saschagrunert/avionics-panel/renders/1-hero.png

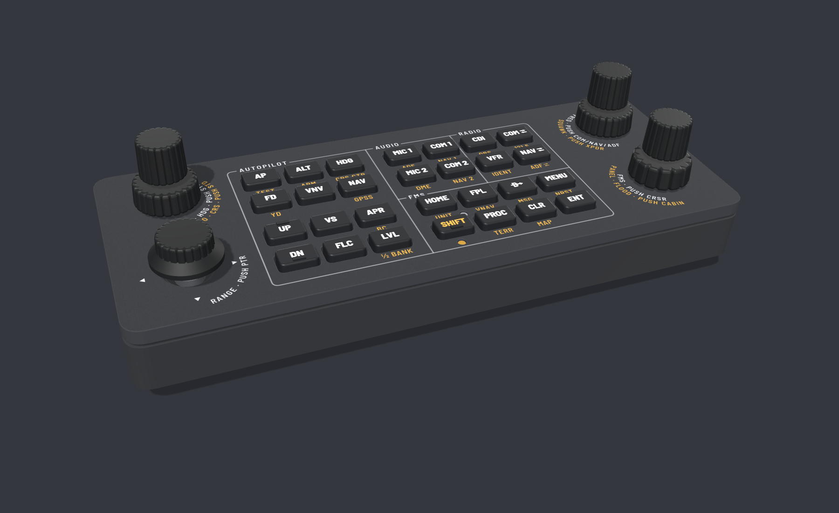
renders/1-hero.png
