saschagrunert/avionics-panel/renders/3-exploded.png

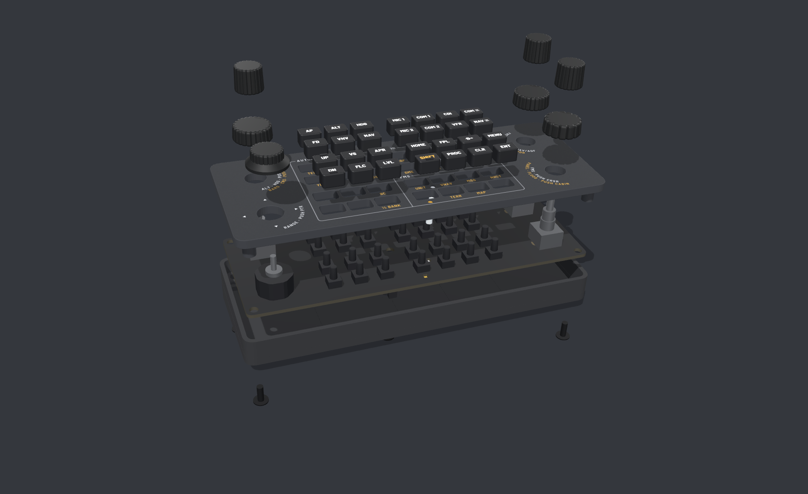
renders/3-exploded.png
