saschagrunert/avionics-panel/renders/4-seated.png

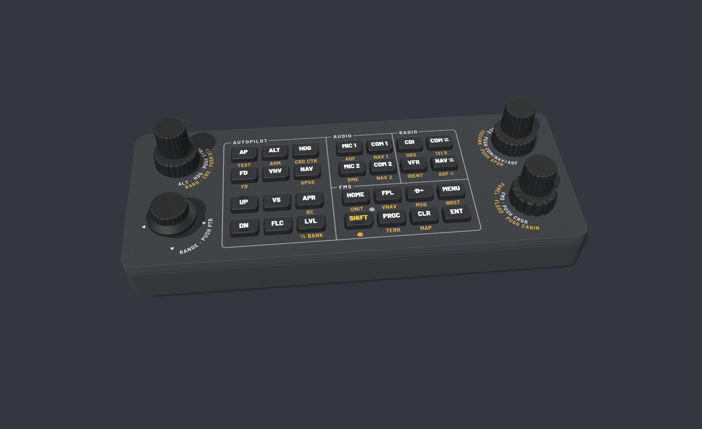
renders/4-seated.png
