saschagrunert/avionics-panel/renders/5-pcb-top.png

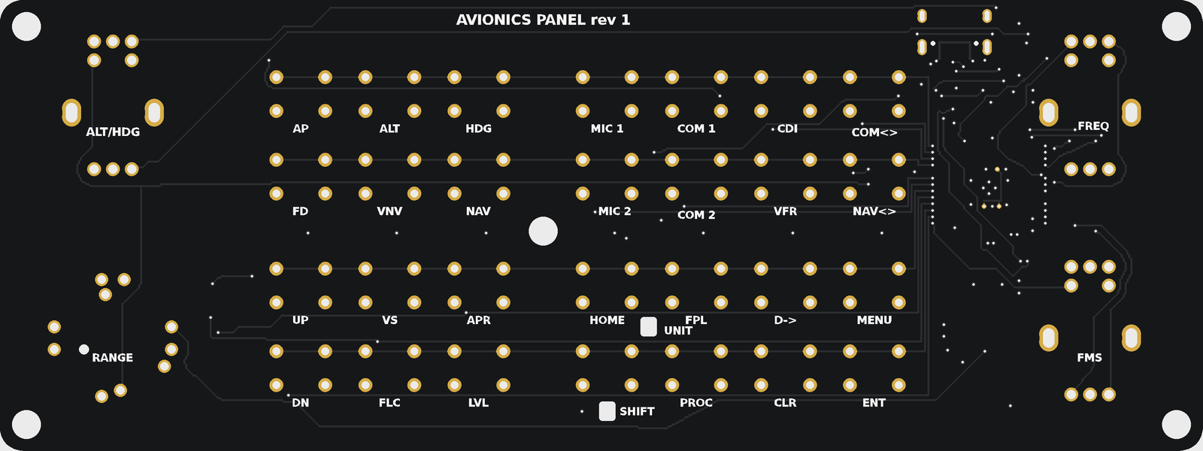
renders/5-pcb-top.png
