saschagrunert/avionics-panel/renders/6-pcb-bottom.png

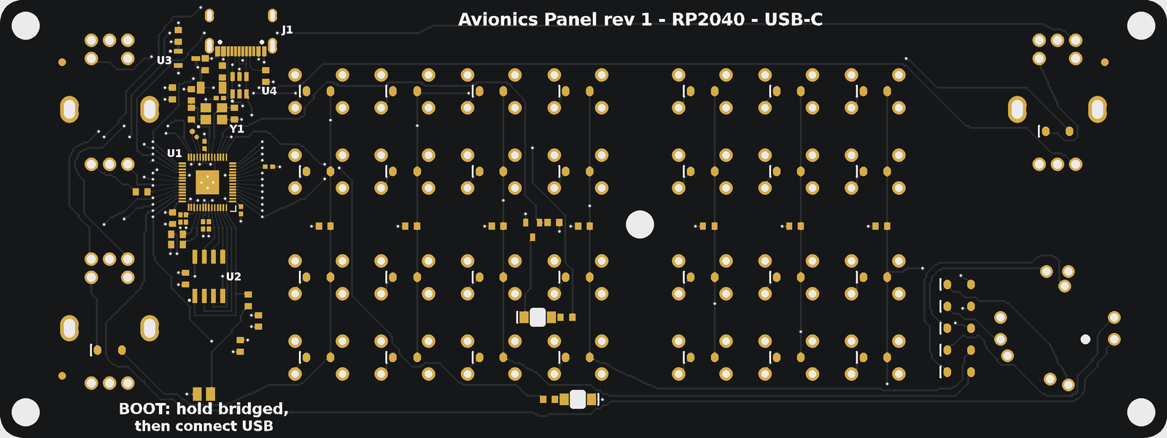
renders/6-pcb-bottom.png
