saschagrunert/avionics-panel/renders/7-plate-artwork.png

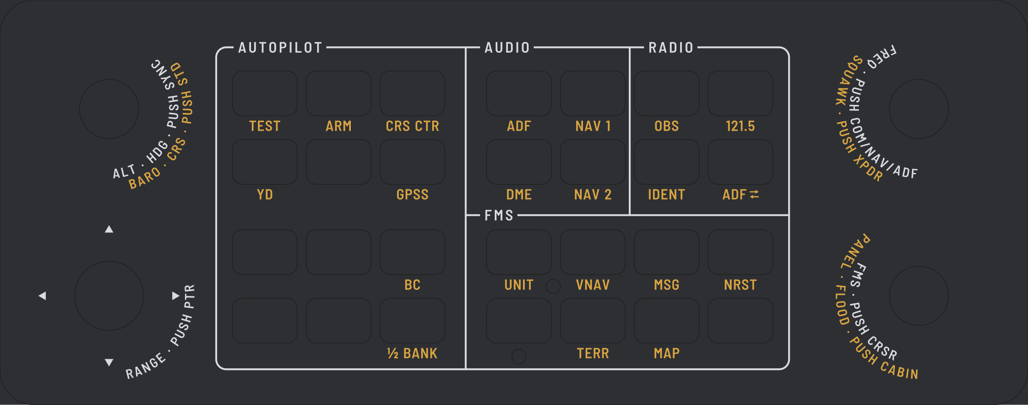
renders/7-plate-artwork.png
