saschagrunert/avionics-panel/renders/8-fit-check.png

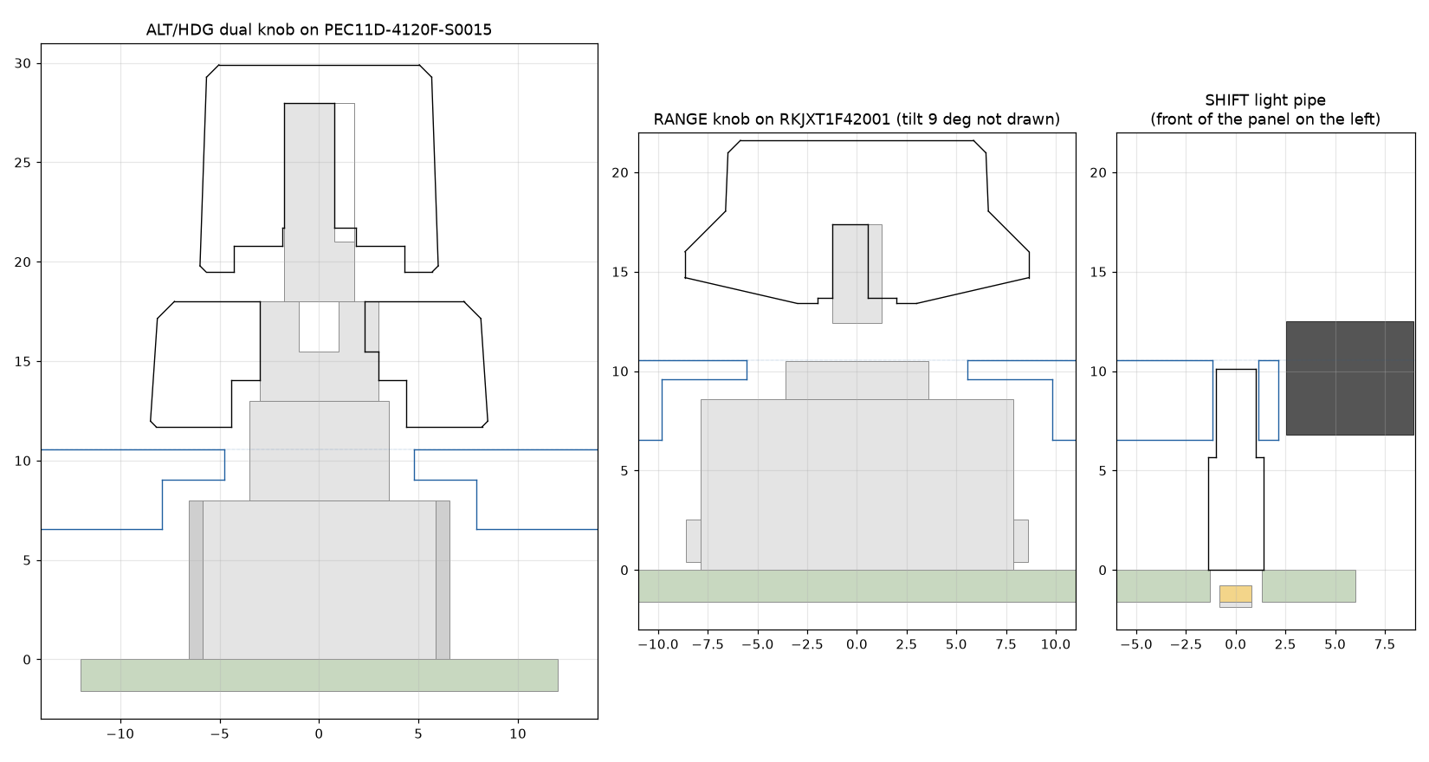
renders/8-fit-check.png
