saschagrunert/avionics-panel/renders/9-bottom.png

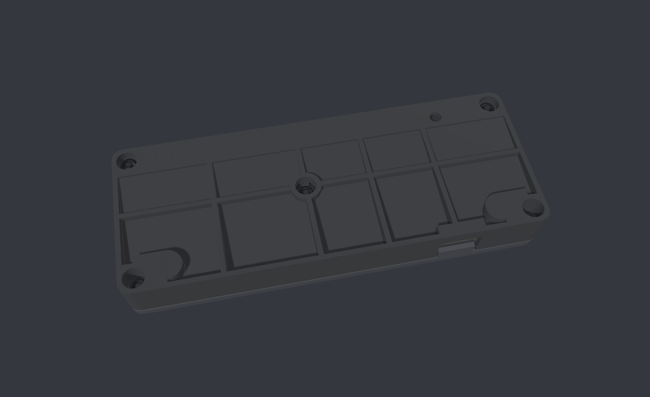
renders/9-bottom.png
