saschagrunert/avionics-panel/production/avionics-panel-rev1-BOM-full.csv

Comment | Designator | Footprint | LCSC Part # | Quantity
1N4148W | DK00,DK01,DK02,DK03,DK04,DK05,DK06,DK10,DK11,DK12,DK13,DK14,DK15,DK16,DK20,DK21,DK22,DK23,DK24,DK25,DK26,DK30,DK31,DK32,DK33,DK34,DK35,DK36,D_FMS,D_ALTHDG,D_RANGE_A,D_RANGE_B,D_RANGE_C,D_RANGE_D,D_RANGE_COM | SOD-123 | C81598 | 35
10k | R_PU0,R_PU1,R_PU2,R_PU3,R_PU4,R_PU5,R_PU6,R_UNIT_PD | 0603 | C25804 | 8
LTST-C230KSKT | LED_SHIFT | 1206 reverse | C125108 | 1
75R | R_SHIFT | 0603 | C4275 | 1
LTW-C230DS | LED_UNIT | 1206 reverse | C575513 | 1
390R | R_UNIT | 0603 | C23151 | 1
2N7002 | Q_UNIT | SOT-23 | C8545 | 1
RP2040 | U1 | LQFN-56 7x7 | C2040 | 1
1k | R_GP25,R_BOOT,R_X | 0603 | C21190 | 3
5.1k | R_CC1 | 0603 | C23186 | 1
5.1k | R_CC2 | 0402 | C25905 | 1
SRV05-4 | U4 | SOT-23-6 | C7420376 | 1
1R | R_IN | 0603 | C22936 | 1
MF-NSMF050-2 | F1 | 1206 | C75464 | 1
TYPE-C-31-M-12 | J1 | USB-C 16P | C165948 | 1
W25Q16JVSNIQ | U2 | SOIC-8 150mil | C2456211 | 1
100nF | C_FL,C_D1,C_D3 | 0603 | C14663 | 3
XC6206P332MR | U3 | SOT-23 | C5446 | 1
10uF | C_IN,C_OUT0 | 0603 | C19702 | 2
ABM8-272-T3 12MHz | Y1 | 3225 4-pad | C20625731 | 1
15pF | C_X1,C_X2 | 0603 | C1644 | 2
1uF | C_1V0 | 0402 | C52923 | 1
100nF | C_1V2,C_1V1,C_IO49,C_IO1,C_IO10,C_IO22 | 0402 | C1525 | 6
27R | R_DM,R_DP | 0603 | C25190 | 2
1uF | C_D2,C_BULK | 0603 | C15849 | 2
1-1825910-4 | K00,K01,K02,K03,K04,K05,K06,K10,K11,K12,K13,K14,K15,K16,K20,K21,K22,K23,K24,K25,K26,K30,K31,K32,K33,K34,K35,K36 | KEY-TH_4P-L6.0-W6.0-P4.50-LS7.5 | C589907 | 28
PEC11D-4120F-S0015 | ENC_ALTHDG,ENC_FREQ,ENC_FMS | RES-ADJ-TH_PEC11D-4120F-S0015 | C19270361 | 3
RKJXT1F42001 | RANGE | SW-TH_RKJXT1F42001 | C160841 | 1
