saschagrunert/avionics-panel/production/avionics-panel-rev1-knob-outer-2.step

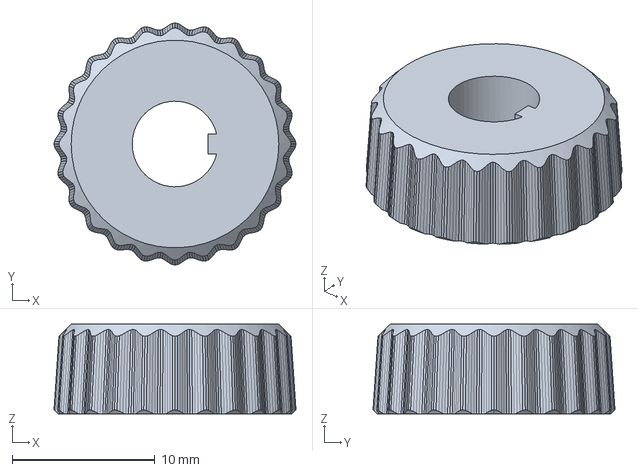
[picture p12: CAD file, 2026-11-13]
production/avionics-panel-rev1-knob-outer-2.step
17.0 x 17.0 x 6.30 mm
