saschagrunert/avionics-panel/production/avionics-panel-rev1-knob-inner-2.step

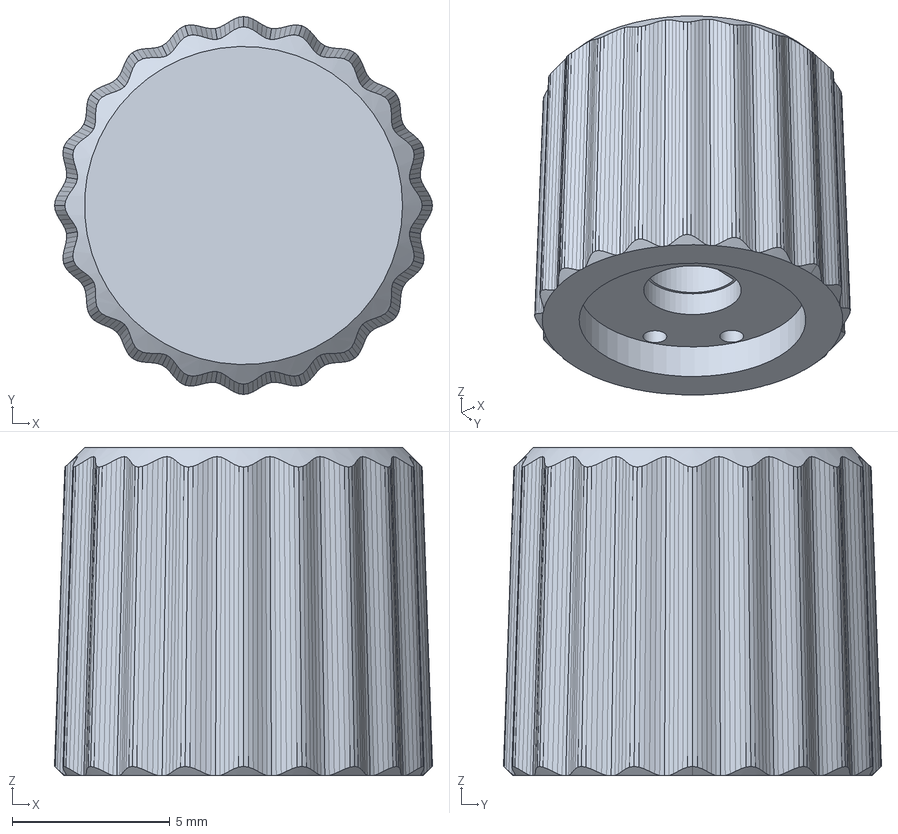
[picture p13: CAD file, 2026-11-13]
production/avionics-panel-rev1-knob-inner-2.step
12.0 x 12.0 x 10.4 mm
