saschagrunert/avionics-panel/production/avionics-panel-rev1-knob-inner-5.step

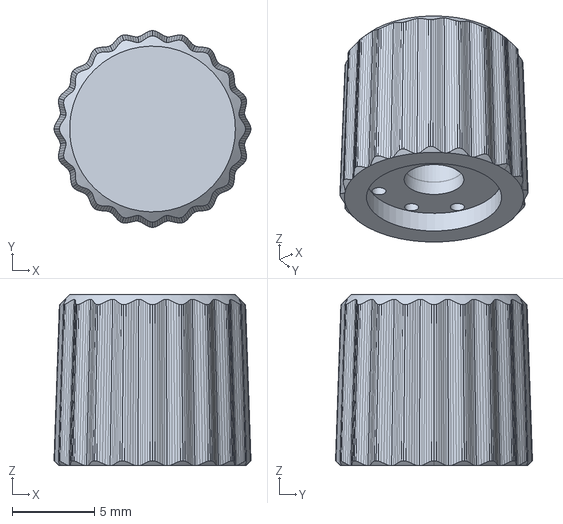
[picture p14: CAD file, 2026-11-13]
production/avionics-panel-rev1-knob-inner-5.step
12.0 x 12.0 x 10.4 mm
