saschagrunert/avionics-panel/production/avionics-panel-rev1-knob-range-4.step

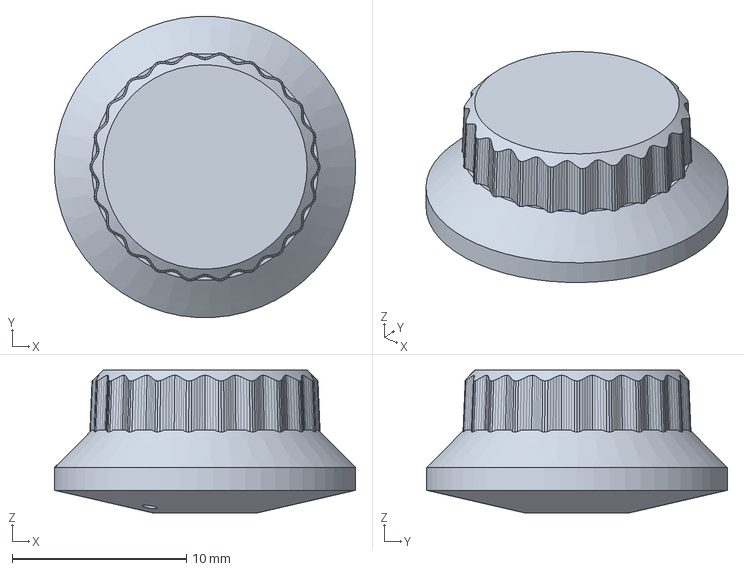
[picture p15: CAD file, 2026-11-13]
production/avionics-panel-rev1-knob-range-4.step
17.3 x 17.3 x 8.20 mm
