saschagrunert/avionics-panel/production/avionics-panel-rev1-knob-range-5.step

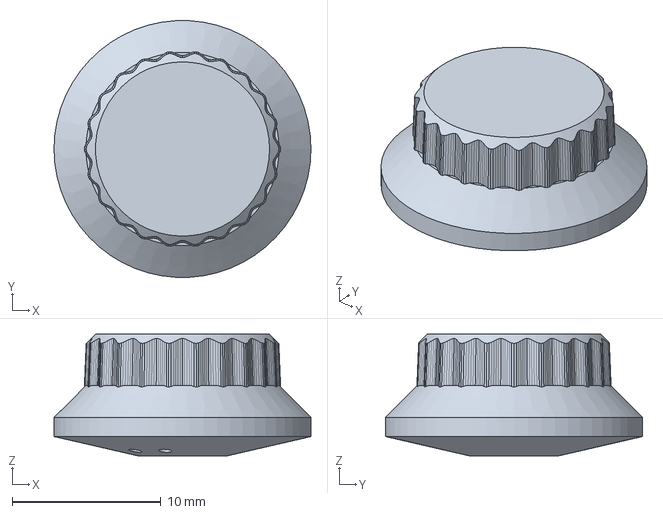
[picture p16: CAD file, 2026-11-13]
production/avionics-panel-rev1-knob-range-5.step
17.3 x 17.3 x 8.20 mm
