saschagrunert/avionics-panel/production/avionics-panel-rev1-knob-range-1.step

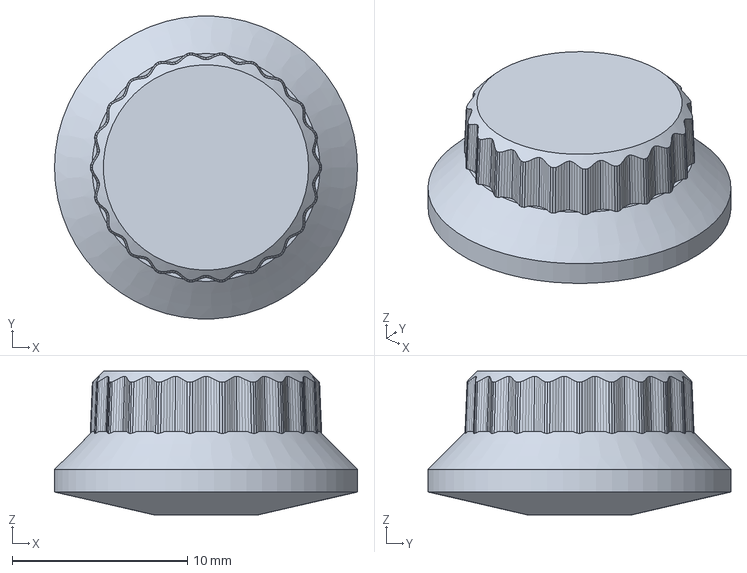
[picture p17: CAD file, 2026-11-13]
production/avionics-panel-rev1-knob-range-1.step
17.3 x 17.3 x 8.20 mm
