saschagrunert/avionics-panel/production/avionics-panel-rev1-knob-outer-fms-4.step

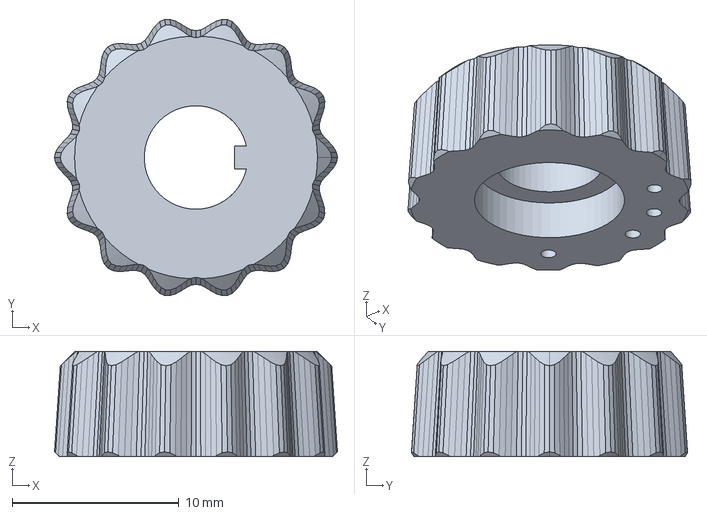
[picture p18: CAD file, 2026-11-13]
production/avionics-panel-rev1-knob-outer-fms-4.step
17.0 x 16.6 x 6.30 mm
