saschagrunert/avionics-panel/production/avionics-panel-rev1-knob-outer-5.step

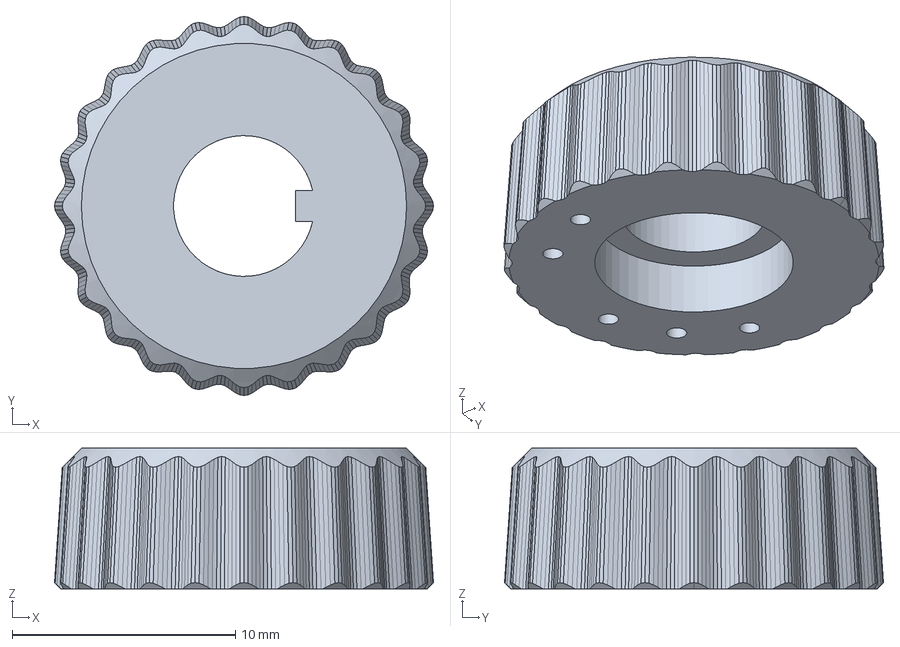
[picture p19: CAD file, 2026-11-13]
production/avionics-panel-rev1-knob-outer-5.step
17.0 x 17.0 x 6.30 mm
