saschagrunert/avionics-panel/production/avionics-panel-rev1-lightpipes.step

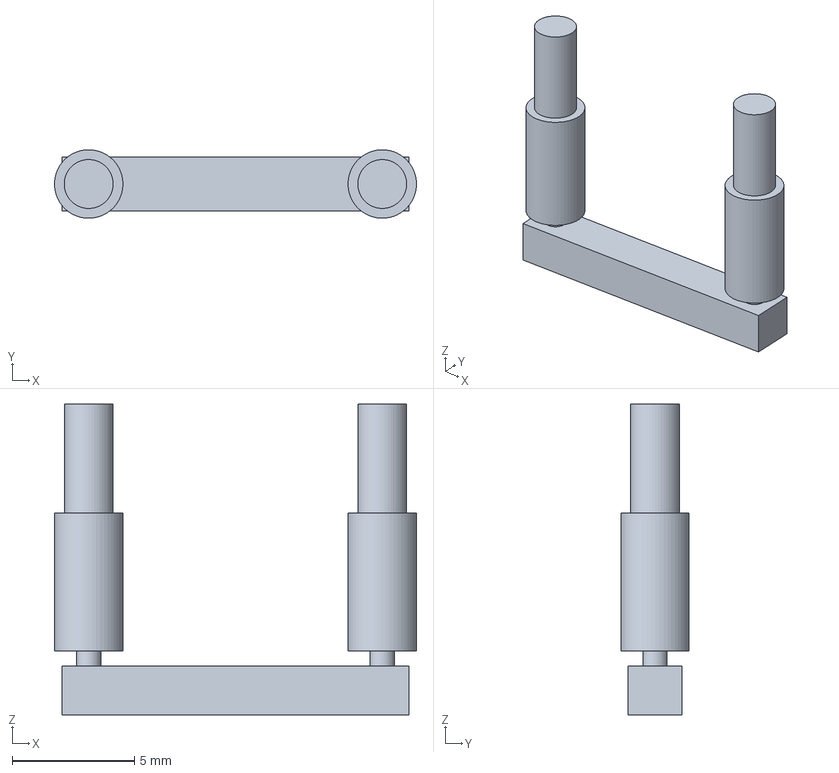
[picture p20: CAD file, 2026-11-13]
production/avionics-panel-rev1-lightpipes.step
14.8 x 2.80 x 12.7 mm
