saschagrunert/avionics-panel/production/avionics-panel-rev1-body.step

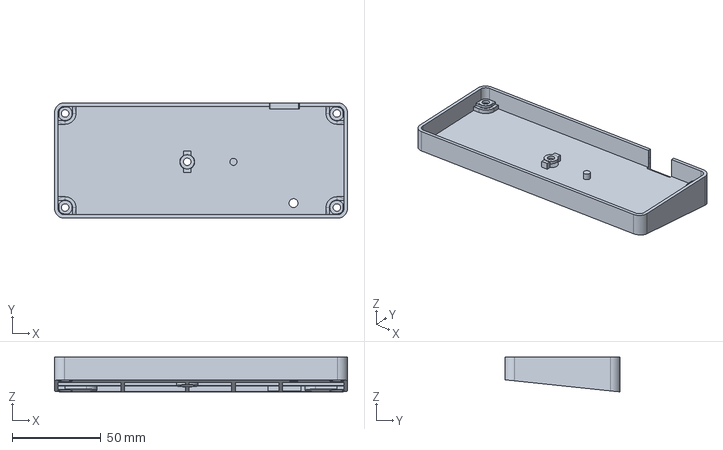
[picture p21: CAD file, 2026-11-13]
production/avionics-panel-rev1-body.step
165.0 x 65.0 x 19.6 mm
