saschagrunert/avionics-panel/production/avionics-panel-rev1-plate.step

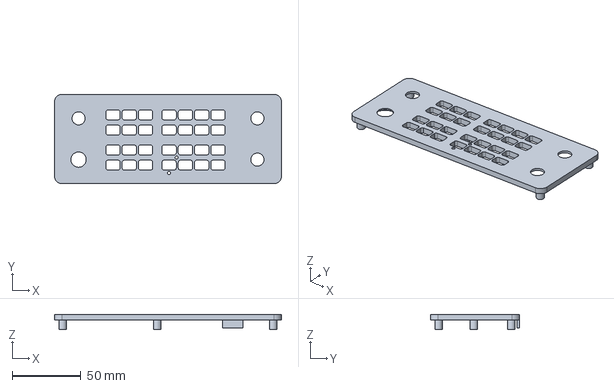
[picture p22: CAD file, 2026-11-13]
production/avionics-panel-rev1-plate.step
165.0 x 65.0 x 10.6 mm
