saschagrunert/avionics-panel/production/avionics-panel-rev1-knob-inner-tight.step

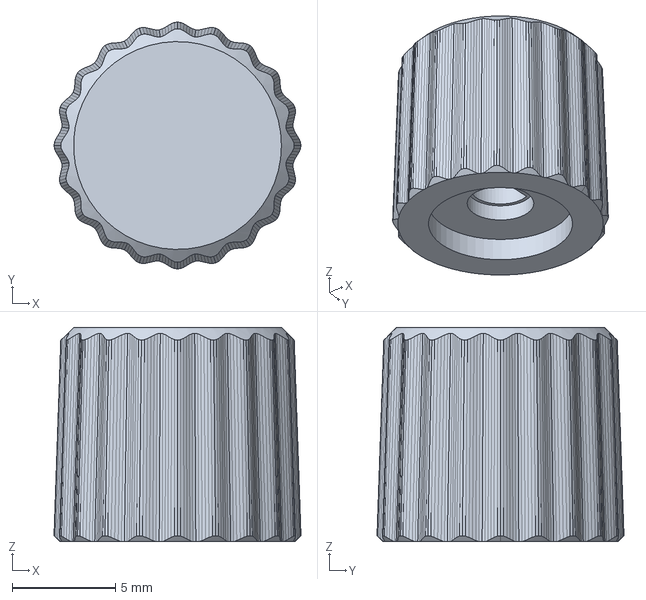
[picture p23: CAD file, 2026-11-12]
production/avionics-panel-rev1-knob-inner-tight.step
12.0 x 12.0 x 10.4 mm
