saschagrunert/avionics-panel/(list of files, cad)

Other CAD files:
production/avionics-panel-rev1-knob-inner-4.step
production/avionics-panel-rev1-knob-outer-fms-5.step
production/avionics-panel-rev1-knob-outer-fms-2.step
production/avionics-panel-rev1-knob-outer-4.step
production/avionics-panel-rev1-knob-outer-fms-3.step
production/avionics-panel-rev1-knob-range-2.step
production/avionics-panel-rev1-knob-inner-3.step
production/avionics-panel-rev1-knob-outer-fms-1.step
production/avionics-panel-rev1-knob-outer-1.step
production/avionics-panel-rev1-knob-outer-3.step
production/avionics-panel-rev1-knob-inner-1.step
production/avionics-panel-rev1-knob-range-3.step
production/avionics-panel-rev1-knob-outer-loose.step
production/avionics-panel-rev1-knob-outer-tight.step
production/avionics-panel-rev1-knob-outer.step
production/avionics-panel-rev1-knob-inner-loose.step
production/avionics-panel-rev1-knob-inner.step
production/avionics-panel-rev1-plate.dxf
