saschagrunert/avionics-panel/docs/architecture/avionics-panel-rev1-schematic.pdf

## Avionics Panel rev 1, schematic

## Sheet 1 of 4: USB-C and power

Drawn from the netlist of pcb/board.py (make_schematic.py)

USB-C (device): 5.1k pull-downs on CC1 and CC2, the D+ and D- pairs joined on the board, so either plug orientation works

### 3.3 V regulator

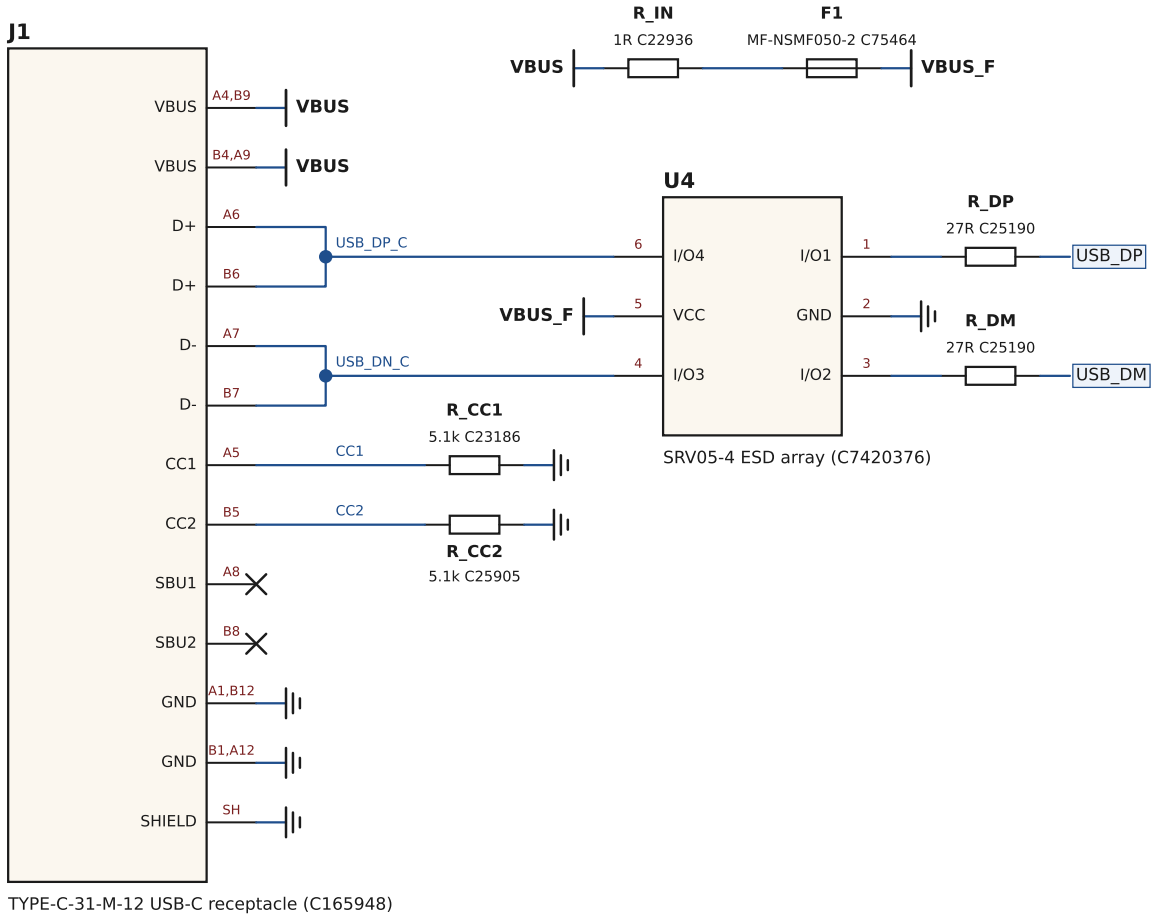
[picture p24: figure]
TYPE-C-31-M-12 USB-C receptacle (C165948); VBUS; SBU1; SBU2; GND; SHIELD; SRV05-4 ESD array (C7420376); VBUS_F; VCC; USB_DP_C; USB_DP; USB_DN_C; USB_DM; MF-NSMF050-2 C75464

U3

XC6206P332MR (C5446)

3
VBUS_F | VIN

2
VOUT | 3V3

1

VSS

C_IN

10uF C19702

VBUS_F

C_OUT0

10uF C19702

3V3

### Decoupling, placed at the RP2040 and the flash; the 3V3 and GND inner planes connect them

C_BULK

1uF C15849

3V3

C_D1

100nF C14663

3V3

C_D2

1uF C15849

3V3

C_D3

100nF C14663

3V3

C_FL

100nF C14663

3V3

C_IO1

100nF C1525

3V3

C_IO10

100nF C1525

3V3

C_IO22

100nF C1525

3V3

C_IO49

100nF C1525

3V3

C_1V0

1uF C52923

1V1

C_1V1

100nF C1525

1V1

C_1V2

100nF C1525

1V1

C_IO1, C_IO10, C_IO22, C_IO49: one at each IOVDD pin but 33 (C_IO49 also USB_VDD); C_D2 (1 uF):

IOVDD 42, ADC_AVDD and VREG_VIN. C_D1, C_D3, C_BULK: on the 3V3 plane, shared by IOVDD 33. C_FL: flash VCC. C_1V0 to C_1V2: DVDD and VREG_VOUT (the RP2040's internal 1.1 V core regulator).

U4 takes D+ and D- through two channels each. R_IN (1 ohm) damps the hot-plug ringing on C_IN
and gives way first on a short on VBUS_F (U4's clamp included); F1 (0.5 A PTC) covers slow

overloads.

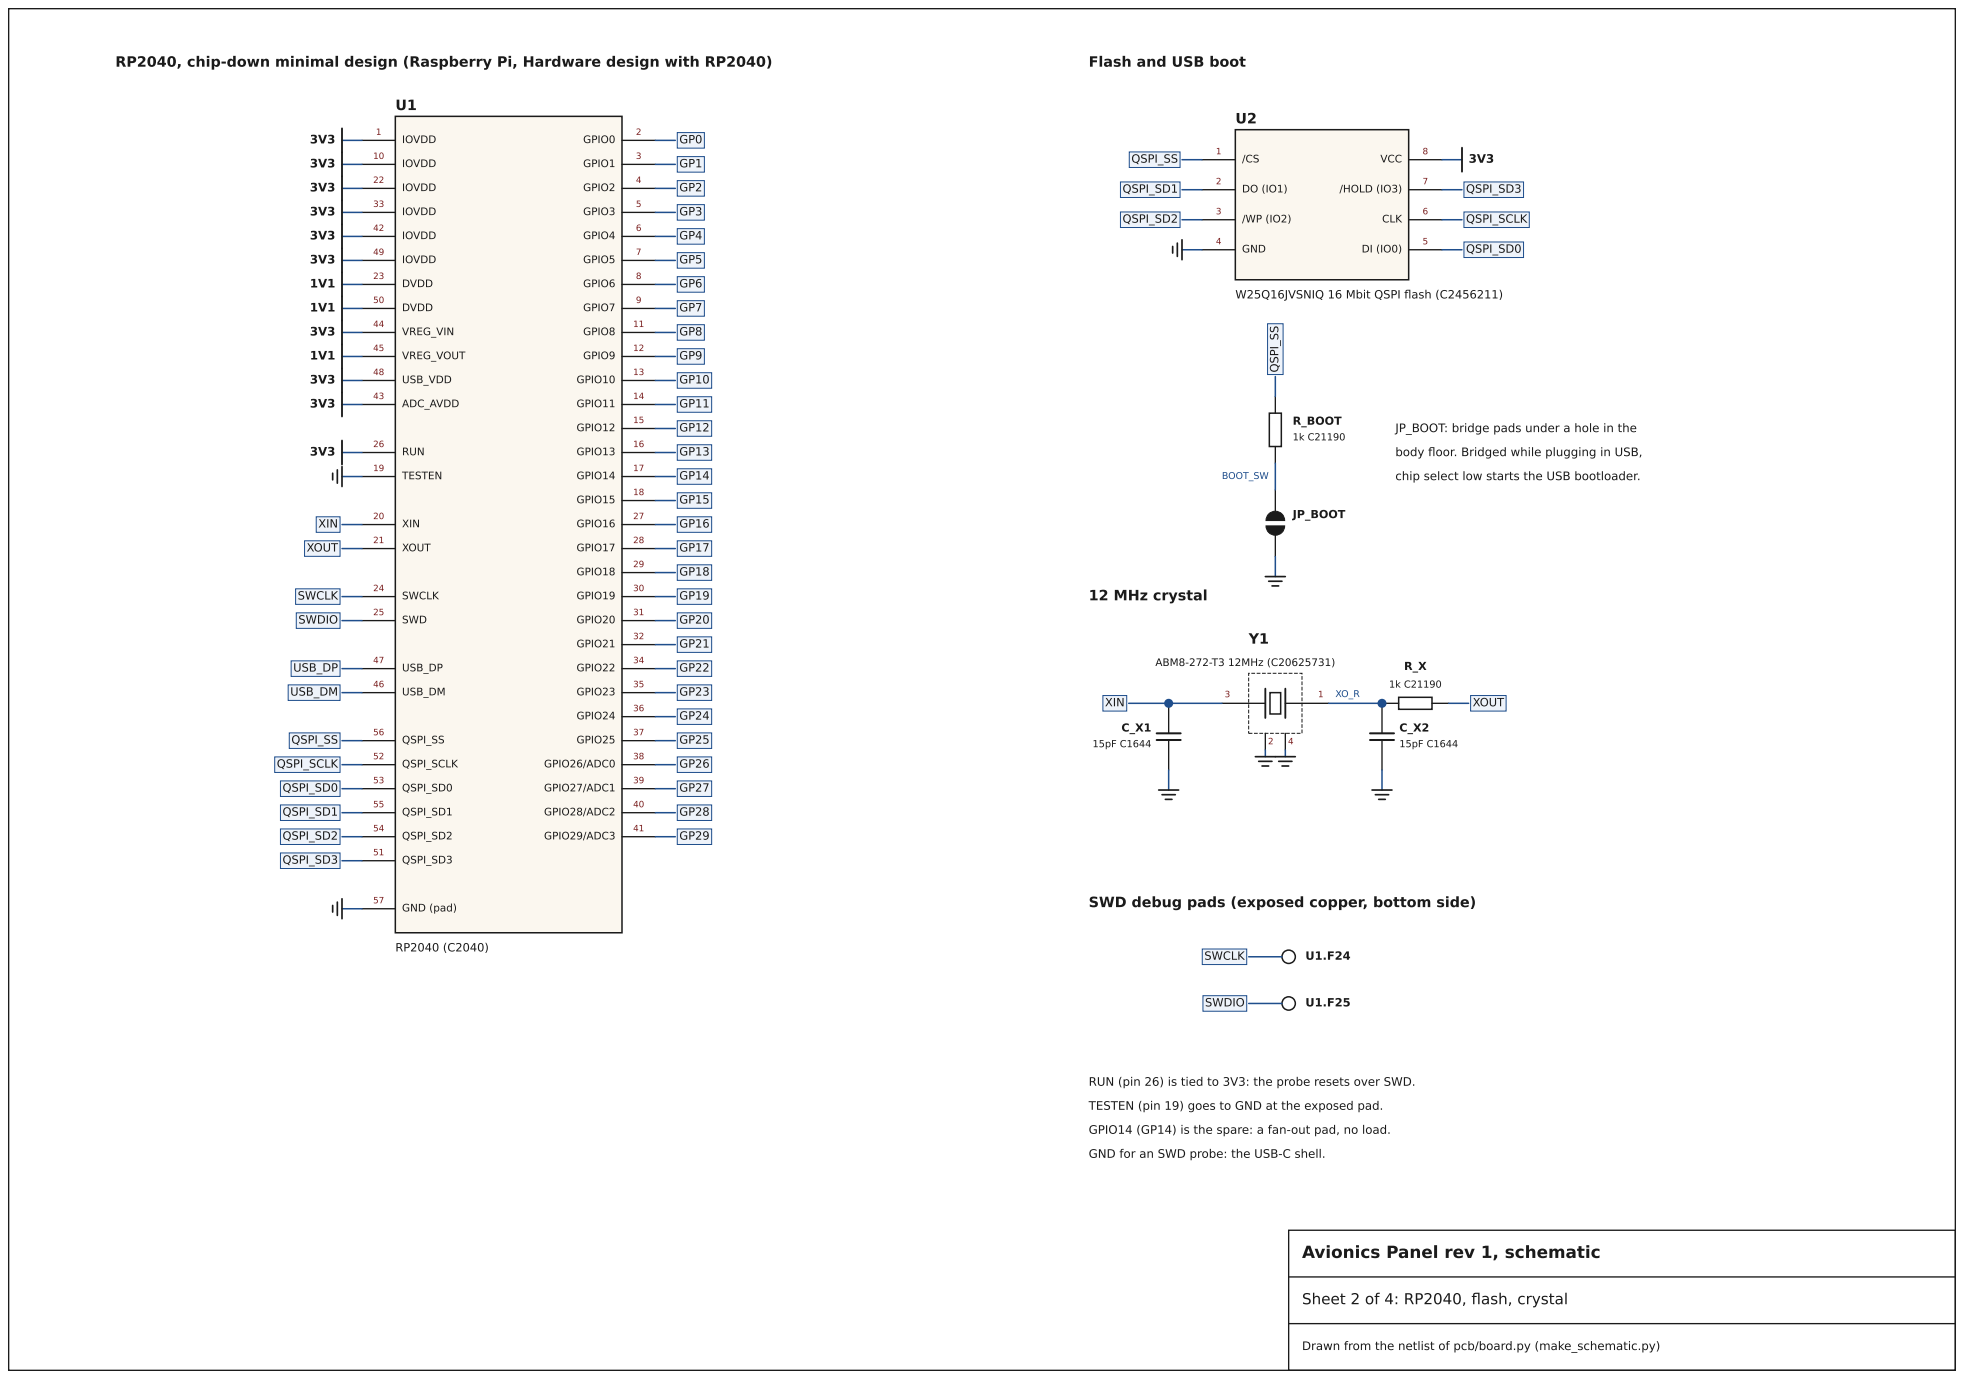
[picture p25: page 2]
IOVDD; DVDD; VREG_VIN; VREG_VOUT; USB_VDD; ADC_AVDD; RUN; TESTEN; XIN; 21 XOUT; XOUT; 24 SWCLK; SWCLK; 25 SWDIO; SWD; 47 USB_DP; USB_DP; 46 USB_DM; USB_DM; 56 QSPI_SS; QSPI_SS; 52 QSPI_SCLK; QSPI_SCLK; 53 QSPI_SD0; QSPI_SD0; 55 QSPI_SD1; QSPI_SD1; 54 QSPI_SD2; QSPI_SD2; 51 QSPI_SD3; QSPI_SD3; GND (pad); GPIO0; GPIO1; GPIO2; GPIO3; GPIO4; GPIO5; GPIO6; GPIO7; GPIO8; GPIO9; GPIO10; GPIO11; GPIO12; GPIO13; GPIO14; GPIO15; GPIO16; GPIO17; GPIO18; GPIO19; GPIO20; GPIO21; GPIO22; GPIO23; GPIO24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

RP2040, chip-down minimal design (Raspberry Pi, Hardware design with RP2040)

Flash and USB boot

W25Q16JVSNIQ 16 Mbit QSPI flash (C2456211)

JP_BOOT: bridge pads under a hole in the
body floor. Bridged while plugging in USB,

chip select low starts the USB bootloader.

SWD debug pads (exposed copper, bottom side)

RUN (pin 26) is tied to 3V3: the probe resets over SWD.

TESTEN (pin 19) goes to GND at the exposed pad.

GPIO14 (GP14) is the spare: a fan-out pad, no load.

GND for an SWD probe: the USB-C shell.

Avionics Panel rev 1, schematic

Sheet 2 of 4: RP2040, flash, crystal

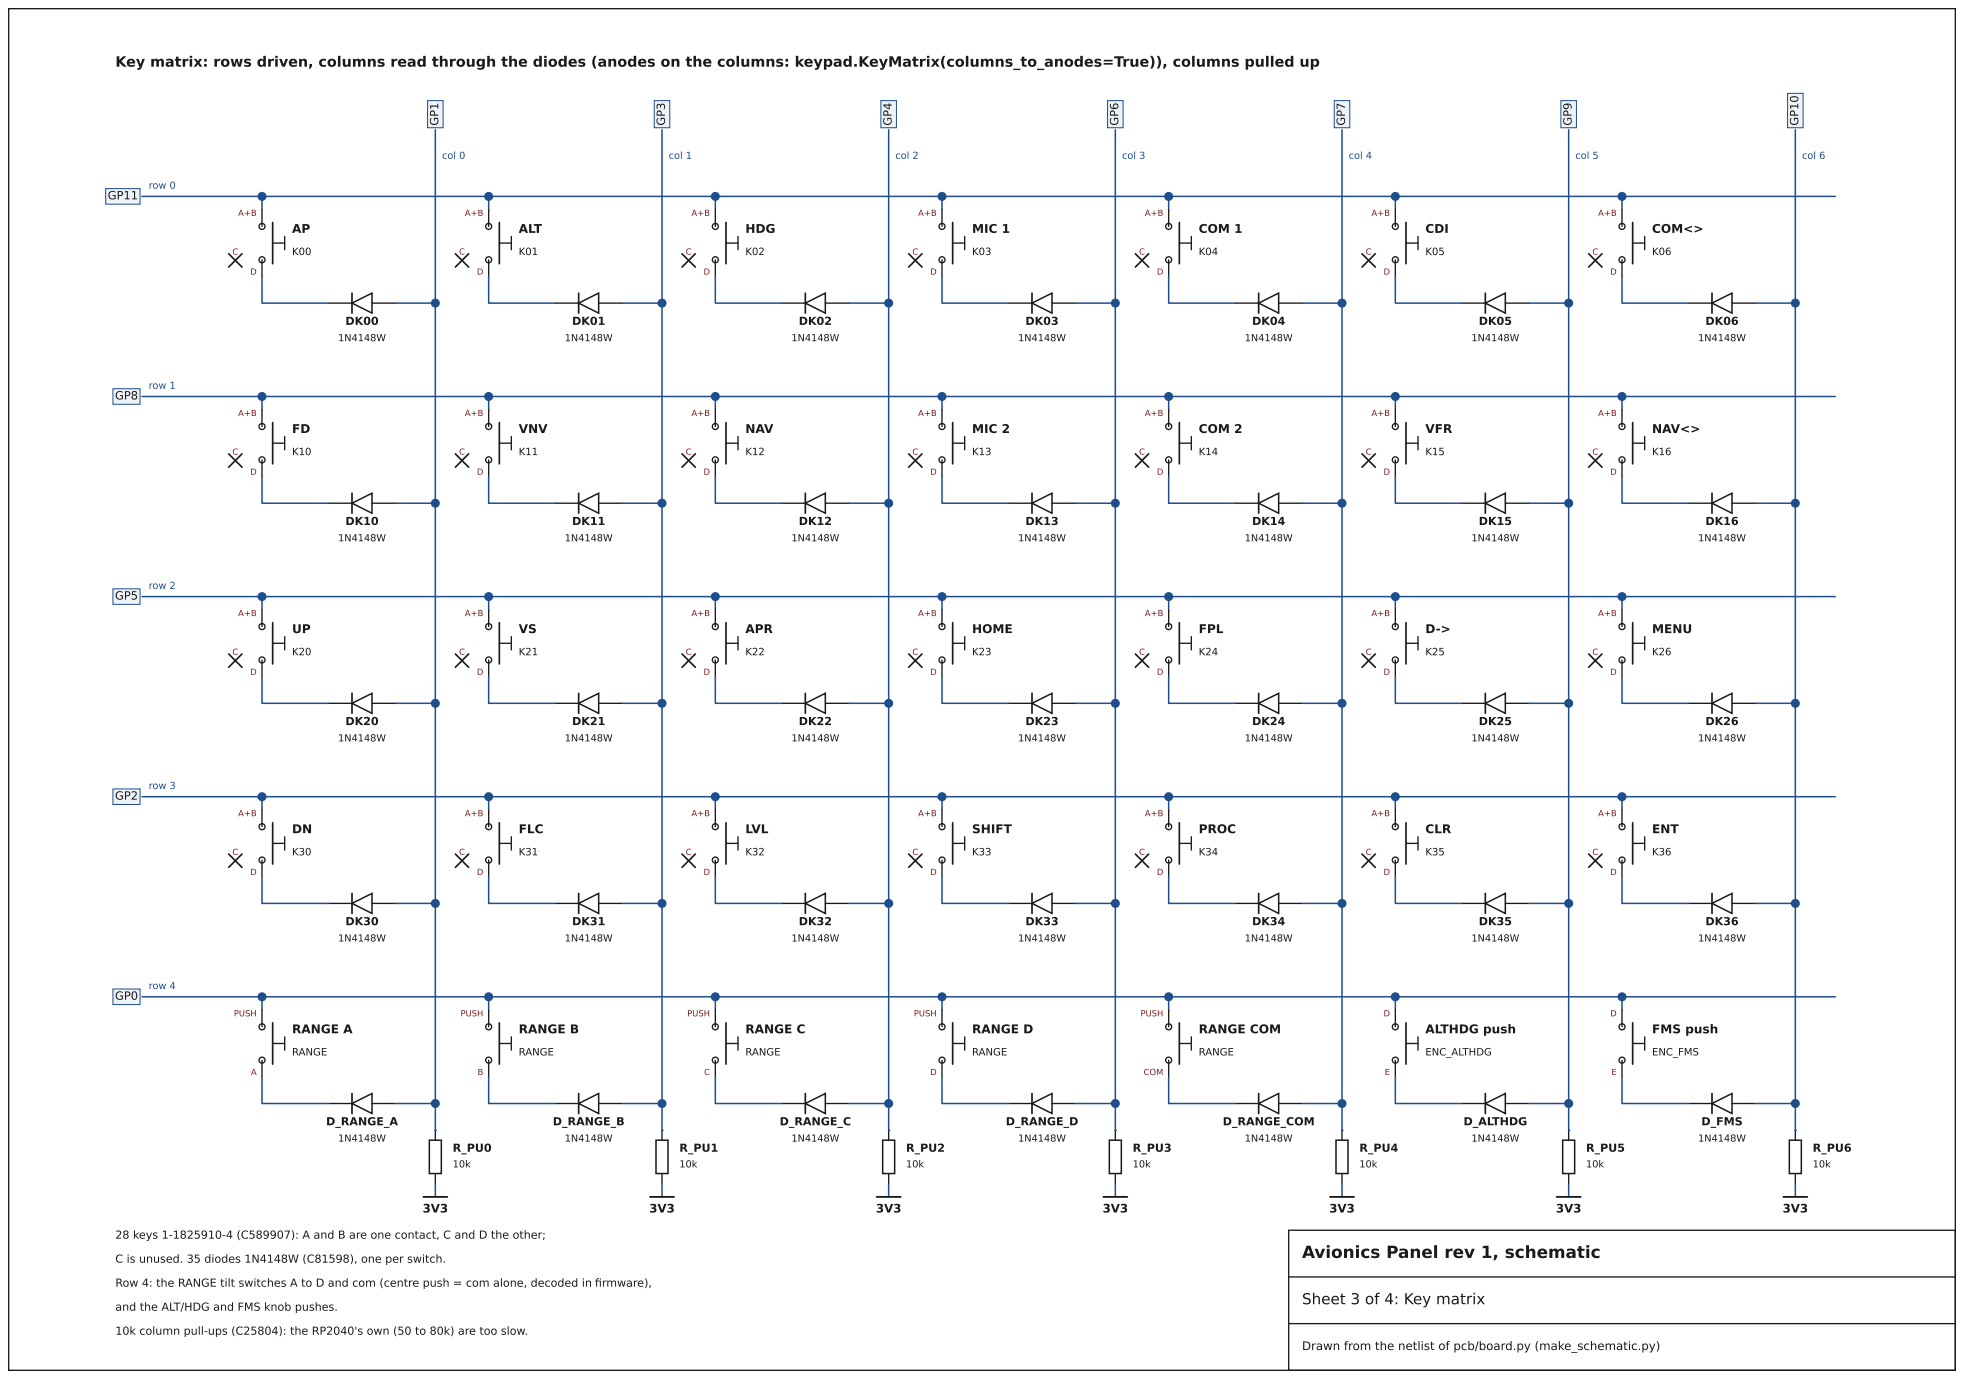
[picture p26: page 3]
row 0; row 1; row 2; row 3; row 4; GP1 col 0; GP3 col 1; GP4 col 2; GP6 col 3; GP7 col 4; GP9 col 5; GP10 col 6; ALT; HDG; MIC 1; COM 1; CDI; COM<>; VNV; NAV; MIC 2; COM 2; VFR; NAV<>; APR; HOME; FPL; MENU; FLC; LVL; SHIFT; PROC; CLR; ENT; D_ALTHDG; ALTHDG push; ENC_ALTHDG; D_FMS; FMS push; ENC_FMS; PUSH; D_RANGE_A; RANGE A; RANGE; D_RANGE_B; RANGE B; D_RANGE_C; RANGE C; COM; D_RANGE_COM; RANGE COM; D_RANGE_D; RANGE D

Key matrix: rows driven, columns read through the diodes (anodes on the columns: keypad.KeyMatrix(columns_to_anodes=True)), columns pulled up

28 keys 1-1825910-4 (C589907): A and B are one contact, C and D the other;

Avionics Panel rev 1, schematic

C is unused. 35 diodes 1N4148W (C81598), one per switch.
Row 4: the RANGE tilt switches A to D and com (centre push = com alone, decoded in firmware),

Sheet 3 of 4: Key matrix

and the ALT/HDG and FMS knob pushes.

10k column pull-ups (C25804): the RP2040's own (50 to 80k) are too slow.

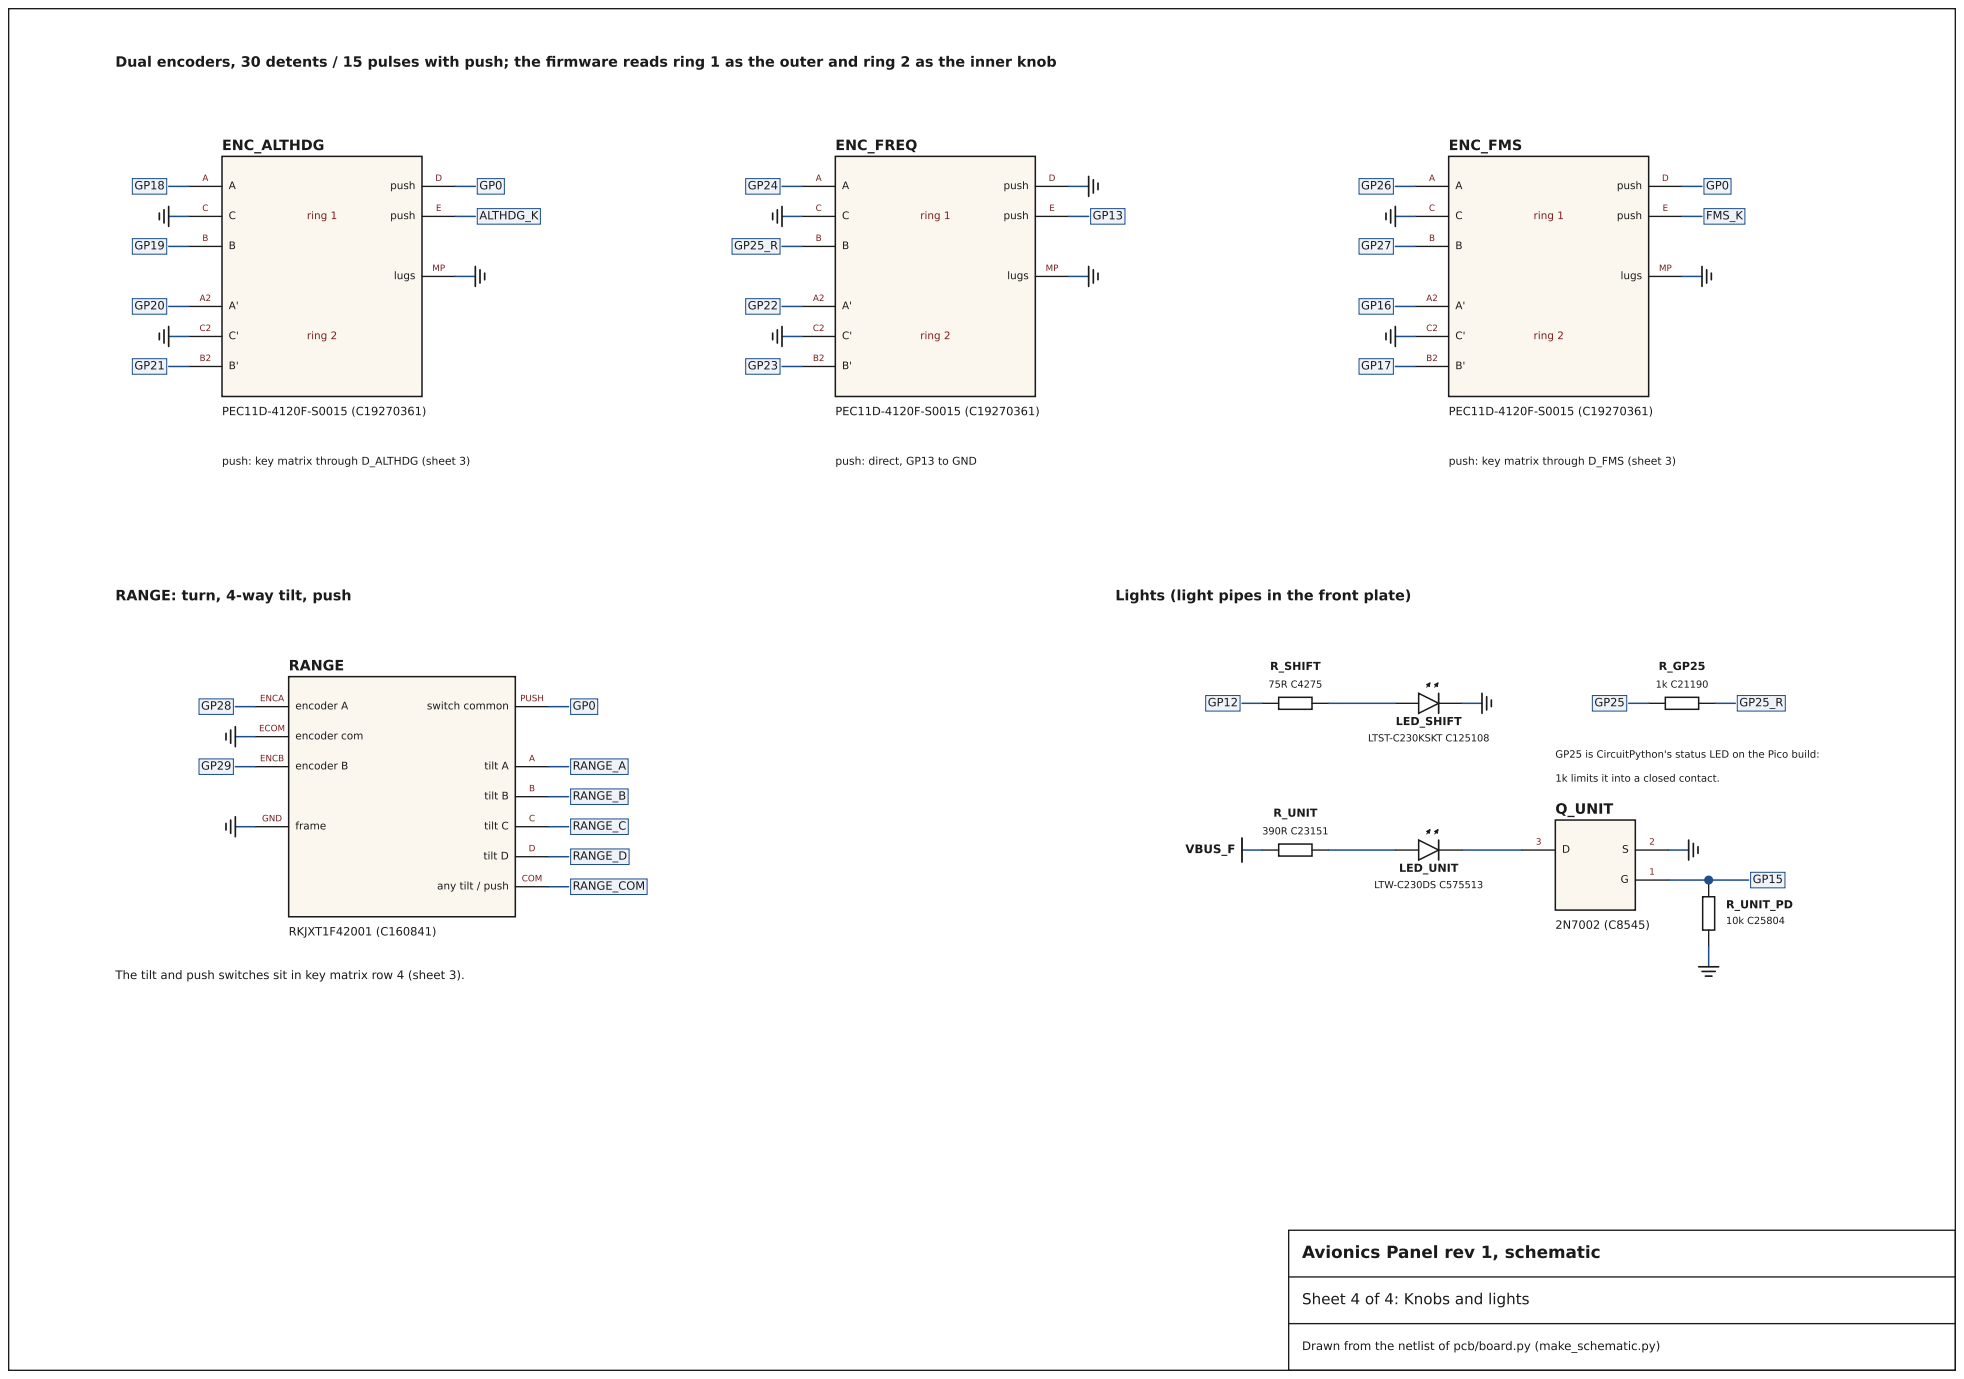
[picture p27: page 4]
ENC_ALTHDG; PEC11D-4120F-S0015 (C19270361); push; ALTHDG_K; lugs; ring 1; ring 2; ENC_FREQ; ENC_FMS; FMS_K; RANGE; RKJXT1F42001 (C160841); ENCA GP28; encoder A; ECOM; encoder com; ENCB GP29; encoder B; GND; frame; PUSH; switch common; tilt A; RANGE_A; tilt B; RANGE_B; tilt C; RANGE_C; tilt D; RANGE_D; COM; any tilt / push; RANGE_COM; R_SHIFT; LED_SHIFT; LTST-C230KSKT C125108; R_UNIT; VBUS_F; LED_UNIT; LTW-C230DS C575513; Q_UNIT; R_UNIT_PD

Dual encoders, 30 detents / 15 pulses with push; the firmware reads ring 1 as the outer and ring 2 as the inner knob

push: key matrix through D_ALTHDG (sheet 3)

push: direct, GP13 to GND

push: key matrix through D_FMS (sheet 3)

RANGE: turn, 4-way tilt, push

Lights (light pipes in the front plate)

GP25 is CircuitPython's status LED on the Pico build:

1k limits it into a closed contact.

The tilt and push switches sit in key matrix row 4 (sheet 3).

Avionics Panel rev 1, schematic

Sheet 4 of 4: Knobs and lights
