saschagrunert/avionics-panel/mech/check_fit.py

"""The fit check of the assembled stack: one printed row per fit, with its margin at the worst end of every
tolerance it names, measured on the generated files (the plate, knobs, light pipes, caps and body) where the
row says so. A margin that is not over zero fails the build (report()). The rows that carry a doc make the table
of the main margins in docs/architecture/mechanics.md (write_fits_table()).

Also draws cross-sections through the ALT/HDG knob, the RANGE knob and the SHIFT light pipe -> fit-check.png (XZ
plane, z = 0 is the PCB top). Grey: PCB and part outlines from the datasheets. Blue: plate. Black: printed parts.
"""
import functools
import io
import itertools
import math
import os
import re
import sys
import zipfile
from pathlib import Path

import matplotlib

matplotlib.use("Agg")
import matplotlib.pyplot as plt
import numpy as np
from matplotlib.patches import Rectangle
from OCC.Core.BRepAdaptor import BRepAdaptor_Curve
from OCC.Core.BRepAlgoAPI import BRepAlgoAPI_Section
from OCC.Core.BRepBuilderAPI import BRepBuilderAPI_Transform
from OCC.Core.GCPnts import GCPnts_QuasiUniformDeflection
from OCC.Core.gp import gp_Ax1, gp_Ax2, gp_Dir, gp_Pln, gp_Pnt, gp_Trsf
from OCC.Core.IFSelect import IFSelect_RetDone
from OCC.Core.STEPControl import STEPControl_Reader
from OCC.Core.TopAbs import TopAbs_EDGE
from OCC.Core.TopExp import TopExp_Explorer
from OCC.Core.TopoDS import topods
from PIL import Image
from shapely.geometry import Point, Polygon

HERE = Path(__file__).resolve().parent              # works from any directory
sys.path[:0] = [str(HERE), str(HERE.parent / "pcb")]
import board as B  # noqa: E402
import make_knobs as K  # noqa: E402
import make_mech as MM  # noqa: E402
import make_plate_art as PA  # noqa: E402
import make_plate_step as PS  # noqa: E402
import stack as S  # noqa: E402
from geom import item_dist, pad_geom, stroke_width  # noqa: E402
from occ_util import common, face_meshes, move, rrect_prism, volume  # noqa: E402


def section(shape, y):
    sec = BRepAlgoAPI_Section(shape, gp_Pln(gp_Pnt(0, y, 0), gp_Dir(0, 1, 0)))
    sec.Build()
    ex = TopExp_Explorer(sec.Shape(), TopAbs_EDGE)
    while ex.More():
        c = BRepAdaptor_Curve(topods.Edge(ex.Current()))
        d = GCPnts_QuasiUniformDeflection(c, 0.005)
        if d.IsDone() and d.NbPoints() > 1:
            pts = [d.Value(i + 1) for i in range(d.NbPoints())]
            yield [p.X() for p in pts], [p.Z() for p in pts]
        ex.Next()


def draw(ax, shape, y, colour, lw=0.9, dx=0.0, dz=0.0):
    for xs, zs in section(shape, y):
        ax.plot([x + dx for x in xs], [z + dz for z in zs], color=colour, lw=lw)


def part(ax, x0, z0, w, h, **kw):
    ax.add_patch(Rectangle((x0, z0), w, h, fc=kw.get("fc", "#e4e4e4"), ec=kw.get("ec", "#888"), lw=0.6))


def draw_sections(plate, outer, inner, range_knob):
    """fit-check.png: the sections through the ALT/HDG knob, the RANGE knob and the SHIFT light pipe."""
    fig, axes = plt.subplots(1, 3, figsize=(15, 8), gridspec_kw={"width_ratios": [28, 22, 15]})

    # ---- ALT/HDG dual knob ----
    ax = axes[0]
    cx, cy = PS.P(*B.ALTHDG)
    draw(ax, plate, cy, "#1f5fa0", dx=-cx, dz=S.PLATE_Z0)
    part(ax, -12, -S.PCB_T, 24, S.PCB_T, fc="#c8d8c0")
    part(ax, -S.EC11_SIZE[0] / 2, 0, S.EC11_SIZE[0], S.EC11_BODY)
    for sx in (-1, 1):                                          # side lugs: 13.1 across (PEC11D drawing)
        part(ax, sx * S.EC11_LUGS / 2 - (sx > 0) * 0.7, 0, 0.7, S.EC11_BODY, fc="#cfcfcf")
    part(ax, -S.SLEEVE_D / 2, S.EC11_BODY, S.SLEEVE_D, S.SLEEVE_TOP - S.EC11_BODY)
    part(ax, -S.OUTER_D / 2, S.SLEEVE_TOP, S.OUTER_D, S.OUTER_TOP - S.SLEEVE_TOP)
    part(ax, -S.SLOT_W / 2, S.OUTER_TOP - S.SLOT_LEN, S.SLOT_W, S.SLOT_LEN, fc="white")
    part(ax, -S.INNER_D / 2, S.OUTER_TOP, S.INNER_D, S.INNER_TOP - S.OUTER_TOP)
    part(ax, S.INNER_FLAT - S.INNER_D / 2, S.INNER_TOP - S.FLAT_LEN, S.INNER_D - S.INNER_FLAT, S.FLAT_LEN, fc="white")
    draw(ax, outer, 0, "k", dz=S.PLATE_Z1 + S.OUTER_KNOB["z0"])
    draw(ax, inner, 0, "k", dz=S.PLATE_Z1 + S.INNER_KNOB["z0"])
    ax.set_title("ALT/HDG dual knob on PEC11D-4120F-S0015")

    # ---- RANGE ----
    ax = axes[1]
    cx, cy = PS.P(*B.RANGE)
    draw(ax, plate, cy, "#1f5fa0", dx=-cx, dz=S.PLATE_Z0)
    part(ax, -12, -S.PCB_T, 24, S.PCB_T, fc="#c8d8c0")
    part(ax, -S.RKJXT_FOOT / 2, 0, S.RKJXT_FOOT, S.RKJXT_FRAME_GAP)   # foot and base frame (Alps' STEP)
    part(ax, -S.RKJXT_FRAME / 2, S.RKJXT_FRAME_GAP, S.RKJXT_FRAME, 2.55 - S.RKJXT_FRAME_GAP)
    part(ax, -S.RKJXT_FLATS / 2, 0, S.RKJXT_FLATS, S.RKJXT_BODY)  # octagon above z 4: 15.73 across flats
    part(ax, -S.RKJXT_HUB[0] / 2, S.RKJXT_BODY, S.RKJXT_HUB[0], S.RKJXT_HUB_TOP - S.RKJXT_BODY)   # hub, no chamfer
    part(ax, -S.LEVER_D / 2, S.LEVER_Z0, S.LEVER_D, S.LEVER_Z1 - S.LEVER_Z0)
    draw(ax, range_knob, 0, "k", dz=S.PLATE_Z1 + S.RANGE_KNOB["z0"])
    ax.set_title(f"RANGE knob on RKJXT1F42001 (tilt {S.RKJXT_TILT:.0f} deg not drawn)")

    # ---- SHIFT light pipe (section along board y, through the key above it) ----
    ax = axes[2]
    (lx, ly), _, _ = B.LEDS["SHIFT"]
    px, py = PS.P(lx, ly)
    # plate section in the YZ plane: rotate the problem by sectioning at x = px with a plane normal to X
    t = gp_Trsf(); t.SetRotation(gp_Ax1(gp_Pnt(px, py, 0), gp_Dir(0, 0, 1)), -math.pi / 2)
    rot = BRepBuilderAPI_Transform(plate, t, True).Shape()        # board +y (towards the user) now points to -x
    draw(ax, rot, py, "#1f5fa0", dx=-px, dz=S.PLATE_Z0)
    cw = B.LED_CUTOUT[1]                                        # the cutout across the pads (along board y)
    part(ax, -6, -S.PCB_T, 6 - cw / 2, S.PCB_T, fc="#c8d8c0")
    part(ax, cw / 2, -S.PCB_T, 6 - cw / 2, S.PCB_T, fc="#c8d8c0")
    ll = S.LED_LENS
    part(ax, -0.8, -S.PCB_T - 0.28, 1.6, 0.28)                  # reverse-mount LED: substrate under the board,
    part(ax, -ll["w"] / 2, -S.PCB_T, ll["w"], ll["h"], fc="#f3d58a")   # its lens up in the cutout
    key_dy = ly - B.ROWS[3]                                     # key centre is this far towards the back
    part(ax, key_dy - S.CAP["h"] / 2, S.CAP["base"], S.CAP["h"], S.CAP["height"], fc="#555", ec="#222")   # key cap
    tp = gp_Trsf(); tp.SetRotation(gp_Ax1(gp_Pnt(0, 0, 0), gp_Dir(0, 0, 1)), -math.pi / 2)
    draw(ax, BRepBuilderAPI_Transform(K.light_pipe(), tp, True).Shape(), 0, "k", dx=0, dz=S.PIPE["z0"])   # on the board
    ax.set_title("SHIFT light pipe\n(front of the panel on the left)")

    for ax, xl in zip(axes, ((-14, 14), (-11, 11), (-6, 9)), strict=True):   # z from under the LED
        ax.set_aspect("equal"); ax.grid(alpha=0.3); ax.set_xlim(*xl); ax.set_ylim(-3, 31 if ax is axes[0] else 22)
        ax.axhline(S.PLATE_Z1, color="#1f5fa0", lw=0.3, ls=":")
    fig.tight_layout()
    fig.savefig(HERE / "fit-check.png", dpi=110)
    print("fit-check.png written")


def rrect_sd(x, y, w, h, r):
    """signed distance of points to a rounded rectangle centred at 0 (negative inside, positive outside)."""
    qx, qy = np.abs(x) - (w / 2 - r), np.abs(y) - (h / 2 - r)
    return np.hypot(np.maximum(qx, 0), np.maximum(qy, 0)) + np.minimum(np.maximum(qx, qy), 0) - r


def cap_shift_room(grow=0.0, turn=0.0, r=None):
    """how far a key cap, turned by turn (deg) on its plunger, can shift in its key hole (grown by grow on width
    and height, its corner radius r if given) before it touches: (least, most) over all directions (0 when it does
    not fit at all)."""
    c, (hw, hh, hr) = S.CAP, S.KEY_HOLE
    hole = (hw + grow, hh + grow, (hr if r is None else r) + grow / 2)
    t = np.linspace(0, 2 * np.pi, 720, endpoint=False)
    ox = (c["w"] / 2 - c["r"]) * np.sign(np.cos(t)) + c["r"] * np.cos(t)     # cap outline, corners dense
    oy = (c["h"] / 2 - c["r"]) * np.sign(np.sin(t)) + c["r"] * np.sin(t)
    ca, sa = math.cos(math.radians(turn)), math.sin(math.radians(turn))
    ox, oy = ox * ca - oy * sa, ox * sa + oy * ca
    rooms = []
    for a in np.linspace(0, 2 * np.pi, 144, endpoint=False):
        lo, hi = 0.0, 2.0
        for _ in range(30):
            d = (lo + hi) / 2
            inside = rrect_sd(ox + d * np.cos(a), oy + d * np.sin(a), *hole).max() <= 0
            lo, hi = (d, hi) if inside else (lo, d)
        rooms.append(lo)
    return min(rooms), max(rooms)


# ---- body: no slot of void and no wall of PA12 under 0.8 mm (powder traps, loose bosses, porous slivers) ----
def stl_triangles(path):
    with open(path, "rb") as f:
        data = f.read()
    n = int.from_bytes(data[80:84], "little")
    dt = np.dtype([("n", "<f4", 3), ("v", "<f4", (3, 3)), ("a", "<u2")])
    return np.frombuffer(data[84:84 + 50 * n], dtype=dt)["v"].astype(float)


def body_triangles():
    """the body mesh in board frame, from the STL make_mech.py wrote (build.sh runs it first)."""
    tri = stl_triangles(HERE / "avionics-panel-rev1-body.stl")
    tri[:, :, 1] *= -1                                           # output frame (Y = -board y) back to board y
    return tri


def mesh_triangles(shape, deflection=0.02):
    """triangles (n, 3, 3) of an OpenCascade solid, meshed here."""
    return np.concatenate([nodes[idx] for _, nodes, idx in face_meshes(shape, deflection, 0.15)])


def raster_section(tri, axis, value, res, grid=False):
    """solid mask of a closed mesh cut by the plane coordinate[axis] = value (even-odd fill on a res grid); with
    grid, also the plane coordinates (u, v) of every pixel centre."""
    u_ax, v_ax = [a for a in range(3) if a != axis]
    d = tri[:, :, axis] - value
    d[np.abs(d) < 1e-7] = 1e-7                                   # no vertex exactly on the plane
    pts, hit = [], []
    for a, b in ((0, 1), (1, 2), (2, 0)):
        m = d[:, a] * d[:, b] < 0
        t = np.where(m, d[:, a] / np.where(m, d[:, a] - d[:, b], 1), 0)
        pts.append(tri[:, a] + t[:, None] * (tri[:, b] - tri[:, a]))
        hit.append(m)
    pts, hit = np.stack(pts, 1), np.stack(hit, 1)
    sel = hit.sum(1) == 2
    order = np.argsort(~hit[sel], axis=1, kind="stable")[:, :2]
    seg = np.take_along_axis(pts[sel], order[:, :, None], 1)     # (n, 2, 3)
    u, v = seg[:, :, u_ax], seg[:, :, v_ax]
    u0, v0 = u.min() - 1.5, v.min() - 1.5
    nu, nv = int((u.max() + 1.5 - u0) / res) + 1, int((v.max() + 1.5 - v0) / res) + 1
    j0 = np.ceil((v.min(1) - v0) / res - 0.5).astype(int)
    j1 = np.ceil((v.max(1) - v0) / res - 0.5).astype(int)
    cnt = np.maximum(j1 - j0, 0)
    idx = np.repeat(np.arange(len(seg)), cnt)
    j = np.repeat(j0, cnt) + (np.arange(cnt.sum()) - np.repeat(np.cumsum(cnt) - cnt, cnt))
    f = (v0 + (j + 0.5) * res - v[idx, 0]) / (v[idx, 1] - v[idx, 0])
    uc = u[idx, 0] + f * (u[idx, 1] - u[idx, 0])
    c = np.clip(np.ceil((uc - u0) / res - 0.5).astype(int), 0, nu)
    tog = np.zeros((nv, nu + 1), np.int32)
    np.add.at(tog, (j, c), 1)
    mask = (np.cumsum(tog, 1)[:, :nu] % 2) == 1
    if grid:
        return mask, np.meshgrid(u0 + (np.arange(nu) + 0.5) * res, v0 + (np.arange(nv) + 0.5) * res)
    return mask


def _shifted(mask, offs, erode, outside=False):
    """erosion (AND) or dilation (OR) of the mask over every offset; pixels off the grid count as outside."""
    p = max(max(abs(dy), abs(dx)) for dy, dx in offs)
    pad = np.pad(mask, p, constant_values=outside)
    out = np.full(mask.shape, erode)
    h, w = mask.shape
    for dy, dx in offs:
        s = pad[p + dy:p + dy + h, p + dx:p + dx + w]
        out = (out & s) if erode else (out | s)
    return out


def thin_depth(mask, res, outside, gap=0.8, ignore=None):
    """deepest point of any part of mask narrower than gap: the pixels a disk of dia gap cannot reach, measured
    along the mask to the nearest reachable pixel (pixels in ignore do not count). A square corner gives about
    0.2."""
    r = int(round(gap / 2 / res))
    disk = [(dy, dx) for dy in range(-r, r + 1) for dx in range(-r, r + 1) if dy * dy + dx * dx <= r * r]
    opened = _shifted(_shifted(mask, disk, True, outside), disk, False) & mask
    thin = mask & ~opened
    if ignore is not None:
        thin &= ~ignore
    cross = [(dy, dx) for dy in (-1, 0, 1) for dx in (-1, 0, 1)]
    cover, steps = opened, 0
    while (thin & ~cover).any() and steps < 30:
        cover = _shifted(cover, cross, False) & mask
        steps += 1
    return steps * res


def body_thin(tri, res=0.1):
    """deepest thin void, deepest thin wall (0.8) and deepest wall under JLC3DP's 2.0 mm for large MJF parts
    (1.9: a 2.0 wall is 20 pixels, which a 21 pixel disk does not fit) over sections through the body mesh tri
    (board frame), with where."""
    ux = B.USB_X
    planes = [(2, z) for z in (-2.5, -4.0, -6.0, -6.5, -7.0, -7.7, -8.3, -9.0, -10.5, -12.0, -13.5)]
    uw = (MM.USB_OPEN["w"] + MM.USB_KEEP[0]) / 4        # in the walls beside the USB-C opening and its slot
    planes += [(0, x) for x in (3.5, 9.0, 15.5, 22.5, 54.0, 85.0, 112.0, ux - uw, ux, ux + uw, B.BOOT[0], 150.0,
                                156.5)]
    planes += [(1, y) for y in (-1.5, 0.5, 2.0, 3.5, 6.7, 20.0, 40.0, 47.8, 55.5, 57.0)]
    cx, cy = B.MID_MOUNT                                # through the middle column and beside its axis
    planes += [(0, cx), (0, cx + 1.5), (0, cx + 3.0), (1, cy), (1, cy + 3.0), (1, cy + 5.0)]
    void, wall, wall2 = (0.0, "none"), (0.0, "none"), (0.0, "none")
    keep_r = MM.BOSS_R_LOW + 0.5        # the screw bosses: fastener features, checked against 1.5 by their own rows
    for axis, value in planes:
        solid, (gu, _) = raster_section(tri, axis, value + 1e-3, res, grid=True)
        where = f"{'xyz'[axis]} {value:g}"
        dv = thin_depth(~solid, res, True)
        # walls only in x and y sections: a z section cuts the 6 deg bottom faces at a slant, so their edges
        # look like slivers there that are not thin in 3D
        dw = thin_depth(solid, res, False) if axis != 2 else 0.0
        boss = np.zeros(solid.shape, bool)
        for mx, my in B.MOUNTS:
            boss |= np.hypot(*((mx - value, my - gu) if axis == 0 else (mx - gu, my - value))) < keep_r
        dw2 = thin_depth(solid, res, False, 1.9, boss) if axis != 2 else 0.0
        void = (dv, where) if dv > void[0] else void
        wall = (dw, where) if dw > wall[0] else wall
        wall2 = (dw2, where) if dw2 > wall2[0] else wall2
    return void, wall, wall2


def crossings(shape, x):
    """heights where the vertical line at (x, 0) enters or leaves the solid (its XZ section), sorted."""
    zs = []
    for px, pz in section(shape, 0.0):
        for (x0, z0), (x1, z1) in zip(zip(px, pz, strict=True), zip(px[1:], pz[1:], strict=True), strict=False):
            if (x0 - x) * (x1 - x) < 0:
                zs.append(z0 + (z1 - z0) * (x - x0) / (x1 - x0))
    zs.sort()
    if not zs or len(zs) % 2:
        raise ValueError(f"no clean section at x {x}")
    return zs


def d_bore_len(shape, d, flat):
    """length of the D flat in a knob's D bore (flat towards +x, bore end on the axis), measured on the solid: from
    the bore end on the axis down to where the resin behind the flat ends, on a line halfway between the flat and
    the bore wall."""
    end = crossings(shape, 0.0)[0]                       # the axis enters the resin at the bore end
    x = flat / 2                                         # halfway from the flat (flat - d / 2) to the wall (d / 2)
    starts = [z for z in crossings(shape, x)[0::2] if z < end]
    return end - max(starts)


@functools.cache
def set_caps(name):
    """triangles (n, 3, 3) of each cap in the set's generated OBJ (caps-<set>.zip, as ordered), each moved to the
    origin: the caps sit on the print grid stack.CAP_LAYOUT, in the order of stack.KEY_LEGENDS."""
    base = f"avionics-panel-rev1-caps-{name}"
    with zipfile.ZipFile(HERE / f"{base}.zip") as z:
        lines = z.read(f"{base}.obj").decode().splitlines()
    V = np.array([[float(t) for t in ln.split()[1:4]] for ln in lines if ln.startswith("v ")])
    F = np.array([[int(t.split("/")[0]) - 1 for t in ln.split()[1:4]] for ln in lines if ln.startswith("f ")])
    tri, pitch, n = V[F], S.CAP_LAYOUT["pitch"], S.CAP_LAYOUT["per_row"]
    col, row = np.round(tri.mean(1)[:, :2] / (pitch, -pitch)).astype(int).T
    k = col + n * row
    return [tri[k == i] - (pitch * (i % n), -pitch * (i // n), 0.0) for i in range(k.max() + 1)]


def first_cap(name):
    """triangles (n, 3, 3) of the first cap of set name (set_caps)."""
    return set_caps(name)[0]


def cap_measures(name):
    """measured on the first cap of set name (first_cap): its size over all (w, h, height) and how deep it is at
    each of the CAP_MARK positions (0 where it has no dimple), by rays up from under the cap."""
    tri = first_cap(name)
    v = tri.reshape(-1, 3)
    up = np.array([0.0, 0.0, 1.0])
    return v.max(0) - v.min(0), [ray_hit(tri, np.array([x, y, -1.0]), up) - 1.0 for x, y in S.CAP_MARK["pos"]]


def cap_build_rows():
    """the generated caps (first_cap of each set) against stack.CAP and stack.CAP_MARK: the outline, the height and
    the set's dimples, the first 1 to 4 of CAP_MARK's positions by the set's place in CAP_SETS."""
    c, mk = S.CAP, S.CAP_MARK
    sizes, off = [], 0.0
    for k, n in enumerate(S.CAP_SETS):
        size, depths = cap_measures(n)
        sizes.append(size)
        off = max(off, *np.abs(size - (c["w"], c["h"], c["height"])),
                  *(abs(d - (mk["depth"] if i <= k else 0.0)) for i, d in enumerate(depths)))
    lo, hi = np.min(sizes, axis=0), np.max(sizes, axis=0)
    return [(f"caps as built: {lo[0]:.2f} to {hi[0]:.2f} x {lo[1]:.2f} to {hi[1]:.2f}, {lo[2]:.2f} to {hi[2]:.2f} "
             f"high, set dimples (1 to {len(S.CAP_SETS)}) off by up to {off:.3f} (the first cap of each set, "
             f"measured) are the stack's ({c['w']} x {c['h']}, {c['height']}, {mk['depth']} deep)", 0.01 - off)]


def cap_bar_rows():
    """the tactile bars on the generated caps (set_caps, every cap of each set) against stack.CAP_BAR_EDGE and
    CAP_BAR, set by set: which edge each one stands on (the mesh over the top face; model -y is the front), how far
    proud, and its top face (the vertices over the cap top) against the stack's bar (w, d, inset)."""
    labels = [lab for row in S.KEY_LEGENDS for lab, _ in row]
    c, b = S.CAP, S.CAP_BAR
    top, yb = c["height"], (c["h"] - 2 * c["cham"]) / 2 - b["inset"]    # yb: the bar's middle off the cap's middle
    got, proud, off = set(), [], 0.0
    for n in S.CAP_SETS:
        for lab, tri in zip(labels, set_caps(n), strict=True):
            v = tri.reshape(-1, 3)
            bar = v[v[:, 2] > top + 0.01, :2]
            if len(bar):
                e = 1 if bar[:, 1].max() < 0 else -1 if bar[:, 1].min() > 0 else 0
                got.add((n, lab, e))
                proud.append(v[:, 2].max() - top)
                y = -e * yb
                off = max(off, *np.abs(np.r_[bar.min(0), bar.max(0)]
                                       - (-b["w"] / 2, y - b["d"] / 2, b["w"] / 2, y + b["d"] / 2)))
    want = {(n, lab, e) for n in S.CAP_SETS for lab, e in S.CAP_BAR_EDGE.items() if e}

    def say(bars):
        return ", ".join(f"{lab} {('back', 'middle', 'front')[e + 1]}" for lab, e in
                         sorted(bars, key=lambda t: labels.index(t[0]))) or "none"

    def by_set(bars):
        return ", ".join(f"set {n} {say({(lab, e)})}" for n, lab, e in sorted(bars)) or "none"
    found = (f"{say({(lab, e) for _, lab, e in got})} in each set, none on the other caps" if got == want
             else f"missing {by_set(want - got)}, extra {by_set(got - want)}")
    p = b["proud"]
    return [(f"cap tactile bars as built: {found}, {min(proud, default=0):.2f} to "
             f"{max(proud, default=0):.2f} proud, their tops {off:.3f} off (every cap of each set, measured) are the "
             f"stack's ({say((lab, e) for lab, e in S.CAP_BAR_EDGE.items() if e)}; {b['w']} x {b['d']}, inset "
             f"{b['inset']}, {p} proud)",
             0.01 - max([off, *(abs(v - p) for v in proud)]) if got == want else -1.0)]


def read_step(name):
    """the solid of a STEP file a generator wrote next to this script (build.sh runs the generators first)."""
    r = STEPControl_Reader()
    if r.ReadFile(str(HERE / f"{name}.step")) != IFSelect_RetDone:
        raise SystemExit(f"check_fit.py: no {name}.step, run its generator first")
    r.TransferRoots()
    return r.OneShape()


def knob_solids():
    """every knob STEP make_knobs.py wrote, {(FLUTES name, the bore's number in stack.FIT_VARIANTS): solid}."""
    kinds = {name: kind for name, kind, _solid, _args in K.KNOBS}
    out = {}
    for name, _solid, args in K.parts():
        m = re.fullmatch(r"avionics-panel-rev1-knob-(.+)-(\d+)", name)
        if m:
            out[kinds[m.group(1)], args[-1]] = read_step(name)
    return out


def knob_mark_floor(kind):
    """the height, above a knob's bottom plane, of the surface its dimples are cut into, on their circle: the
    outer rings' bottom face, the ceiling of the inner knob's recess, the RANGE knob's dished underside."""
    return {"inner": K.inner_recess_top(), "range": K.range_dish(S.KNOB_MARK["r"]["range"])}.get(kind, 0.0)


def knob_measures(tri, kind):
    """measured on a knob's mesh (bottom at z 0): the bore's diameter (the largest reading over TURN, from the
    axis), the outer knob's key width (None on the others), the flute depth at each flute (crest to trough,
    rays in from outside), half a millimetre under the top chamfer, its dimples (mark_centres: their depths, the
    smallest and the largest diameter, how far a centre is off its place at most, and how deep the knob is cut at
    the place that stays empty), the diameter of the round relief bore under the D bore of the inner and the
    RANGE knob (the largest reading over TURN at three heights: just over its lower end, half way up and just
    under the D bore; the smallest of the three; None on the outer knobs), the inner knob's recess across (half
    its height up; None on the others), the seat (the outer knobs: the key's face from the axis `key_r`, the key's
    bottom `key_z`, the counterbore's ceiling `cb_top` and diameter `cb_d`; the others: the D bore across its flat
    `flat` and its end `end`, up the axis), and the size: the largest crest radius zf over the bottom, the top, zf
    and the knob's height as drawn. A dict."""
    f, mk = S.FLUTES[kind], S.KNOB_MARK
    zr = recess = None
    if kind == "inner":
        ik = S.INNER_KNOB
        h, top = ik["z1"] - ik["z0"], S.INNER_TOP - S.PLATE_Z1 - ik["z0"]          # the bore ends on the shaft tip
        zb = top - K.inner_d_len() / 2
        zr = (K.inner_recess_top(), top - K.inner_d_len())
        recess = max(across(tri, (0.0, 0.0, K.inner_recess_top() / 2), d)[0] for d in TURN)
    elif kind == "range":
        rk = S.RANGE_KNOB
        h, lever0, lever1 = rk["z1"] - rk["z0"], S.LEVER_Z0 - S.PLATE_Z1 - rk["z0"], S.LEVER_Z1 - S.PLATE_Z1 - rk["z0"]
        zb = (max(lever0, S.RANGE_RELIEF[1]) + lever1) / 2
        zr = (0.0, max(lever0, S.RANGE_RELIEF[1]))
    else:
        h = S.OUTER_KNOB["z1"] - S.OUTER_KNOB["z0"]
        zb = (K.outer_key_z0() + h) / 2                                         # beside the key
    bore = max(across(tri, (0.0, 0.0, zb), d)[0] for d in TURN)
    relief = None if zr is None else min(max(across(tri, (0.0, 0.0, z), d)[0] for d in TURN)
                                         for z in (zr[0] + RELIEF_END, (zr[0] + zr[1]) / 2, zr[1] - RELIEF_END))
    ex, up = np.array([1.0, 0.0, 0.0]), np.array([0.0, 0.0, 1.0])
    key = seat = None
    if kind.startswith("outer"):
        key = across(tri, ((S.KEY_R + bore / 2) / 2, 0.0, zb), np.array([0.0, 1.0, 0.0]))[0]   # inside the key
        r_cb = (bore / 2 + K.outer_counterbore_d() / 2) / 2         # between the bore and the counterbore's wall
        cb_top = ray_hit(tri, np.array([-r_cb, 0.0, -1.0]), up) - 1.0
        # the key's face from the axis, its bottom from below (up through the counterbore and the bore), and the
        # counterbore round the bushing: its ceiling and its diameter half way up
        seat = dict(key_r=ray_hit(tri, np.array([0.0, 0.0, zb]), ex),
                    key_z=ray_hit(tri, np.array([(S.KEY_R + bore / 2) / 2, 0.0, -1.0]), up) - 1.0,
                    cb_top=cb_top, cb_d=max(across(tri, (0.0, 0.0, cb_top / 2), d)[0] for d in TURN))
    else:
        # the D bore across its flat (the flat towards +x) and its end, up the axis from below
        seat = dict(flat=across(tri, (0.0, 0.0, zb), ex)[0], end=ray_hit(tri, np.array([0.0, 0.0, -1.0]), up) - 1.0)
    zf, far = h - f["cham"] - 0.5, 20.0

    def radius(a):
        d = np.array([math.cos(a), math.sin(a), 0.0])
        return far - ray_hit(tri, np.array([far * d[0], far * d[1], zf]), -d)
    a, e = 2 * math.pi / f["n"], 1e-4                       # e: off the crest and trough edges of the mesh
    crest = [radius(k * a + e) for k in range(f["n"])]
    flutes = [c - radius((k + 0.5) * a + e) for k, c in enumerate(crest)]
    built = mark_centres(tri, kind)
    wide = [d for _deep, _c, d in built if d is not None]
    shift = max((math.dist(c, K.mark_xy(kind, k)) for k, (_deep, c, _d) in enumerate(built) if c is not None),
                default=0.0)
    empty = (ray_hit(tri, np.array([*K.place_xy(kind, mk["group"]), -1.0]), np.array([0.0, 0.0, 1.0])) - 1.0
             - knob_mark_floor(kind))
    return dict(bore=bore, key=key, flutes=flutes, depths=[deep for deep, _c, _d in built],
                wide=(min(wide, default=0.0), max(wide, default=0.0)), shift=shift, empty=empty, relief=relief,
                recess=recess, seat=seat, size=(max(crest), float(tri[:, :, 2].max()), zf, h))


RELIEF_END = 0.02                 # the relief bore is read this far inside its two ends
MARK_OFF = 0.02                   # a dimple's centre as built, off its place at most


def mark_centres(tri, kind):
    """a knob's dimples as built, at each place one of them can be (make_knobs.mark_xy): (how deep the knob is cut
    there, by a ray up from below, over knob_mark_floor; the dimple's centre, from the midpoints of two crossed
    chords half its depth up; its diameter, the second chord, which runs through that centre). Centre and diameter
    are None where the place is not cut half a dimple deep."""
    mk, floor = S.KNOB_MARK, knob_mark_floor(kind)
    ex, ey, up = np.array([1.0, 0.0, 0.0]), np.array([0.0, 1.0, 0.0]), np.array([0.0, 0.0, 1.0])
    out = []
    for k in range(len(S.FIT_VARIANTS)):
        x, y = K.mark_xy(kind, k)
        deep = ray_hit(tri, np.array([x, y, -1.0]), up) - 1.0 - floor
        if deep <= mk["depth"] / 2:
            out.append((deep, None, None))
            continue
        z = floor + mk["depth"] / 2
        xc = x + across(tri, (x, y, z), ex)[1]
        d, oy = across(tri, (xc, y, z), ey)
        out.append((deep, (xc, y + oy), d))
    return out


def off_size(e):
    """a print error on a hole's diameter in words: 0.45 small, 0.05 large."""
    return f"{abs(e):.2f} {'small' if e < 0 else 'large'}"


def knob_rows(meshes):
    """every knob as make_knobs.py writes it (meshes: {(FLUTES name, the bore's number): mesh}) against the stack:
    the bore (the shaft, FIT and the bore's offset), the outer knobs' key width, the flute depth, the fluted
    body's crests and height, and the dimples that number the bore: as many as its number, in their places
    (within MARK_OFF) and none in the place that stays empty, stack.KNOB_MARK across and deep (the RANGE knob's
    are that deep at their shallow side, so deeper at the middle). The inner knob: its recess across. How each
    sits on its shaft: seat_row()."""
    rows, mk = [], S.KNOB_MARK
    for kind, shaft in {"outer": S.OUTER_D, "outer_fms": S.OUTER_D, "inner": S.INNER_D, "range": S.LEVER_D}.items():
        tags = sorted(t for k, t in meshes if k == kind)
        if tags != sorted(S.FIT_VARIANTS):
            rows.append((f"{kind} knob: make_knobs.py writes the bores {tags}", -1.0))
            continue
        got = {t: knob_measures(meshes[kind, t], kind) for t in tags}
        want = {t: shaft + S.FIT + S.FIT_VARIANTS[t] for t in tags}
        f = S.FLUTES[kind]
        flutes = [d for m in got.values() for d in m["flutes"]]
        keys = [m["key"] for m in got.values() if m["key"] is not None]
        deep = (K.range_mark_top() - knob_mark_floor(kind)) if kind == "range" else mk["depth"]
        marks = max(*(abs(d - (deep if k < t else 0.0)) for t in tags for k, d in enumerate(got[t]["depths"])),
                    *(abs(got[t]["empty"]) for t in tags))
        wide = [w for t in tags for w in got[t]["wide"]]
        recess = [got[t]["recess"] for t in tags if got[t]["recess"] is not None]
        # the fluted body: its crest radius zf over its bottom (tapered) and its height
        radius, (_c, _top, zf, h) = KNOB_R[kind], got[tags[0]]["size"]
        crest, height = radius * (1 - f["taper"] * zf / h), h
        size = max(max(abs(got[t]["size"][0] - crest), abs(got[t]["size"][1] - height)) for t in tags)
        off = max(*(abs(got[t]["bore"] - want[t]) for t in tags), *(abs(d - f["depth"]) for d in flutes),
                  *(abs(k - S.KEY_W) for k in keys), marks, *(abs(w - mk["d"]) for w in wide),
                  *(abs(r - S.INNER_KNOB["recess_d"]) for r in recess), size)
        shift = max(got[t]["shift"] for t in tags)
        bores = ", ".join(f"Ø{got[t]['bore']:.2f}" for t in tags)
        rows.append((f"{kind} knob as built (bores {tags[0]} to {tags[-1]}): {bores}, flutes {min(flutes):.2f} to "
                     f"{max(flutes):.2f} deep, crests and height {size:.3f} off" + (
                         f", key {min(keys):.2f} to {max(keys):.2f} wide" if keys else "")
                     + (f", recess Ø{min(recess):.2f} to Ø{max(recess):.2f}" if recess else "")
                     + f", {tags[0]} to {tags[-1]} dimples Ø{min(wide):.2f} to Ø{max(wide):.2f}, off in depth by "
                     f"{marks:.3f}, the place after the third empty (measured on the solids) are the stack's ("
                     f"{', '.join(f'Ø{want[t]:g}' for t in tags)}, {f['depth']}, Ø{2 * radius:g} x {h:g}"
                     + (f", {S.KEY_W}" if keys else "") + (f", Ø{S.INNER_KNOB['recess_d']}" if recess else "")
                     + f", Ø{mk['d']} x {deep:.2f})", 0.01 - off))
        rows.append((f"{kind} knob's dimples as built (bores {tags[0]} to {tags[-1]}): their centres, from two "
                     f"crossed chords on the solids, {shift:.3f} off their places at most, within {MARK_OFF}",
                     MARK_OFF - shift))
        rows.append(seat_row(kind, tags, got))
        # A bore v over the shaft's largest size, printed e off its size, sits on a shaft t under that size with an
        # interference of -(v + e + t), and grips within KNOB_GRIP. The windows of neighbouring bores overlap, so
        # on every shaft (t from 0 to SHAFT_TOL) one of the bores grips for every e from lo to hi.
        grip_lo, grip_hi = S.KNOB_GRIP
        over = sorted(got[t]["bore"] - shaft for t in tags)                 # as built
        lap = (grip_hi - grip_lo) - max(b - a for a, b in itertools.pairwise(over))
        lo, hi = -(grip_hi + over[-1]), -(S.SHAFT_TOL + grip_lo + over[0])
        rows.append((f"{kind} knob (stack.FIT {S.FIT:+.1f}): one of its bores (as built) grips its Ø{shaft} shaft "
                     f"(+0/-{S.SHAFT_TOL}) with {grip_lo} to {grip_hi} of interference when they print {off_size(lo)} "
                     f"to {off_size(hi)}: the grip windows of neighbouring bores overlap", lap,
                     ("Knobs", "Overlap of the grip windows of two neighbouring bores (outer ring, FMS ring, inner "
                               f"knob, RANGE knob), with `stack.FIT` at {S.FIT:+.1f}")))
    return rows


KNOB_R = {"outer": S.OUTER_KNOB["d"] / 2, "outer_fms": S.OUTER_KNOB["d"] / 2, "inner": S.INNER_KNOB["d"] / 2,
          "range": S.RANGE_KNOB["d"] / 2}         # the fluted body's radius at its bottom


def seat_row(kind, tags, got):
    """how a knob sits on its shaft, as built (got: knob_measures of each bore in tags) against the stack. The
    outer rings: the key's face from the axis and its bottom, which rests on the slot floor, and the counterbore
    round the bushing, its ceiling and diameter. The inner and the RANGE knob: the D bore across its flat, its end,
    which rests on the shaft or lever tip, and the round relief bore under it (make_knobs.relief_d's and at least
    the D bore over it)."""
    span = f"bores {tags[0]} to {tags[-1]}"
    if kind.startswith("outer"):
        ok = S.OUTER_KNOB
        want = dict(key_r=S.KEY_R, key_z=S.OUTER_TOP - S.SLOT_LEN - S.PLATE_Z1 - ok["z0"],
                    cb_top=S.SLEEVE_TOP - S.PLATE_Z1 - ok["z0"] + S.SLEEVE_CLEAR["above"],
                    cb_d=S.SLEEVE_D + 2 * S.SLEEVE_CLEAR["radial"])
        seen = {k: [got[t]["seat"][k] for t in tags] for k in want}
        off = max(abs(v - want[k]) for k in want for v in seen[k])
        return (f"{kind} knob's seat as built ({span}): key face r {min(seen['key_r']):.2f}, key bottom "
                f"{min(seen['key_z']):.2f} to {max(seen['key_z']):.2f} over the ring's bottom, counterbore "
                f"Ø{min(seen['cb_d']):.2f} up to {max(seen['cb_top']):.2f} (measured on the solids) are the stack's "
                f"(r {want['key_r']}, {want['key_z']:.2f}, Ø{want['cb_d']:g} up to {want['cb_top']:.2f})", 0.01 - off)
    shaft, flat, top, z0 = ((S.INNER_D, S.INNER_FLAT, S.INNER_TOP, S.INNER_KNOB["z0"]) if kind == "inner"
                            else (S.LEVER_D, S.LEVER_FLAT, S.LEVER_Z1, S.RANGE_KNOB["z0"]))
    flats = {t: flat + S.FIT + S.FIT_VARIANTS[t] for t in tags}
    end = top - S.PLATE_Z1 - z0                                     # the bore's end on the tip
    relief = {t: got[t]["relief"] for t in tags}
    off = max(max(abs(got[t]["seat"]["flat"] - flats[t]), abs(got[t]["seat"]["end"] - end),
                  got[t]["bore"] - relief[t], abs(relief[t] - K.relief_d(kind, t))) for t in tags)
    across_ = ", ".join(f"{got[t]['seat']['flat']:.2f}" for t in tags)
    return (f"{kind} knob's seat as built ({span}): D bore {across_} "
            f"across the flat, its end {min(got[t]['seat']['end'] for t in tags):.2f} over the knob's bottom, relief "
            f"bores {', '.join(f'Ø{relief[t]:.2f}' for t in tags)} (the narrowest of three heights; measured on the "
            f"solids) are the stack's ({', '.join(f'{v:g}' for v in flats.values())} on the Ø{shaft} shaft's "
            f"{flat}, {end:.2f}; each relief bore at least the D bore over it)", 0.01 - off)


BOTTOM_CHAM = 0.3                # occ_util.fluted: the chamfer on a knob's bottom edge (the RANGE knob has none)


def knob_outline(kind, radius, h, z):
    """a knob's fluted outline z over its bottom, in plan: the polygon occ_util.fluted_section draws (12 facets a
    flute, the crests at the flutes' angles from +x), tapered towards the top."""
    f = S.FLUTES[kind]
    r0, n = radius * (1 - f["taper"] * z / h), f["n"] * 12
    pts = []
    for i in range(n):
        t = 2 * math.pi * i / n
        r = r0 - f["depth"] * (0.5 - 0.5 * math.cos(f["n"] * t))
        pts.append((r * math.cos(t), r * math.sin(t)))
    return Polygon(pts)


def resin_wall(size):
    """JLC3DP's least wall of a resin part `size` across (stack.RESIN_WALL, in proportion between its entries)."""
    (s0, w0), (s1, w1) = S.RESIN_WALL
    return w0 + (w1 - w0) * (min(max(size, s0), s1) - s0) / (s1 - s0)


def knob_mark_walls(meshes):
    """the resin round the knobs' dimples as built, the least of each knob, in plan: from the centres and the
    diameter measured on the knob with the most dimples (mark_centres; meshes as for knob_rows) to the next
    dimple, to the widest hole inside their circle (the outer rings' counterbore, the relief bore of the inner and
    the RANGE knob under the largest D bore that FIT, at FIT_STEP, and FIT_VARIANTS allow) and to the knob's
    outside (its fluted outline at the dimples' top, and on the outer rings the bottom chamfer's edge, where the
    dimples open; the inner knob: the wall of its recess is no wall of the dimple, which lies above it). (knob,
    wall as drawn, wall at the worst print: the holes on either side stack.RESIN_TOL["hole"] large, the outside
    RESIN_TOL["size"] small, JLC3DP's least wall for a part of the knob's size, how far from the axis the dimples
    reach)."""
    mk, hole, size = S.KNOB_MARK, S.RESIN_TOL["hole"], S.RESIN_TOL["size"]
    ok, ik, rk = S.OUTER_KNOB, S.INNER_KNOB, S.RANGE_KNOB
    widest, most = S.FIT_STEP + max(S.FIT_VARIANTS.values()), max(S.FIT_VARIANTS)
    # the knob's radius and height, the widest hole inside the dimples' circle, the dimples' top, the radius of the
    # bottom face's edge where the dimples open in it, the knob's size
    ring = (ok["d"] / 2, ok["z1"] - ok["z0"], max(K.outer_counterbore_d(), S.OUTER_D + widest) / 2, mk["depth"],
            ok["d"] / 2 - BOTTOM_CHAM, ok["d"])
    knobs = {"outer": ring, "outer_fms": ring,
             "inner": (ik["d"] / 2, ik["z1"] - ik["z0"],
                       max(S.INNER_D + 2 * S.INNER_BORE_RELIEF, S.INNER_D + widest) / 2,
                       K.inner_recess_top() + mk["depth"], math.inf, ik["d"]),
             "range": (rk["d"] / 2, rk["z1"] - rk["z0"], max(S.RANGE_RELIEF[0], S.LEVER_D + widest) / 2,
                       K.range_mark_top(), math.inf, rk["skirt_d"])}
    out = []
    for kind, (radius, h, bore, top, edge, across_knob) in knobs.items():
        built = [(c, d) for _deep, c, d in mark_centres(meshes[kind, most], kind) if c is not None]
        if len(built) < 2:                                      # the as-built row fails
            out.append((kind, 0.0, 0.0, resin_wall(across_knob), math.inf))
            continue
        spots, d = [c for c, _d in built], max(d for _c, d in built)
        skin = knob_outline(kind, radius, h, top).exterior
        between = min(math.dist(a, b) for a, b in itertools.combinations(spots, 2)) - d
        inner = min(math.hypot(*c) for c in spots) - d / 2 - bore
        outer = min(min(skin.distance(Point(c)), edge - math.hypot(*c)) for c in spots) - d / 2
        out.append((kind, min(between, inner, outer), min(between - hole, inner - hole, outer - hole / 2 - size / 2),
                    resin_wall(across_knob), max(math.hypot(*c) for c in spots) + d / 2))
    return out


def down(v):
    """v to two decimals, rounded down: a wall is at least what its row prints."""
    return math.floor(v * 100 + 1e-6) / 100


def flute_bottom(f, r, z, h):
    """radius of the flute bottoms of a knob (flutes f, radius r, h high) z over its bottom (the taper narrows the
    knob upwards)."""
    return r * (1 - f["taper"] * z / h) - f["depth"]


def ray_hit(tri, o, d):
    """distance along the ray o + t d to the nearest triangle it crosses (Moller-Trumbore), or inf."""
    e1, e2 = tri[:, 1] - tri[:, 0], tri[:, 2] - tri[:, 0]
    pv = np.cross(d, e2)
    det = np.einsum("ij,ij->i", e1, pv)
    ok = np.abs(det) > 1e-12
    inv = np.where(ok, 1 / np.where(ok, det, 1), 0)
    tv = o - tri[:, 0]
    u = np.einsum("ij,ij->i", tv, pv) * inv
    qv = np.cross(tv, e1)
    v = (qv @ d) * inv
    t = np.einsum("ij,ij->i", e2, qv) * inv
    hit = ok & (u >= 0) & (v >= 0) & (u + v <= 1) & (t > 1e-9)
    return t[hit].min() if hit.any() else math.inf


def ray_hits(tri, origins, d):
    """ray_hit for each origin along the same direction d."""
    return np.array([ray_hit(tri, np.asarray(o, float), np.asarray(d, float)) for o in origins])


def across(tri, c, d):
    """the two walls seen from the point c along +-d: (distance between them, their middle off c)."""
    a, b = ray_hit(tri, np.array(c), -np.asarray(d)), ray_hit(tri, np.array(c), np.asarray(d))
    return a + b, (b - a) / 2


def fit_circle(pts):
    """centre (2,) and radius of the circle fitted to the points (n, 2) by least squares, NaN for fewer than
    three."""
    if len(pts) < 3:
        return np.full(2, math.nan), math.nan
    m = pts.mean(0)
    p = pts - m
    (a, b, c), *_ = np.linalg.lstsq(np.c_[2 * p, np.ones(len(p))], (p * p).sum(1), rcond=None)
    return m + (a, b), math.sqrt(c + a * a + b * b)


def corner_arcs(p):
    """the corners of a rounded rectangle given as points (n, 2) round it: the points off its bounding box's
    sides, in four groups by quarter. The DXF's corners are such points, each on its arc (geom.rounded_rect)."""
    lo, hi = p.min(0), p.max(0)
    off = ((p - lo > 1e-4) & (hi - p > 1e-4)).all(1)
    q = (p > (lo + hi) / 2) @ (1, 2)
    return [p[off & (q == k)] for k in range(4)]


def through_holes(tri):
    """how many holes go through a closed mesh: its genus, from V - E + F = 2 - 2 g with the faces' meshes joined
    at their shared edges."""
    _, idx = np.unique(np.round(tri.reshape(-1, 3), 6), axis=0, return_inverse=True)
    f = idx.reshape(-1, 3)
    edges = np.unique(np.sort(np.concatenate([f[:, [0, 1]], f[:, [1, 2]], f[:, [2, 0]]]), axis=1), axis=0)
    return (2 - (idx.max() + 1 - len(edges) + len(f))) // 2


def ring(cx, cy, z, r, n=72):
    """n points on a horizontal circle of radius r round (cx, cy) at height z, and their outward directions."""
    a = np.linspace(0, 2 * np.pi, n, endpoint=False)
    dirs = np.stack([np.cos(a), np.sin(a), np.zeros(n)], 1)
    return np.stack([cx + r * np.cos(a), cy + r * np.sin(a), np.full(n, z)], 1), dirs


def near(tri, x, y, r):
    """the triangles whose xy bounding box comes within r of (x, y): keeps the ray casts below fast."""
    lo, hi = tri[:, :, :2].min(1), tri[:, :, :2].max(1)
    return tri[(lo[:, 0] < x + r) & (hi[:, 0] > x - r) & (lo[:, 1] < y + r) & (hi[:, 1] > y - r)]


# A round wall is facets on a mesh, and a ray across it can only read its diameter small: a diameter measured on a
# mesh is the largest reading over these directions.
TURN = [np.array([math.cos(t), math.sin(t), 0.0]) for t in np.radians(np.arange(0.0, 180.0, 2.0))]


def body_measures(tri):
    """measured on the body mesh (board frame), as a dict. At the five screw bosses: the counterbore radius `cb`
    (least and most; at the middle column along the bar, where it has a wall), the seat's height `seat_z` (from
    below, up the counterbore beside the screw hole) and the PA12 between the seat and the PCB `seat_t`. At the four
    corner bosses the boss wall round the counterbore towards the cavity, in the PCB room, `wall`. The middle
    column's bar in plan `bar` (x0, y0, x1, y1) and its wall beyond the counterbore `bar_wall`. The wall tops
    `wall_top` (least and most, one on each wall), the USB-C slot in the back wall `slot` (its width at two heights,
    least and most, whether it is open at the wall top, and how far its middle is off the socket's axis), the post's
    top `post_top` and how far its axis is off its place `post_off`, and the flat pad round each foot `pad` (radius
    on the bottom plane before it steps into the hollow). The cavity over the board `cavity` (along, across), the
    floor's top `floor` (least and most), the plug opening's bottom `opening`, the screw holes `holes` (least and
    most diameter) and the BOOT hole `boot`."""
    z = (MM.Z_FLOOR_TOP + S.SEAT_Z) / 2                 # in the PCB room, below the counterbore seats
    up, down = np.array([0.0, 0.0, 1.0]), np.array([0.0, 0.0, -1.0])
    ex, ey = np.array([1.0, 0.0, 0.0]), np.array([0.0, 1.0, 0.0])
    r_seat = (MM.SCREW_CLEAR + MM.HEAD_R) / 2           # on the seat, between the screw hole and the counterbore
    cb, wall, seat_t, seat_z = [], [], [], []
    for mx, my in B.MOUNTS:
        tri_m = near(tri, mx, my, 15.0)
        if (mx, my) == B.MID_MOUNT:                     # along the bar only: across it the counterbore is open
            r_cb = min(ray_hit(tri_m, np.array([mx, my, z]), d) for d in (ey, -ey))
            x0, x1 = (mx + sx * ray_hit(tri_m, np.array([mx, my + r_cb + 0.5, z]), sx * ex) for sx in (-1.0, 1.0))
            y0, y1 = (my + sy * (r_cb + 0.5 + ray_hit(tri_m, np.array([mx, my + sy * (r_cb + 0.5), z]), sy * ey))
                      for sy in (-1.0, 1.0))
            bar, bar_wall = (x0, y0, x1, y1), min(y1 - my, my - y0) - r_cb
        else:
            pts, dirs = ring(mx, my, z, 0.0)
            r_cb = min(ray_hit(tri_m, q, d) for q, d in zip(pts, dirs, strict=True))
            pts, dirs = ring(mx, my, z, r_cb + 0.01)
            # towards the cavity only (within 60 deg of the board centre); towards the corner the boss runs into
            # the outer walls, which the counterbore-to-outer-wall row checks
            to_c = np.array([B.W / 2 - mx, B.H / 2 - my]) / math.hypot(B.W / 2 - mx, B.H / 2 - my)
            inward = dirs[:, :2] @ to_c > 0.5
            wall.append(min(ray_hit(tri_m, q, d) for q, d in zip(pts[inward], dirs[inward], strict=True)) + 0.01)
        cb.append(r_cb)
        pts, _ = ring(mx, my, -S.PCB_T - 0.01, r_seat, 24)
        seat_t.append(ray_hits(tri_m, pts, (0, 0, -1)).min() + 0.01)
        seat_z += [ray_hit(tri_m, np.array([mx, my + sy * r_seat, -30.0]), up) - 30.0 for sy in (-1.0, 1.0)]
    mid_w = MM.o - MM.WALL / 2                          # the middle of a wall, out from the board's edge
    tops = [20.0 - ray_hit(near(tri, x, y, 5.0), np.array([x, y, 20.0]), down)
            for x, y in ((B.W / 2, -mid_w), (B.W / 2, B.H + mid_w), (-mid_w, B.H / 2), (B.W + mid_w, B.H / 2))]
    tri_u = near(tri, B.USB_X, -mid_w, 15.0)
    wall_z = S.PLATE_Z0 - S.WALL_GAP
    sides = [[ray_hit(tri_u, np.array([B.USB_X, -mid_w, zz]), sx * ex) for sx in (-1.0, 1.0)]
             for zz in (2.0, wall_z - 0.3)]             # the slot's two sides from the socket's axis, at two heights
    widths = [a + b for a, b in sides]
    is_open = all(ray_hit(tri_u, np.array([B.USB_X + dx, -mid_w, 2.0]), up) == math.inf
                  for dx in (-min(widths) / 2 + 0.3, 0.0, min(widths) / 2 - 0.3))
    posts = [20.0 - ray_hit(near(tri, x, y, 5.0), np.array([x, y, 20.0]), down) for x, y in MM.SUPPORTS]
    # each post's axis off its place: its wall found from 5 mm out on both sides along x and y, under its top
    post_off = []
    for x, y in MM.SUPPORTS:
        tri_p, zp = near(tri, x, y, 8.0), MM.SUPPORT_TOP - 0.3
        mid = [(ray_hit(tri_p, np.array([x, y, zp]) + 5.0 * d, -d) - ray_hit(tri_p, np.array([x, y, zp]) - 5.0 * d, d))
               / 2 for d in (ex, ey)]
        post_off.append(math.hypot(*mid))
    pads = []
    for fx, fy in MM.FEET:
        tri_f = near(tri, fx, fy, 10.0)

        def flat(j, fx=fx, fy=fy, tri_f=tri_f):
            """the ring of radius 0.05 j round the foot on the bottom plane"""
            pts, _ = ring(fx, fy, 0.0, 0.05 * j, 32)
            pts[:, 2] = [MM.z_bottom(y) - 1.0 for y in pts[:, 1]]
            return np.abs(ray_hits(tri_f, pts, (0, 0, 1)) - 1.0).max() <= 0.02   # not off the bottom plane

        # the last ring on the plane, in 0.05 mm steps up to 8 mm; the pad is flat out to where it steps into the
        # hollow, so bisect as rib_width() does: lo on the plane (radius 0 is), hi off it
        lo, hi = 0, 160
        if flat(hi):
            lo = hi
        while hi - lo > 1:
            mid = (lo + hi) // 2
            lo, hi = (mid, hi) if flat(mid) else (lo, mid)
        pads.append(0.05 * lo)
    # the cavity over the board, along and across it; the floor's top under the board, beside the column and the
    # post; the plug opening's bottom under the socket, in the back wall; each screw hole between the counterbore
    # seat and the board; the BOOT hole, half way through the floor
    zc = S.PLATE_Z0 / 2
    cavity = (across(tri, (B.W / 2, B.H / 2, zc), ex)[0], across(tri, (B.USB_X / 2, B.H / 2, zc), ey)[0])
    floor = [-2.0 - ray_hit(near(tri, x, y, 5.0), np.array([x, y, -2.0]), down)
             for x, y in ((40.0, 20.0), (115.0, 45.0))]
    u = MM.USB_OPEN
    opening = u["z"] - ray_hit(tri_u, np.array([B.USB_X, -mid_w, u["z"]]), down)
    zh = (S.SEAT_Z - S.PCB_T) / 2
    holes = [max(across(near(tri, mx, my, 10.0), (mx, my, zh), d)[0] for d in TURN) for mx, my in B.MOUNTS]
    tri_b = near(tri, *B.BOOT, 10.0)
    boot = max(across(tri_b, (*B.BOOT, MM.Z_FLOOR_TOP - 1.0), d)[0] for d in TURN)
    return dict(cb=(min(cb), max(cb)), wall=min(wall), seat_t=min(seat_t), seat_z=(min(seat_z), max(seat_z)),
                bar=bar, bar_wall=bar_wall, wall_top=(min(tops), max(tops)),
                slot=(min(widths), max(widths), is_open, max(abs(b - a) / 2 for a, b in sides)), post_top=posts,
                post_off=max(post_off),
                pad=min(pads), cavity=cavity, floor=(min(floor), max(floor)), opening=opening,
                holes=(min(holes), max(holes)), boot=boot)


def plate_measures(tri):
    """measured on the plate mesh (plate frame, back face at z 0), as a dict, each feature found by rays from fixed
    points beside it, each diameter the largest reading over TURN. The encoder pockets: across the lugs `ec_w` and
    along `ec_h` (1 mm into the pocket) and their depth `ec_depth` (least and most of the three each); the RANGE
    pocket's diameter `rp_d` and depth `rp_depth`; how far the worst pocket's middle is off its part's axis
    `pocket_off`. The light holes `lights`: name -> (how far off its place, diameter). The
    bosses: how far the worst is off its place `boss_off`, their diameters `boss_d` and heights `boss_h` (least and
    most; the height from below, between the tapped hole and the boss edge) and the deepest tapped hole `tap` (up
    its axis from the boss end to the drill point), the tap drill's diameter half way up `drill` and half way up the
    countersink, less the countersink's width there, `sink` (least and most); how far the encoder pockets' corners
    are off their radius `ec_corner`, along the line to each corner arc's centre.
    The tongue `tongue`: off its place along the edge `x`, its
    outer face off the plate's back edge (the DXF outline) `out`, and its size w, d, h. Over the pockets: the key
    holes `keys` (width w and height h, least and most, and the worst middle off its key), the encoder holes
    `shaft` (diameter, least and most) and the RANGE hole `range_d`, the worst of those holes off its part's axis
    `hole_off`. The through holes of the DXF's CUT layer `cut`, each where the DXF has it: the worst middle off
    and size off; how many the DXF has `cut_n` and the plate `through`; the plate's extent off the DXF's outline
    `extent`. The corner radii of every key hole `key_r` and of the outline `out_r`, each a pair of lists (in the
    DXF, on the plate)."""
    ex, ey, up = np.array([1.0, 0.0, 0.0]), np.array([0.0, 1.0, 0.0]), np.array([0.0, 0.0, 1.0])
    z0 = -20.0

    def opening(x, y, z, round_):
        """the hole or pocket round (x, y) at height z: its middle off (x, y) and its width and height (a round
        one: its diameter for both)"""
        t = near(tri, x, y, 15.0)
        (w, ox), (h, oy) = across(t, (x, y, z), ex), across(t, (x, y, z), ey)
        if round_:
            w = h = max(across(t, (x + ox, y + oy, z), d)[0] for d in TURN)
        return ox, oy, w, h

    def from_outside(c, d, reach):
        """a part that stands alone round the point c, found from `reach` away on both sides along d: (its size,
        its middle off c)"""
        a, b = (reach - ray_hit(tri, np.array(c) + sg * reach * d, -sg * d) for sg in (-1.0, 1.0))
        return a + b, (b - a) / 2

    ec_w, ec_h, ec_depth, pocket_off, ec_corner = [], [], [], [], []
    for name in ("ALTHDG", "FREQ", "FMS"):
        cx, cy = PS.P(*getattr(B, name))
        ox, oy, w, h = opening(cx, cy, 1.0, False)
        ec_w.append(w); ec_h.append(h); pocket_off.append(math.hypot(ox, oy))
        ec_depth.append(ray_hit(tri, np.array([cx + S.EC11_POCKET[0] / 2 - 1.0, cy, z0]), up) + z0)
        # each corner: from the pocket's middle towards the centre of its corner arc, which it meets r past it
        pw, ph, pr, _ = S.EC11_POCKET
        for sx, sy in itertools.product((-1.0, 1.0), repeat=2):
            c = np.array([sx * (pw / 2 - pr), sy * (ph / 2 - pr), 0.0])
            ec_corner.append(abs(ray_hit(near(tri, cx, cy, 15.0), np.array([cx, cy, 1.0]), c / np.linalg.norm(c))
                                 - np.linalg.norm(c) - pr))
    cx, cy = PS.P(*B.RANGE)
    ox, oy, rp_d, _ = opening(cx, cy, 1.0, True)
    pocket_off.append(math.hypot(ox, oy))
    rp_depth = ray_hit(tri, np.array([cx + (S.RANGE_HOLE + S.RANGE_POCKET[0]) / 4, cy, z0]), up) + z0
    lights = {}
    for name, ((lx, ly), _g, _c) in B.LEDS.items():
        ox, oy, dia, _ = opening(*PS.P(lx, ly), S.PLATE_T / 2, True)
        lights[name] = (math.hypot(ox, oy), dia)
    zf = (max(S.EC11_POCKET[3], S.RANGE_POCKET[1]) + S.PLATE_T) / 2         # over every pocket floor
    keys = [opening(*PS.P(x, y), zf, False) for y in B.ROWS for x in B.COLS]
    shaft = [opening(*PS.P(*getattr(B, n)), zf, True) for n in ("ALTHDG", "FREQ", "FMS")]
    rng = opening(*PS.P(*B.RANGE), zf, True)
    cut_layer = PA.dxf_layers()["CUT"]
    outline = max(cut_layer, key=lambda p: np.ptp(np.array(p), axis=0).prod())

    xy = np.unique(tri[:, :, :2].reshape(-1, 2), axis=0)

    def corners(p):
        """the corner radii of a rounded rectangle in the DXF (points p) and on the plate there: the circle fitted
        to the mesh's vertices (each on its face) in the corner's quarter within 0.25 of the DXF's arc."""
        dxf, plate = [], []
        for arc in corner_arcs(p):
            c, r = fit_circle(arc)
            w = xy - c
            on = (w * (arc.mean(0) - c) > 0).all(1) & (np.abs(np.hypot(*w.T) - r) < 0.25)
            dxf.append(r); plate.append(fit_circle(xy[on])[1])
        return dxf, plate

    cut_off, cut_size, key_r = 0.0, 0.0, [[], []]
    out_r = corners(np.array(outline))
    for poly in cut_layer:
        if poly is outline:
            continue
        p = np.array(poly)
        (hx, hy), (w, h) = (p.max(0) + p.min(0)) / 2, np.ptp(p, axis=0)
        r = np.hypot(*(p - (hx, hy)).T)
        is_round = r.max() - r.min() < 1e-3
        ox, oy, mw, mh = opening(hx, hy, zf, is_round)
        cut_off, cut_size = max(cut_off, math.hypot(ox, oy)), max(cut_size, abs(mw - w), abs(mh - h))
        if not is_round:                                    # the key holes, the only ones not round
            dxf, plate = corners(p)
            key_r[0] += dxf; key_r[1] += plate
    v = tri.reshape(-1, 3)
    o = np.array(outline)
    extent = float(np.abs(np.concatenate([v[:, :2].min(0) - o.min(0), v[:, :2].max(0) - o.max(0)])).max())
    rb = (S.TAP["drill"] / 2 + S.TAP["cham"] + S.BOSS["d"] / 2) / 2      # between the countersink and the boss edge
    zb = -S.BOSS["h"] / 2
    offs, dias, heights, depths, drills, sinks = [], [], [], [], [], []
    for mx, my in B.MOUNTS:
        px, py = PS.P(mx, my)
        ox, oy = from_outside((px, py, zb), ex, 6.0)[1], from_outside((px, py, zb), ey, 6.0)[1]
        offs.append(math.hypot(ox, oy))
        dias.append(max(from_outside((px + ox, py + oy, zb), d, 6.0)[0] for d in TURN))   # across its own middle
        end = ray_hit(tri, np.array([px + rb, py, z0]), up) + z0                 # the boss end face
        heights.append(-end)
        tip = ray_hit(tri, np.array([px, py, z0]), up) + z0                      # the drill point's tip
        depths.append(tip - end)
        drills.append(max(across(near(tri, px, py, 6.0), (px, py, (end + tip) / 2), d)[0] for d in TURN))
        # the countersink half way up: the drill and the countersink's width there (90 deg)
        sinks.append(max(across(near(tri, px, py, 6.0), (px, py, end + S.TAP["cham"] / 2), d)[0] for d in TURN)
                     - S.TAP["cham"])
    tg = S.USB_TONGUE
    tx, ty = PS.P(B.USB_X, -S.OVH)
    c = (tx, ty - tg["d"] / 2, -tg["h"] / 2)                             # the tongue's middle
    (w, x_off), (d, y_off) = from_outside(c, ex, tg["w"] / 2 + 6.0), from_outside(c, ey, tg["d"] / 2 + 6.0)
    # its outer face against the plate's back edge, the DXF outline's largest y
    tongue = dict(x=x_off, out=c[1] + y_off + d / 2 - o[:, 1].max(), w=w, d=d,
                  h=-(ray_hit(tri, np.array([tx, ty - tg["d"] / 2, z0]), up) + z0))
    return dict(ec_w=(min(ec_w), max(ec_w)), ec_h=(min(ec_h), max(ec_h)), ec_depth=(min(ec_depth), max(ec_depth)),
                rp_d=rp_d, rp_depth=rp_depth, pocket_off=max(pocket_off), lights=lights, boss_off=max(offs),
                boss_d=(min(dias), max(dias)),
                boss_h=(min(heights), max(heights)), tap=max(depths), drill=(min(drills), max(drills)),
                sink=(min(sinks), max(sinks)), ec_corner=max(ec_corner), tongue=tongue,
                keys=dict(w=(min(k[2] for k in keys), max(k[2] for k in keys)),
                          h=(min(k[3] for k in keys), max(k[3] for k in keys)),
                          off=max(math.hypot(k[0], k[1]) for k in keys)),
                shaft=(min(s[2] for s in shaft), max(s[2] for s in shaft)), range_d=rng[2],
                hole_off=max(math.hypot(s[0], s[1]) for s in [*shaft, rng]), cut=(cut_off, cut_size),
                cut_n=len(cut_layer) - 1, through=through_holes(tri), extent=extent, key_r=key_r, out_r=out_r)


def range_measures(range_knob):
    """measured on the RANGE knob (its XZ section, on the side without dimples): its skirt diameter, the dish (how
    far the rim's bottom edge is over the hub's flat) and the rim's thickness at its edge."""
    sk = solid_radius(range_knob)
    edge = crossings(range_knob, sk - 0.001)
    return dict(skirt_d=2 * sk, dish=edge[0] - crossings(range_knob, S.RANGE_KNOB["hub_d"] / 2 - 0.05)[0],
                rim=edge[1] - edge[0])


def pair_measures(tri):
    """measured on the mesh of the light pipe pair as it is ordered (lightpipes.step), each as (least, most) of
    the two pipes: the base and rod diameters (the largest reading over TURN), the base's length up to the shoulder
    and the whole length, from the base's bottom face beside the neck; the necks' diameter and length (the gap
    between the bar and a base, beside the neck). And the bar's section (width, height) and the part's size over
    all, largest first."""
    pp, pitch = S.PIPE, K.PIPE_PITCH
    ey, ez = np.array([0.0, 1.0, 0.0]), np.array([0.0, 0.0, 1.0])
    rod_r, base_r = (S.LIGHT_HOLE - pp["clear"]) / 2, pp["base_d"] / 2
    zb, zr, top = pp["base_len"] / 2, pp["base_len"] + pp["top_len"] / 2, pp["len"] + 1.0
    beside = (pp["neck_d"] + pp["bar"][0]) / 4                           # between a neck and the bar's edge
    m = dict(base_d=[], rod_d=[], base_len=[], len=[], neck_d=[], neck_len=[])
    for x in (0.0, pitch):
        bottom = zb - ray_hit(tri, np.array([x + beside, 0.0, zb]), -ez)            # the base's bottom face
        m["base_d"].append(max(across(tri, (x, 0.0, zb), d)[0] for d in TURN))
        m["rod_d"].append(max(across(tri, (x, 0.0, zr), d)[0] for d in TURN))
        m["base_len"].append(top - ray_hit(tri, np.array([x + (rod_r + base_r) / 2, 0.0, top]), -ez) - bottom)
        m["len"].append(top - ray_hit(tri, np.array([x, 0.0, top]), -ez) - bottom)
        m["neck_d"].append(max(across(tri, (x, 0.0, -pp["neck_len"] / 2), d)[0] for d in TURN))
        m["neck_len"].append(ray_hit(tri, np.array([x + beside, 0.0, -1e-3]), -ez) + 1e-3)
    mid = (pitch / 2, 0.0, -pp["neck_len"] - pp["bar"][1] / 2)           # inside the bar
    size = sorted((tri.reshape(-1, 3).max(0) - tri.reshape(-1, 3).min(0)).tolist(), reverse=True)
    return dict({k: (min(v), max(v)) for k, v in m.items()},
                bar=(across(tri, mid, ey)[0], across(tri, mid, ez)[0]), size=size)


def rib_width(name, z=1.5):
    """width of the first rib (along +x) of the generated cap of set name, z over the socket mouth: rays along +x
    hit the rib face well inside the 3.8 mm bore, or the bore wall beside the rib."""
    tri, R = first_cap(name), S.CAP_SOCKET["d"] / 2

    def on_rib(y):
        return ray_hit(tri, np.array([0.0, y, z]), np.array([1.0, 0.0, 0.0])) < math.sqrt(R * R - y * y) - 0.05
    lo, hi = 0.0, 1.0                                   # 1.0: short of the next rib (at 90 deg)
    if not on_rib(lo) or on_rib(hi):
        raise ValueError(f"cap set {name}: no rib along +x")
    for _ in range(20):
        mid = (lo + hi) / 2
        lo, hi = (mid, hi) if on_rib(mid) else (lo, mid)
    return 2 * lo


def solid_radius(shape):
    """largest radius of a solid of revolution about z (its XZ section)."""
    return max(max(abs(x) for x in xs) for xs, _ in section(shape, 0.0))


def rib_profile(name, dz=0.02):
    """the generated cap's ribs, measured: (z, rib circle diameter) where all ribs touch the plunger's cone line,
    and the largest deviation of the rib circle from the set's cone (stack.cap_rib_d) there."""
    tri, sk = first_cap(name), S.CAP_SOCKET
    hs, R = sk["depth"], sk["d"] / 2
    zs, ds, dev = [], [], []
    for z in np.arange(dz, hs - dz / 2, dz):
        r = [ray_hit(tri, np.array([0.0, 0.0, z]), np.array([math.cos(a), math.sin(a), 0.0]))
             for a in np.radians(sk["rib_angles"])]
        if max(r) < R - 0.05 and z >= sk["lead"]:          # on every rib, above the lead-in
            zs.append(z); ds.append(2 * np.mean(r))
            dev.append(max(abs(2 * x - S.cap_rib_d(name, hs - z)) for x in r))
    if not zs:
        raise ValueError(f"cap set {name}: no ribs found in the generated socket")
    return np.array(zs), np.array(ds), max(dev)


def cap_texture():
    """the caps' texture as ordered (caps-A.zip; every set has the same one), RGB array."""
    base = "avionics-panel-rev1-caps-A"
    with zipfile.ZipFile(HERE / f"{base}.zip") as z:
        return np.asarray(Image.open(io.BytesIO(z.read(f"{base}.png"))).convert("RGB"))


def legend_strokes(gap=S.LEGEND_STROKE_MIN):
    """Legend strokes on the generated texture: in each cap's cell, how far coloured ink that a disk of dia gap
    cannot cover reaches (thin_depth): a stroke under gap shows up over its whole length, a corner or an arrow
    tip only over a fraction of gap. The worst cap and that depth."""
    tex = cap_texture()
    cell = 512                                                     # make_caps.py: 8 x 8 cells of 512 px
    res = max(S.CAP["w"], S.CAP["h"]) / cell                       # mm per pixel
    labels = [label for row in S.KEY_LEGENDS for label, _ in row]
    worst = (0.0, "none")
    pad = int(gap / res) + 3
    for k, label in enumerate(labels):
        x0, y0 = (k % 8) * cell, (k // 8) * cell
        ink = tex[y0:y0 + cell, x0:x0 + cell].max(axis=2) > 128
        if not ink.any():
            continue
        ys, xs = np.nonzero(ink)
        m = np.pad(ink[ys.min():ys.max() + 1, xs.min():xs.max() + 1], pad)
        d = thin_depth(m, res, False, gap)
        worst = max(worst, (d, label))
    return worst


def legend_front(label):
    """how far the label's ink reaches from the cap centre towards the front edge (mm), on the generated texture
    (texture rows run from the back edge down to the front edge)"""
    tex, cell = cap_texture(), 512
    res = max(S.CAP["w"], S.CAP["h"]) / cell
    k = [lab for row in S.KEY_LEGENDS for lab, _ in row].index(label)
    x0, y0 = (k % 8) * cell, (k // 8) * cell
    ys = np.nonzero(tex[y0:y0 + cell, x0:x0 + cell].max(axis=2) > 128)[0]
    return (ys.max() + 1 - cell / 2) * res


def cap_rows(face_lo, bow_dn):
    """key cap rows: rigid ribs on the plunger cone measured on the generated caps, four fit sets against the
    print tolerance, set marks, tactile bars and legends against JLC3DP's minimums. The plate at the key nearest
    its middle stands up to bow_dn lower (bowed towards the board)."""
    sk, c = S.CAP_SOCKET, S.CAP
    hs = sk["depth"]
    part_tol, hole_tol = S.WJP_TOL["size"], S.WJP_TOL["hole"]
    lo_i, hi_i = S.CAP_GRIP
    sizes = sorted(S.CAP_SETS.values())
    step = max(b - a for a, b in zip(sizes, sizes[1:], strict=False))   # the widest step between two sets
    # the plunger the sets are for: TE's model, or as far off it as a reprint moved them (stack.CAP_SETS_MOVE)
    move = S.CAP_SETS_MOVE
    plunger = S.plunger_d(hs) + move
    # interference on a true print (diametral) at the socket mouth, from the design: the sets' print coverage
    fit = {n: plunger - S.cap_rib_d(n, hs) for n in S.CAP_SETS}
    # set dimples: walls to the socket bore and to the cap outline, nominal and at the worst print
    mk, bar = S.CAP_MARK, S.CAP_BAR
    front = [lab for lab, edge in S.CAP_BAR_EDGE.items() if edge == 1]       # the caps with a front bar
    to_socket = min(math.hypot(x, y) - sk["d"] / 2 for x, y in mk["pos"]) - mk["d"] / 2
    to_edge = min(-rrect_sd(np.array(x), np.array(y), c["w"], c["h"], c["r"]) for x, y in mk["pos"]) - mk["d"] / 2
    dim_wall = min(to_socket, to_edge)
    dim_worst = min(to_socket - hole_tol, to_edge - part_tol / 2 - hole_tol / 2)
    ink_d, ink_at = legend_strokes()
    rib_w = min(rib_width(n) for n in S.CAP_SETS)
    rows = [
        (f"cap socket ribs {rib_w:.2f} wide (measured on the generated caps), on the socket wall over their "
         "length, beyond 1.0 (WJP)", rib_w - 1.0),
        (f"cap wall round the {sk['d']} mm socket (narrow sides), outline -{part_tol}, bore +{hole_tol}, beyond 1.0 "
         "(WJP)", (c["h"] - part_tol - sk["d"] - hole_tol) / 2 - 1.0,
         ("Caps", "Wall round the socket at the worst print, over 1.0 mm")),
        (f"cap set dimples {mk['d']} across, {mk['depth']} deep, beyond 0.8 (JLC3DP engraved detail)",
         min(mk["d"], mk["depth"]) - 0.8),
        (f"cap set dimples: wall to the socket and the outline ({dim_wall:.2f}), beyond 1.0 (WJP)", dim_wall - 1.0),
        (f"cap set dimples: wall at the worst print (outline -{part_tol}, socket and dimple +{hole_tol}), beyond "
         "0.8", dim_worst - 0.8),
        (f"tactile bars {bar['d']} wide, beyond 0.8 (JLC3DP embossed detail; only {bar['proud']} proud, see stack.py)",
         bar["d"] - 0.8),
        (f"front tactile bar ({bar['proud']} proud) hides none of the {' and '.join(front)} legends from "
         f"{S.CAP_VIEW_DEG:.0f} deg",
         min(S.CAP["h"] / 2 - S.CAP["cham"] - legend_front(lab) - bar["inset"] - bar["d"] / 2
             for lab in front) - bar["proud"] / math.tan(math.radians(S.CAP_VIEW_DEG))),
        (f"cap legend strokes at least {S.LEGEND_STROKE_MIN} wide (WJP colour): thinner ink reaches {ink_d:.2f} "
         f"(on {ink_at}), corners and tips only, within 0.25", 0.25 - ink_d),
        (f"cap bore clears the plunger between the ribs (bore {sk['d']} -{hole_tol}, plunger {plunger:.2f} "
         "at the mouth)", (sk["d"] - hole_tol - plunger) / 2),
        (f"cap seats on the plunger top: cap bottom over the switch body ({S.SWITCH_BODY_TOP:.1f}), pressed",
         c["base"] - S.KEY_TRAVEL - S.PLUNGER_TOP_TOL - S.SWITCH_BODY_TOP),
        # The plate bowed towards the board at the key nearest its middle, the board taken flat: a board bowed
        # towards the plate (PCB_BOW) lifts the caps in the middle by up to 0.1, and with it the
        # socket ceiling, a cosmetic limit (the socket stays inside the cap). The pressed cap's row is in
        # clearances(), for a firm press (stack.PRESS_FIRM).
        (f"cap socket ceiling (on the plunger top, +{S.PLUNGER_TOP_TOL}) under the lowest plate face, plate bowed "
         f"{bow_dn:.3f} down there", face_lo - bow_dn - (S.PLUNGER_TOP + S.PLUNGER_TOP_TOL),
         ("Plate high", f"Cap socket ceiling under the plate face, on a plunger at TE's +{S.PLUNGER_TOP_TOL} mm")),
        (f"cap sets' grip windows ({lo_i} to {hi_i} interference) overlap from one set to the next (step {step:.2f})",
         (hi_i - lo_i) - step),
    ]
    # the generated caps (caps-<set>.zip), one per set, cut by rays from the socket axis along every rib: the worst
    # of the sets in each row
    built = {n: rib_profile(n) for n in S.CAP_SETS}
    ribs = ", ".join(f"{n} {ds[0]:.2f} to {ds[-1]:.2f} (interference {S.plunger_d(hs - zs[0]) + move - ds[0]:.2f})"
                     for n, (zs, ds, _dev) in built.items())
    dev = max(d for _zs, _ds, d in built.values())
    span = min(zs[-1] - zs[0] for zs, _ds, _dev in built.values())
    stop = min(hs - zs[-1] for zs, _ds, _dev in built.values())
    rows += [
        (f"cap sets as built, ribs {ribs}: off their set's cone by {dev:.3f} at most, within 0.01", 0.01 - dev),
        (f"cap sets as built: ribs touch the cone over {span:.2f} mm at least (cannot rock), beyond 2.0", span - 2.0),
        (f"cap sets as built: ribs stop {stop:.2f} under the ceiling at least, below the plunger's rounded edge "
         f"({S.PLUNGER['dz0']})", stop - S.PLUNGER["dz0"]),
    ]
    # print error e (rib circle printed larger by e): interference i - e; the best set's margin to CAP_GRIP
    e_lo, e_hi = S.CAP_PRINT
    worst = min(max(min(f - e - lo_i, hi_i - (f - e)) for f in fit.values())
                for e in np.linspace(e_lo, e_hi, 301))
    rows.append((f"cap sets grip rib circles printed {-e_lo:.2f} small to {e_hi:.2f} large (one of {len(fit)} within "
                 f"{lo_i} to {hi_i}), on a plunger {move:+.2f} off TE's model", worst,
                 ("Caps", f"Cap sets' coverage beyond a rib circle printed {-e_lo:g} mm small or {e_hi:g} mm large")))
    rows.append((f"cap sets moved {move:+.2f} (stack.CAP_SETS_MOVE), up to TE's +-0.30 on the plunger diameter",
                 0.35 - abs(move)))                       # three 0.1 steps either way, not a fourth
    return rows


def key_hole_max():
    """the key hole at its largest (+KEY_HOLE_TOL on width and height, after anodising)."""
    (w, h, r), up = S.KEY_HOLE, S.KEY_HOLE_TOL[0]
    return w + up, h + up, r + up / 2


def plate_bow(x, y):
    """how far a bowed plate stands off the plane of its four corner bosses at board point (x, y), per mm of bow (the
    drawing's flatness): the worst of a dome (the reading is the plate's corners against its
    middle), a bow along the plate (its ends against its middle) and a bow across it (its long edges against its
    middle line). The middle boss, which holds the plate and the board together there, is left out: it only
    makes both flatter."""
    hx, hy = B.W / 2 + S.OVH, B.H / 2 + S.OVH                          # plate half length and width
    sx, sy = B.W / 2 - B.CORNER_MOUNTS[0][0], B.H / 2 - B.CORNER_MOUNTS[0][1]   # corner bosses off the middle
    dx, dy = x - B.W / 2, y - B.H / 2
    dome = (sx * sx + sy * sy - dx * dx - dy * dy) / (hx * hx + hy * hy)
    along = (sx * sx - dx * dx) / (hx * hx)
    across = (sy * sy - dy * dy) / (hy * hy)
    return max(dome, along, across, 0.0)


def mjf(length):
    """JLC3DP MJF tolerance on a length (+-): stack.MJF_TOL up to 100 mm, MJF_SCALE of it above."""
    return max(S.MJF_TOL, S.MJF_SCALE * length)


def usb_rows():
    """USB-C socket and plug in the back wall opening (make_mech.USB_OPEN, carried up as a slot): its sides and
    bottom. Its top edge is the plate's tongue (tongue_rows)."""
    u, place, hole = MM.USB_OPEN, S.LED_LENS["place"], S.POS_TOL["body_hole"]   # J1's placement, MJF on the opening
    # the board lies anywhere in the cavity (CLEAR). Its sideways play is set by its short edges against the
    # side walls: routed (+-0.2) without edge rails, but taken as V-cut (+-PCB_VCUT_TOL), the fallback should
    # JLCPCB put rails on them: at worst one of them is that much short.
    # Against a side wall the opening sits that far plus USB_X (or W - USB_X) from the board edge, and MJF puts
    # it within mjf() of that length from the wall: this also covers a body printed large, whose gap grows
    edge = MM.CLEAR + S.PCB_VCUT_TOL
    float_ = edge + max(mjf(B.USB_X + MM.CLEAR), mjf(B.W - B.USB_X + MM.CLEAR))   # 0.9 + 0.51 (left wall)
    j1w, j1h = B.J1_BODY[2] - B.J1_BODY[0], MM.J1_H     # the socket face is at board y J1_BODY[1]
    bot = u["z"] - u["h"] / 2                            # opening bottom
    z_tol = mjf(-S.PCB_T - bot)                         # MJF: boss top (the PCB underside) to the opening bottom
    om_w, om_h = MM.USB_PLUG
    ow, oh, orr = u["w"] - 2 * hole, u["h"] - 2 * hole, u["r"] - hole
    zc = -S.PCB_T - j1h / 2 - u["z"]                    # plug centre, on the socket's middle, over the opening's
    # a square overmould (no corner radius) off centre by the float and J1 in x, J1 and the body height in z:
    # least clearance to the opening's sides and bottom (above its middle the opening is a slot with straight
    # sides); J1 and the body both hang from the PCB underside, so the PCB thickness drops out
    xs = np.linspace(-om_w / 2, om_w / 2, 241)
    zs = np.linspace(-om_h / 2, om_h / 2, 131)
    ex = np.concatenate([xs, xs, np.full_like(zs, -om_w / 2), np.full_like(zs, om_w / 2)])
    ez = np.concatenate([np.full_like(xs, -om_h / 2), np.full_like(xs, om_h / 2), zs, zs])
    om = 1e9
    for sx in (-1, 1):
        for sz in (-1, 1):
            x, z = ex + sx * (float_ + place), ez + zc + sz * (place + z_tol)
            sd = np.minimum(rrect_sd(x, z, ow, oh, orr), np.where(z > 0, np.abs(x) - ow / 2, np.inf))   # the slot
            om = min(om, -sd.max())
    if om_w < j1w or om_h < j1h:                        # a plain raise: asserts vanish under -O
        raise ValueError("the plug overmould must be larger than J1's shell: its row stands for the socket's too")
    return [
        (f"USB-C socket ({j1h} high, J1 {place}) over the body floor under the PCB ({MM.UNDER} room, MJF "
         f"-{mjf(MM.UNDER)})", MM.UNDER - j1h - place - mjf(MM.UNDER)),
        (f"USB-C overmould ({om_w} x {om_h}, square; the socket, {j1w:.2f} x {j1h}, {-B.J1_BODY[1]:.2f} past the "
         f"PCB edge, lies inside it) in the {u['w']} wide opening (R{u['r']} below, open to the tongue above): "
         f"board {float_:.2f} off (cavity, V-cut edge, MJF on the opening), J1 {place}, body height {z_tol}, MJF "
         f"-{hole}", om, ("USB-C", f"Plug overmould ({om_w} x {om_h:.1f} mm) in the opening")),
    ]


def tongue_rows(back_lo, back_hi, bow, board, slot, measured):
    """the plate's tongue (stack.USB_TONGUE) in the body's slot over the USB-C opening: its sides in the slot, its
    end over the plug and the board, its inner face short of J1's shell tabs. back_lo, back_hi: the plate's back
    face at its lowest and highest; bow: the plate's bow at the tongue, either way; board: the board off the
    plate's hole pattern, at most (the caps, the plate, the PCB); slot: the slot's width as built, least and most
    (body_measures); measured: the tongue on the plate solid (plate_measures)."""
    t, hole, pt = S.USB_TONGUE, S.POS_TOL["body_hole"], S.POS_TOL
    place, pcb_tol = S.LED_LENS["place"], S.STACK_TOL["pcb"]         # J1's placement
    om_w, om_h = MM.USB_PLUG
    slot_lo, slot_hi = slot[0] - 2 * hole, slot[1] + 2 * hole
    # the slot against the tongue with the body centred on its screws, as it is put on by eye before they are
    # tightened: MJF from the middle of the screw pattern, and the tongue against the bosses on the plate. The
    # screws' play (make_mech.SCREW_OFFSET) lets the body sit further off, up to where the tongue stops it.
    x_off = mjf(abs(B.USB_X - B.W / 2)) + pt["plate"]
    side = (slot_lo - t["w"] - t["tol"]) / 2 - x_off
    side_hi = (slot_hi - t["w"] + t["tol"]) / 2 + x_off
    end_lo = back_lo - bow - t["h"] - t["tol"]                      # the tongue's end over the PCB top
    end_hi = back_hi + bow - t["h"] + t["tol"]
    # the plug on the socket's middle, the socket hanging under a thin board (the plate stands on the board's top)
    om_top = -S.PCB_T + pcb_tol - MM.J1_H / 2 + om_h / 2 + place
    # the tongue's inner face, how far outside the board's back edge: the board that far towards it, the tongue thick
    inner = S.OVH - t["d"] - t["d_tol"] - board
    m = measured
    return [
        (f"plate tongue {m['w']:.2f} x {m['d']:.2f}, {m['h']:.2f} long, {abs(m['x']):.2f} off its place over the "
         f"socket and {abs(m['out']):.2f} off the plate's edge (measured on the plate) is the stack's ({t['w']} x "
         f"{t['d']}, {t['h']})", 0.01 - max(abs(m["w"] - t["w"]), abs(m["d"] - t["d"]), abs(m["h"] - t["h"]),
                                           abs(m["x"]), abs(m["out"]))),
        (f"USB-C tongue ({t['w']} +{t['tol']}) in the {slot[0]:.2f} slot (measured on the body, MJF -{2 * hole:.1f}), "
         f"per side, the slot {x_off:.2f} off it (MJF, plate) with the body centred on its screws by eye", side,
         ("USB-C", f"Tongue's smallest side gap in the body's slot, the body centred (largest gap {side_hi:.2f} mm, "
                   f"limit {S.USB_GAP_MAX})")),
        (f"USB-C tongue side gap at most {side_hi:.2f} with the body centred on its screws (slot +{2 * hole:.1f}, "
         f"tongue -{t['tol']}, off the other way), within {S.USB_GAP_MAX}", S.USB_GAP_MAX - side_hi),
        # the overmould's top stands over the PCB top, so the tongue's end also clears the board that reaches under
        # it, and with it the tongue is shorter than the bosses
        (f"USB-C tongue end ({end_lo:.2f} over the PCB top at its lowest: low plate bowed {bow:.3f} down, tongue "
         f"+{t['tol']}) over the plug overmould's top ({om_top:.2f} over the PCB top: PCB -{pcb_tol}, J1 {place})",
         min(end_lo - om_top, end_lo), ("Plate high", "Tongue's end over the plug overmould")),
        (f"USB-C tongue end at most {end_hi:.2f} over the PCB top (tongue -{t['tol']}, high plate bowed up): the gap "
         f"over the plug within {S.USB_GAP_MAX}", S.USB_GAP_MAX - end_hi),
        (f"USB-C tongue ({t['w']} -{t['tol']}) covers the plug overmould ({om_w}) across, the board {board:.2f} off "
         f"the plate, J1 {place}", (t["w"] - t["tol"]) / 2 - om_w / 2 - board - place,
         ("USB-C", "Tongue covers the plug overmould across")),
        (f"USB-C tongue's inner face ({t['d']} +{t['d_tol']} thick, the board {board:.2f} towards it) short "
         f"of J1's shell tabs and their fillets ({MM.J1_TABS_IN} in from the board edge)", MM.J1_TABS_IN + inner,
         ("USB-C", "Tongue's inner face short of the J1 shell tabs")),
        (f"USB-C tongue {t['d']} thick, {t['h']} long: within 4 x its thickness (milling; a ratio)",
         4 - t["h"] / t["d"], ""),
    ]


def plan_item(f):
    """a feature of the body in plan, a rectangle (x0, y0, x1, y1) or a disc (x, y, r), as a geom.py item."""
    return ("cap", f[0], f[1], f[0], f[1], f[2]) if len(f) == 3 else ("rect", *f, 0.0)


def under_board(pads):
    """what hangs under the board, in plan: (name, geom.py item, how far it can be off its place on the board) of
    every through-hole lead, taken as wide as its solder fillet can get (its pad), and of every bottom-side
    part's body (board.bodies())."""
    on_pins = {"K": S.CAP_TOL["switch"], "ENC": S.ENC_ON_PINS, "RANGE": S.RKJXT_ON_PINS, "J1": S.LED_LENS["place"]}
    leads = [(q.name, pad_geom(q), next(v for k, v in on_pins.items() if q.name.startswith(k)))
             for q in pads if q.drill]
    return leads + [(ref, ("rect", *r, 0.0), S.LED_LENS["place"]) for ref, r in B.bodies().items()]


def cavity_play():
    """how far the board can lie off the body's middle while the body is lowered over it, no screw in yet (the
    board against a cavity wall): in x (a large cavity, a board routed short) and in y (MJF on the cavity width,
    the board with a V-cut edge short)."""
    play_x = ((B.W + 2 * MM.CLEAR) * (1 + S.MJF_SCALE) - (B.W - S.PCB_OUTLINE_TOL)) / 2
    cav_h = B.H + 2 * MM.CLEAR
    play_y = (cav_h + mjf(cav_h) - (B.H - max(S.PCB_OUTLINE_TOL, S.PCB_VCUT_TOL))) / 2
    return play_x, play_y


def room_rows(pads, board_off, bar):
    """the body's features in the room under the board against every through-hole lead (as wide as its pad, for its
    solder fillet) and every bottom-side part: the post, the corner bosses with the blocks that join them to the
    walls, and the middle column (its bar as built, `bar` from body_measures, and its round boss). Each feature at
    its widest, printed large. With the screws in, it is off its screw by the hole's play (the post by MJF from the
    nearest hole as well) and the board off the screw by board_off. While the body is lowered over the board, the
    board lies against the cavity walls: up to the cavity's play in x and y at once for the post and the column,
    which sit where MJF puts them in the cavity, and for a corner boss up to where MJF puts it from its two walls.
    Each row is the least over all leads and parts, of the worse of the two cases."""
    pt = S.POS_TOL
    grow, col_off = pt["body_hole"], MM.SCREW_OFFSET
    items = under_board(pads)
    play = cavity_play()
    wall = B.CORNER_MOUNTS[0][0] + MM.CLEAR             # a corner boss from its walls (a length, MJF)
    in_corner = (MM.CLEAR + mjf(wall) + S.PCB_OUTLINE_TOL / 2,
                 MM.CLEAR + mjf(wall) + max(S.PCB_OUTLINE_TOL, S.PCB_VCUT_TOL) / 2)
    mid = B.MID_MOUNT

    def in_cavity(x, y):
        return mjf(math.hypot(x - B.W / 2, y - B.H / 2))            # a feature off its place in the cavity (MJF)

    # (name, its shapes, off its screw with the screws in, the board's play while lowered, off its place then)
    feats = [("body post", [(px, py, MM.SUPPORT_R)],
              col_off + mjf(min(math.hypot(px - mx, py - my) for mx, my in B.MOUNTS)), play, in_cavity(px, py))
             for px, py in MM.SUPPORTS]
    feats += [("corner bosses and their blocks",
               [f for mx, my in B.CORNER_MOUNTS for f in MM.corner_plan(mx, my, MM.BOSS_R_LOW)], col_off, in_corner,
               0.0),
              ("middle column (its bar and round boss)", [bar, (*mid, MM.BOSS_R)], col_off, play, in_cavity(*mid))]
    rows = []
    for what, shapes, screwed, (px_, py_), lowered in feats:
        shapes = [plan_item(f) for f in shapes]
        worst = (math.inf, "none", 0.0, 0.0, 0.0)
        for name, g, on in items:
            gap = min(item_dist(f, g) for f in shapes)
            if gap > 8.0:
                continue
            fixed = gap - (screwed + board_off + pt["pcb"] + on)
            moved = [(g[0], g[1] + dx, g[2] + dy, g[3] + dx, g[4] + dy, g[5])
                     for dx in (-px_, 0.0, px_) for dy in (-py_, 0.0, py_)]
            going_on = min(item_dist(f, q) for f in shapes for q in moved) - (lowered + pt["pcb"] + on)
            worst = min(worst, (min(fixed, going_on) - grow - S.LEAD_CLEAR, name, gap, fixed, going_on))
        margin, name, gap, fixed, going_on = worst
        rows.append((f"{what} (MJF +{grow} per side) clear of the leads' solder fillets and the bottom-side parts: "
                     f"the closest at the worst offsets is {name}, {gap:.2f} off, {fixed:.2f} left with the screws in "
                     f"(hole play, board, PCB, part) and {going_on:.2f} while the body goes on (the board against the "
                     f"cavity walls), beyond {S.LEAD_CLEAR}", margin,
                     ("Body", "Post, corner bosses and middle column clear of leads, solder fillets and bottom "
                              f"parts, over {S.LEAD_CLEAR} mm")))
    return rows


def legend_gap():
    """least distance from the amber legends' outlines (make_plate_art.py's UV_AMBER layer) to the edge of a hole
    in the plate, the key and light holes at their largest: the gap and which holes."""
    lt = (S.LIGHT_HOLE + S.LIGHT_HOLE_TOL[0]) / 2
    best = (math.inf, "none")
    for poly in PA.layers["UV_AMBER"]:
        pts = np.array(poly + poly[:1])
        seg = np.diff(pts, axis=0)
        n = np.maximum(np.ceil(np.hypot(seg[:, 0], seg[:, 1]) / 0.02).astype(int), 1)   # a point every 0.02 mm
        x, y = np.concatenate([np.linspace(a, b, k, endpoint=False)
                               for a, b, k in zip(pts, pts[1:], n, strict=False)]).T
        d = [(float(rrect_sd(x - kx, y - ky, *key_hole_max()).min()), "key holes") for ky in B.ROWS for kx in B.COLS]
        d += [(float((np.hypot(x - lx, y - ly) - lt).min()), "light holes") for (lx, ly), _g, _c in B.LEDS.values()]
        d += [(float((np.hypot(x - kx, y - ky) - (S.SHAFT_HOLE + S.PLATE_GEN_TOL) / 2).min()), "encoder holes")
              for kx, ky in (B.ALTHDG, B.FREQ, B.FMS)]
        d += [(float((np.hypot(x - B.RANGE[0], y - B.RANGE[1]) - (S.RANGE_HOLE + S.PLATE_GEN_TOL) / 2).min()),
               "RANGE hole")]
        best = min(best, min(d))
    return best


def boss_wall_rows():
    """the plate's corner bosses between the cavity walls. The body sits on its screws, which the bosses
    locate: each body hole stays within the screw's play of its axis (the hole 0.15 large on the radius, the M3 at
    its smallest), and MJF puts the hole within 0.3 of its 4.0 from the walls (a length). At the end of that play
    a boss stays clear of the wall; and with the body anywhere its screws let it sit, the four bosses fit between
    the walls at once across the cavity (MJF on its length and width, the bosses where the plate puts them)."""
    pt, sc, bo = S.POS_TOL, S.SCREW, S.BOSS
    r = (bo["d"] + bo["d_tol"]) / 2
    play = MM.SCREW_CLEAR + pt["body_hole"] - sc["d_min"] / 2
    a = np.linspace(0, 2 * np.pi, 720, endpoint=False)
    cav = (B.W + 2 * MM.CLEAR, B.H + 2 * MM.CLEAR, B.CORNER_R + MM.CLEAR)
    corners = B.CORNER_MOUNTS
    wall = float(-rrect_sd(np.array(corners[0][0] - B.W / 2), np.array(corners[0][1] - B.H / 2), *cav))
    room = min(float(-rrect_sd(mx + play * np.cos(a) - B.W / 2, my + play * np.sin(a) - B.H / 2, *cav).max())
               for mx, my in corners)
    xs, ys = sorted({mx for mx, _ in corners}), sorted({my for _, my in corners})
    span = min(cav[0] - mjf(cav[0]) - (xs[-1] - xs[0]), cav[1] - mjf(cav[1]) - (ys[-1] - ys[0])) / 2 - r - pt["plate"]
    return [(f"plate corner bosses (Ø{bo['d']} +{bo['d_tol']}) clear of the cavity walls ({wall:.1f}, MJF "
             f"-{mjf(wall)}) at the end of the body's {play:.2f} screw play", room - mjf(wall) - r,
             ("Body", "Plate corner bosses clear of the cavity walls at the end of the body's screw play")),
            ("plate corner bosses fit between the cavity walls at once (MJF on the cavity, plate positions), per "
             "side", span)]


def boss_build_row(pm):
    """the plate's bosses and tapped holes as built (pm: plate_measures) against the stack: height, diameter and
    place, the tap drill's diameter and depth to its point, the countersink."""
    bo, tp = S.BOSS, S.TAP
    return (f"plate bosses {pm['boss_h'][0]:.3f} to {pm['boss_h'][1]:.3f} high, Ø{pm['boss_d'][0]:.2f} to "
            f"Ø{pm['boss_d'][1]:.2f}, the worst {pm['boss_off']:.3f} off its place, tap drills Ø{pm['drill'][0]:.2f} "
            f"to Ø{pm['drill'][1]:.2f}, {pm['tap']:.2f} deep to the point, countersinks "
            f"{max(abs(v - tp['drill']) for v in pm['sink']):.3f} off (all {len(B.MOUNTS)}, measured on the plate) are "
            f"the stack's ({bo['h']}, Ø{bo['d']}, Ø{tp['drill']}, {tp['depth'] + tp['point']:.2f}, {tp['cham']} x 90 "
            "deg)",
            0.01 - max(*(abs(v - bo["h"]) for v in pm["boss_h"]), pm["boss_off"],
                       *(abs(v - bo["d"]) for v in pm["boss_d"]), abs(pm["tap"] - (tp["depth"] + tp["point"])),
                       *(abs(v - tp["drill"]) for v in (*pm["drill"], *pm["sink"]))))


def shared_volumes(plate):
    """the volume (mm3) that two of the placed solids share: (plate and body, plate and board, body and board). The
    plate as built here, moved from its own frame into the board's (z = 0 at the PCB top); the body as ordered
    (body.step), mirrored back from its output frame; the board as its outline, stack.PCB_T thick."""
    def mirror_y(shape, y0):                                         # y -> 2 y0 - y
        t = gp_Trsf(); t.SetMirror(gp_Ax2(gp_Pnt(0, y0, 0), gp_Dir(0, 1, 0)))
        return BRepBuilderAPI_Transform(shape, t, True).Shape()
    placed = move(mirror_y(plate, B.H / 2 + S.OVH), dx=-S.OVH, dy=-S.OVH, dz=S.PLATE_Z0)   # stack.plate_xy, inverted
    body = mirror_y(read_step("avionics-panel-rev1-body"), 0.0)
    board = rrect_prism(B.W / 2, B.H / 2, B.W, B.H, B.CORNER_R, -S.PCB_T, 0.0)
    return tuple(volume(common(a, b)) for a, b in ((placed, body), (placed, board), (body, board)))


def boss_web():
    """least plate web left between a boss (any of the five, with its root radius) and any pocket, through hole
    or the plate edge."""
    bo = S.BOSS
    r = (bo["d"] + bo["d_tol"]) / 2 + bo["root_r"]
    w, h, cr, _ = S.EC11_POCKET
    webs = []
    for mx, my in B.MOUNTS:
        d = [rrect_sd(mx - x, my - y, *key_hole_max()) for y in B.ROWS for x in B.COLS]
        d += [rrect_sd(mx - x, my - y, w, h, cr) for x, y in (B.ALTHDG, B.FREQ, B.FMS)]
        d += [math.hypot(mx - B.RANGE[0], my - B.RANGE[1]) - S.RANGE_POCKET[0] / 2]
        d += [math.hypot(mx - lx, my - ly) - S.LIGHT_HOLE / 2 for (lx, ly), _g, _c in B.LEDS.values()]
        d += [-rrect_sd(mx - B.W / 2, my - B.H / 2, B.W + 2 * S.OVH, B.H + 2 * S.OVH, B.CORNER_R + S.OVH)]
        webs.append(min(d) - r)
    return min(webs)


def pipe_gaps(back_lo, back_hi):
    """the gap from the board top to the plate back at a light (the light pipes' rows): smallest (the plate back at its
    lowest and bowed PLATE_FLAT down, the board bowed PCB_BOW up) and largest (both the other way); the room left
    over the pipe's base in the smallest (base long and grown in its first week, a sanded stub left on), and its
    shoulder's distance off the plate back in the largest (base short and shrunk in its first week)."""
    pp, tol = S.PIPE, S.PIPE["len_tol"] + S.RESIN_DRIFT
    g_min = back_lo - S.PLATE_FLAT - S.PCB_BOW
    g_max = back_hi + S.PLATE_FLAT + S.PCB_BOW
    return g_min, g_max, g_min - (pp["base_len"] + tol + pp["stub"]), g_max - (pp["base_len"] - tol)


def die_covered(r, off, die, n=121):
    """the least share of a square die (side `die`) under a light pipe's base of radius r whose axis is `off` from
    the die's centre, over the directions of that offset."""
    u = (np.arange(n) + 0.5) / n * die - die / 2
    x, y = np.meshgrid(u, u)
    return min(float(((x + off * math.cos(a)) ** 2 + (y + off * math.sin(a)) ** 2 <= r * r).mean())
               for a in np.linspace(0, math.pi / 4, 10))


def visible(recess, a, r_hole, off, light=None, caps=(), view=S.CAP_VIEW_DEG, n=161):
    """the share of a light pipe's top (radius a, off the hole's axis by `off` towards the seat, +y on the board)
    that an eye at `view` degrees sees through its hole (radius r_hole) from `recess` below the face: a point of the
    top is seen when the sightline from it leaves the hole at the face and then passes over every key cap in its way
    (the caps at `caps`, the light's hole axis at `light` in board coordinates; the face at its nominal height)."""
    u = np.linspace(-a, a, n)
    x, y = np.meshgrid(u, u)
    top = x * x + y * y <= a * a
    rise = math.tan(math.radians(view))
    seen = top & (x * x + (y + off + recess / rise) ** 2 <= r_hole * r_hole)
    if light is not None:
        c = S.CAP
        cap_top = c["base"] + c["height"]
        face = S.BOSS["h"] + S.PLATE_T + S.ANODISE
        px, py = light[0] + x, light[1] + y + off                    # the top's points on the board
        for dy in np.arange(0.0, 12.0, 0.05):                        # along the sightline towards the seat
            z = face - recess + dy * rise
            for kx, ky in caps:
                inside = -rrect_sd(px - kx, py + dy - ky, c["w"], c["h"], c["r"])   # depth inside the outline
                height = cap_top - np.maximum(0.0, c["cham"] - inside)          # its 45 deg top chamfer
                seen &= ~((inside > 0) & (z < height))
    return seen.sum() / top.sum()


def pipe_rows(back_lo, back_hi, face_lo, board, caps):
    """The light pipes (stack.PIPE) over the reverse-mount LEDs in their board cutouts (board.LED_CUTOUT). Each
    stands on the board, captive under the plate: the rows for how far its top can stand proud, never clamped, the
    top's depth under the face and how much of it shows from the seat, the shoulder, the cutout under the base, the
    LED's lens and light under it, and the base against the switch bodies and the key holes (a firmly pressed cap
    dips under the plate back). Every pipe length at +-len_tol (JLC3DP's resin) and changed by RESIN_DRIFT in its
    first week, either way, whichever costs the row; a sanded stub left on. The plate takes PLATE_FLAT in full
    here, the board PCB_BOW either way. face_lo: the plate face at its lowest."""
    pp, ll, pt = S.PIPE, S.LED_LENS, S.POS_TOL
    lt_up, tol = S.LIGHT_HOLE_TOL[0], pp["len_tol"] + S.RESIN_DRIFT
    t_min, t_max = S.PLATE_T - S.PLATE_T_TOL, S.PLATE_T + S.PLATE_T_TOL
    base_lo, base_hi = (pp["base_d"] - pp["resin"]) / 2, (pp["base_d"] + pp["resin"]) / 2
    cw, ch, cr = B.LED_CUTOUT
    route = S.PCB_CUTOUT_TOL
    g_min, g_max, room, off = pipe_gaps(back_lo, back_hi)
    # the top against the face with the shoulder on the plate back (lifted, the panel upside down): proud of the
    # thinnest bare plate with a long rod, deepest under the thickest plate anodised on both faces with a short rod;
    # in use, resting on the board: nominal (a 4.0 plate anodised on both faces, the bosses and the pipe as drawn),
    # highest (a long pipe on a board bowed up, under the lowest face of a plate bowed down) and deepest (a short
    # pipe on a board bowed down, under the highest face: one length, the pipe's whole one, with its tolerance)
    lifted = pp["top_len"] + tol - t_min
    bear_hi = t_max + S.ANODISE - (pp["top_len"] - tol)
    nominal = S.PLATE_T + S.ANODISE - pp["top_len"] + S.BOSS["h"] - pp["base_len"]
    in_use = pp["len"] + tol + pp["stub"] + S.PCB_BOW - (face_lo - S.PLATE_FLAT)
    deep = g_max + t_max + S.ANODISE - (pp["len"] - tol)
    rows = [
        (f"light pipe proud at most {pp['proud']}: lifted onto its shoulder, the top ({pp['top_len']} "
         f"+{pp['len_tol']}, +{S.RESIN_DRIFT} in its first week) stands {lifted:.2f} over the thinnest plate face "
         f"({t_min}); in use, on the board, {in_use:.2f} at most ({nominal:.2f} under the face in the nominal stack)",
         pp["proud"] - max(lifted, in_use),
         ("Light pipes", "Top over the face of a thin plate, lifted and grown in its first week, under the "
                         f"{pp['proud']} mm allowed")),
        (f"light pipe never clamped: its base ({pp['base_len']} +{pp['len_tol']}, +{S.RESIN_DRIFT} in its first week, "
         f"a {pp['stub']} stub left on) under the smallest gap ({g_min:.3f}: plate back low, bowed {S.PLATE_FLAT} "
         f"down, board {S.PCB_BOW:.2f} up)", room,
         ("Plate high", f"Light pipe base under the plate back, grown {S.RESIN_DRIFT} mm in its first week (never "
                        "clamped)")),
        (f"LED lens ({ll['h']} +{ll['tol']} over the substrate, solder {ll['solder']}) inside the thinnest board "
         f"(-{S.STACK_TOL['pcb']}), under the pipe base", S.PCB_T - S.STACK_TOL["pcb"] - ll["h"] - ll["tol"]
         - ll["solder"]),
        (f"light pipe base (Ø{pp['base_d']} -{pp['resin']}) cannot drop into the LED cutout ({cw} x {ch}, routed "
         f"+{2 * route})", 2 * base_lo - (min(cw, ch) + 2 * route)),
    ]
    # the lens (+tol) in the cutout (routed small, R at its corners), the LED placed off by `place` and turned by
    # `turn` either way
    hw, hh = (cw - 2 * route) / 2, (ch - 2 * route) / 2
    a = np.linspace(0, 2 * np.pi, 72, endpoint=False)
    lx_, ly_ = (ll["l"] + ll["tol"]) / 2, (ll["w"] + ll["tol"]) / 2
    corners = np.array([(sx * lx_, sy * ly_) for sx in (-1, 1) for sy in (-1, 1)])
    lens = -math.inf
    for turn in (-ll["turn"], 0.0, ll["turn"]):
        ca, sa = math.cos(math.radians(turn)), math.sin(math.radians(turn))
        cx, cy = corners[:, 0] * ca - corners[:, 1] * sa, corners[:, 0] * sa + corners[:, 1] * ca
        lens = max(lens, max(float(rrect_sd(cx + ll["place"] * math.cos(t), cy + ll["place"] * math.sin(t),
                                            2 * hw, 2 * hh, cr).max()) for t in a))
    rows.append((f"LED lens ({ll['l']} x {ll['w']} +{ll['tol']}, placed {ll['place']} off and turned {ll['turn']:g} "
                 f"deg) clear of its cutout ({cw} x {ch} R{cr}, routed -{route} per side)", -lens,
                 ("Light pipes", "LED lens in its board cutout, the LED placed "
                                 f"{ll['place']} mm off and turned {ll['turn']:g}°")))
    lens_depth = S.PCB_T - S.STACK_TOL["pcb"] - ll["h"] - ll["tol"] - ll["solder"]
    d = S.LIGHT_HOLE
    names = ", ".join(B.LEDS)
    # the rows that do not depend on where a light is, for both pipes at once
    rod = d - pp["clear"]
    float_ = (d + lt_up - (rod - pp["resin"])) / 2                  # the pipe off its hole's axis, at most
    on_board = float_ + board + pt["plate"] + pt["pcb"]               # and off the cutout's centre
    reach = base_hi + float_                                          # its base edge from the hole's axis
    # off the cutout's centre by on_board across it (its narrow way, routed large), the base's centre may lie over
    # the cutout: it then rests on the cutout's near edge and can tip about it, as far as the rod in its hole lets
    # it (the shortest length in it, the shoulder off the plate back at worst); the base's far rim dips by its
    # distance from that edge times the tilt
    in_hole = pp["top_len"] - tol - max(0.0, off)
    tilt = 2 * float_ / in_hole
    lever = max(0.0, (min(cw, ch) / 2 + route) - (on_board - base_lo))
    dip = lever * tilt
    r_seat = (d + lt_up) / 2
    a_min = (rod - pp["resin"]) / 2
    share = die_covered(base_lo, on_board + ll["place"], ll["die"])
    rows += [
        # (so the shoulder, wider than its hole by twice this margin and more, cannot pass it)
        (f"pipe shoulder (Ø{pp['base_d']} -{pp['resin']}, both) on the flat plate back: beyond its {d} hole "
         f"(+{lt_up}) and the hole's back edge break ({S.LIGHT_HOLE_BACK_BREAK} at most, drawing)",
         base_lo - r_seat - S.LIGHT_HOLE_BACK_BREAK),
        (f"pipe base (Ø{pp['base_d']} -{pp['resin']}, both) on the board round the cutout ({cw} x {ch} +{2 * route}): "
         f"{on_board:.2f} off its centre it may tip about the cutout's edge, but the rod ({in_hole:.2f} in its hole) "
         f"holds it within {math.degrees(tilt):.1f} deg, so its rim dips {dip:.2f}, above the LED lens "
         f"({lens_depth:.2f} under the board top)", lens_depth - dip),
        (f"pipe base over the LED (both): {100 * share:.0f} % of the die ({ll['die']} square) under it with the pipe "
         f"{float_:.2f} off its hole and the board {board:.2f} off the plate (plate, PCB, LED placed {ll['place']}), "
         f"beyond {100 * S.LED_DIE_SHARE:.0f} % (a ratio)", share - S.LED_DIE_SHARE, "",
         ("Light pipes", f"Share of the LED's die under the pipe base at the worst offsets, over "
                         f"{100 * S.LED_DIE_SHARE:.0f} % (both)")),
    ]
    for name, ((lx, ly), _, _) in B.LEDS.items():
        sw = S.SWITCH_BODY / 2 + S.CAP_TOL["switch"]
        sw_gap = min(float(rrect_sd(np.array(lx - x), np.array(ly - y), 2 * sw, 2 * sw, 0.0)) for x, y in caps)
        key_gap = min(rrect_sd(lx - x, ly - y, *key_hole_max()) for x, y in caps)
        # the key caps in front of the light (towards the seat) can shade it too: the UNIT light stands behind the
        # gap between the SHIFT cap and the next column, clear of both
        near_caps = [(x, y) for x, y in caps if 0 < y - ly < 12 and abs(x - lx) < 10]
        seen_lift = visible(bear_hi, a_min, r_seat, r_seat - a_min, (lx, ly), near_caps)   # rod against near side
        seen_nom = visible(nominal, rod / 2, d / 2, 0.0, (lx, ly), near_caps)
        seen_near = visible(nominal, a_min, r_seat, r_seat - a_min, (lx, ly), near_caps)
        seen_deep = visible(deep, a_min, r_seat, r_seat - a_min, (lx, ly), near_caps)
        seen_open = visible(nominal, rod / 2, d / 2, 0.0)                   # the hole alone
        rows += [
            (f"{name} pipe base (reach {reach + board + pt['plate'] + pt['pcb']:.2f} from the board's light axis) "
             f"clear of the switch bodies ({S.SWITCH_BODY} +{S.CAP_TOL['switch']} on its pins)",
             sw_gap - reach - board - pt["plate"] - pt["pcb"],
             ("Light pipes", f"Base clear of the switch bodies ({names})")),
            (f"{name} pipe base (reach {reach:.2f}, hole positions +-{pt['plate']}) out from under the key holes "
             f"(+{S.KEY_HOLE_TOL[0]}): a firmly pressed cap dips under the plate back inside its hole's outline",
             key_gap - reach - pt["plate"], ("Light pipes", f"Base out from under the key holes ({names})")),
            (f"{name} light seen from {S.CAP_VIEW_DEG:.0f} deg in use, resting on the board, past its hole and the "
             f"key caps in front: {100 * seen_nom:.0f} % of its top in the nominal stack ({nominal:.2f} deep; "
             f"{100 * seen_open:.0f} % past the hole alone, {100 * seen_near:.0f} % with the rod against the near "
             f"side), {100 * seen_deep:.0f} % at the worst depth ({deep:.2f}: a short pipe, shrunk in its first "
             f"week, under a high plate), {100 * seen_lift:.0f} % lifted onto its shoulder ({bear_hi:.2f}); "
             "reported, at least half nominal (a ratio)", seen_nom - 0.5, ""),
        ]
    return rows


def fit(row):
    """a row (text, margin[, unit][, doc ...]) as (text, margin, unit, docs): the unit is mm unless the row gives
    one (a string; "" for a ratio). A doc, (group, wording[, value]), puts the row into the table of the main
    margins in docs/architecture/mechanics.md, with its margin or with `value`."""
    text, margin, *more = row
    return text, margin, next((m for m in more if isinstance(m, str)), "mm"), [m for m in more if isinstance(m, tuple)]


# The table of the main margins in docs/architecture/mechanics.md, between these two lines: written from the rows
# that carry a doc, its groups in this order.
FITS_DOC = HERE.parent / "docs" / "architecture" / "mechanics.md"
FITS_MARKS = ("<!-- fits: written by mech/check_fit.py -->", "<!-- /fits -->")
FITS_GROUPS = ("Plate low", "Plate high", "Light pipes", "Caps", "Screws", "Body", "USB-C", "Controls", "Knobs")


def fits_table(rows):
    """the main margins as the lines of a Markdown table: one line per (group, wording) of the rows' docs, the
    margins of the rows that share a wording side by side; three decimals at most, 0.05 mm and less in bold."""
    def show(v, unit):
        if unit == "":                                          # a ratio
            return f"{100 * v:.0f} %"
        txt = f"{v:.3f}".rstrip("0")
        txt += "0" * (2 - len(txt.partition(".")[2])) + ("°" if unit == "°" else "")
        return f"**{txt}**" if unit == "mm" and round(v, 3) <= 0.05 else txt
    table = {}
    for _text, margin, unit, docs in rows:
        for group, wording, *value in docs:
            if group not in FITS_GROUPS:                        # a plain raise: asserts vanish under -O
                raise ValueError(f"no group {group!r} in FITS_GROUPS")
            table.setdefault((group, wording), []).append(show(value[0] if value else margin, unit))
    return ["| Group | Fit | Margin (mm) |", "| --- | --- | --- |",
            *(f"| {g} | {wording} | {', '.join(vals)} |" for group in FITS_GROUPS
              for (g, wording), vals in table.items() if g == group)]


def write_fits_table(rows):
    """puts fits_table() into FITS_DOC between FITS_MARKS."""
    doc = FITS_DOC.read_text()
    head, _, rest = doc.partition(FITS_MARKS[0] + "\n")
    _old, found, tail = rest.partition(FITS_MARKS[1])
    if not found:
        raise SystemExit(f"check_fit.py: no {' ... '.join(FITS_MARKS)} in {FITS_DOC.name}")
    new = head + FITS_MARKS[0] + "\n" + "\n".join(fits_table(rows)) + "\n" + found + tail
    if new != doc:                                              # in one step: a stopped build leaves the page whole
        tmp = FITS_DOC.with_name(FITS_DOC.name + ".tmp")
        tmp.write_text(new)
        os.replace(tmp, FITS_DOC)
    print(f"{FITS_DOC.name}: the table of the main margins, {len(fits_table(rows)) - 2} lines")
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
