saschagrunert/avionics-panel/firmware/panel.py

"""Panel logic of the Avionics Panel rev 1: plain Python, no hardware access, testable on the PC.

code.py feeds it key events, encoder detents and the time in milliseconds, and sends the buttons it
reports. All state (SHIFT, UNIT, frequency mode) lives here and comes out as fixed joystick buttons,
so MobiFlight mappings never need variables or preconditions. See docs/using/controls.md (SHIFT,
Knobs) and docs/architecture/firmware.md.
"""
import buttonmap as BM

SHIFT_MS = 3000          # SHIFT cancels itself, and a shifted knob returns to normal, after this
SHIFT_PULSE_MS = 125     # before SHIFT drops out the amber light pulses, dim and bright this long each (4 Hz) ...
SHIFT_WARN_MS = 8 * SHIFT_PULSE_MS   # ... for this long: whole pairs, so it starts dim and ends bright
LIGHT_OFF, LIGHT_DIM, LIGHT_FULL = 0, 1, 2   # levels of the amber light; code.py maps them to PWM duties
FAST_MS = 60             # detents closer than this (same ring, same direction) take the coarse step
# Every press and every gap must outlast a MobiFlight poll after losing three HID frames, and the bounce window
# must take a bounce one key scan long, with half a scan to spare (docs/architecture/firmware.md, Knob steps and
# Keys and switch bounce).
POLL_MS = 32             # MobiFlight's poll, 31.25 ms rounded up
HID_FRAME_MS = 8         # the host's report interval
LATE_MS = 3 * HID_FRAME_MS                # 24: an edge may reach the PC this late: three frames
KEY_SCAN_MS = 20         # code.py's keypad scan interval: 20 ticks of 1/1024 s, 19.5 ms
BOUNCE_MS = KEY_SCAN_MS * 3 // 2          # 30: a press this soon after its own release (scan times) is a bounce
PRESS_MS = POLL_MS + LATE_MS              # 56: one knob detent = a button held this long, a key or push at least ...
GAP_MS = PRESS_MS                         # ... then released this long before its next one: about 9 steps a second
MAX_QUEUE = 8            # detents waiting, all rings together, and presses owed per button: a fast spin runs
                         # on, and a key waits behind it, for at most about 8 x 112 = 896 ms
REPEAT_DELAY_MS = 400    # UP / DN: first repeat ...
REPEAT_MS = 125          # ... then about 8 per second
PAN_DELAY_MS = 300       # RANGE tilt: first repeat ...
PAN_MS = 120             # ... then this often (both: no faster than the steps go through, see tick())
# RANGE tilt switches -> pan direction: a tilt away closes A, left B, towards the user C, right D (Alps drawing)
PAN_DIRS = {"RANGE_A": "UP", "RANGE_B": "LEFT", "RANGE_C": "DN", "RANGE_D": "RIGHT"}
# The sources that repeat while held, in a fixed order: repeats due in the same pass queue in it (the second one
# may find the queue full), and CircuitPython's dicts keep no insertion order
REPEAT_SOURCES = tuple(sorted(BM.REPEAT_KEYS + tuple(PAN_DIRS)))
# The FREQ knob's modes, in the order its push cycles them: the outer ring's step, the inner ring's and the inner
# ring's coarse step
FREQ_MODES = (("COM_MHZ", "COM_KHZ", None), ("NAV_MHZ", "NAV_KHZ", None), ("ADF_100", "ADF_1", "ADF_10"))


def _has_value(d, value):
    """value in d.values(), without making the view: tick() asks in every pass"""
    for k in d:
        if d[k] == value:
            return True
    return False


class Panel:
    def __init__(self, solo=False):
        """solo: one button down at a time, for the keyboard mode (keys.py): a press waits until no other button
        is down, so each shortcut goes down with its own modifiers and no other key held"""
        self.solo = solo
        self.dark = False            # code.py sets it while USB is down and the lights are off: SHIFT never
                                     # applies, and a held key or tilt does not repeat
        self.shift = None            # None, "any" (armed by the SHIFT key) or the knob that keeps it
        self.under = None            # with "any": the knob whose held push or tilt keeps its session under it
        self.shift_until = 0
        self.unit = 1
        self.freq_mode = 0           # index into FREQ_MODES: kept until the FREQ push changes it
        self.digit = 1               # squawk digit (1 to 4) the shifted FREQ inner ring steps
        self.held = {}               # source -> (device, button) held while the source is held
        self.pending = {}            # key or push -> scan ms of its release, not applied for BOUNCE_MS
        self.shown = {}              # (device, button) -> [down?, ms of its last edge, presses owed]: every
                                     # button the PC sees down, in its gap or still owed a press
        self.order = []              # the owed presses (shown keys), in the order they came: steps and keys
        self.order_ms = 0            # the head of order waits until then: PRESS_MS after the last press sent
        self.repeat = {}             # source -> [(device, button), next_ms, every_ms]
        self.last_detent = {}        # ring -> (ms, direction)
        self.ring_keys = {}          # ring -> shown keys its detents went to since its last reversal
        self.sessions = {}           # source -> knob: a push or tilt held in that knob's shifted session
        self.last_tick = None        # ms of the last tick(): the previous loop pass
        self.range_dirs = set()
        self.range_tilted = False    # a direction closed during this RANGE "com" press

    # ---------------- helpers ----------------
    def _btn(self, dev, name):
        return dev, BM.BUTTON[dev][name]

    def _owe(self, k, n=1):
        """n more presses of button k, behind everything already in order; at most MAX_QUEUE with the one on
        its way"""
        e = self.shown.get(k)
        if e is None:
            e = self.shown[k] = [False, None, 0]
        while n > 0 and e[2] + (e[1] is not None) < MAX_QUEUE:
            e[2] += 1
            self.order.append(k)
            n -= 1
        return k

    def _hold(self, src, k):
        """A key or push goes down: holds k while src is held, and owes the PC one more press of k"""
        self.held[src] = k
        self._owe(k)

    def _queue(self, k, n=1):
        """n detents or repeats of button k, while fewer than MAX_QUEUE presses wait in order, so nothing waits
        behind them for long. Keys, pushes and the first step of a hold are never dropped (_owe)."""
        return self._owe(k, min(n, MAX_QUEUE - len(self.order)))

    def _reverse(self, ring):
        """The ring turned the other way: drop the detents it still has queued in the old direction, so the knob
        stops at once. Only those at the end of order: a key or another ring queued after them came later, and
        the PC must see them first (ENT confirms the character dialled before it). A pulse already on the way
        finishes, the PC has seen its press."""
        keys = self.ring_keys.pop(ring, ())
        while self.order and self.order[-1] in keys:
            self.shown[self.order.pop()][2] -= 1

    def keep_steps(self):
        """The steps queued so far stay: a ring that turns back later no longer drops them. For where something
        came between that ends a turn: a key or push, which may have changed what the ring does (SHIFT, UNIT,
        the FREQ push), and code.py's wait for a host, in which no step could go out."""
        self.ring_keys.clear()

    def stalled(self, ms):
        """The loop waited ms for the host (code.py: a send that waited, a request to resume), so a report
        reached the PC later than the LATE_MS that PRESS_MS and GAP_MS allow for. Every press and gap the PC is
        being shown starts that much later, so one that begins with that report or after it still outlasts a
        poll for the PC, and the next press keeps its distance; the next repeat of a held key or tilt keeps its
        delay. The end of SHIFT moves as well: the light stayed as it was during the wait, and a key pressed
        then goes out as it showed."""
        for k in self.shown:
            if self.shown[k][1] is not None:
                self.shown[k][1] += ms
        for src in self.repeat:
            self.repeat[src][1] += ms
        self.order_ms += ms
        self.shift_until += ms

    def shift_active(self, t):
        """Whether SHIFT applies at time t, the one place that decides it: inputs, tick() and the light agree,
        so a detent read after SHIFT ran out is plain, also before tick() has seen that, and cannot revive the
        session. Never while dark: the light is off then, and dark means plain."""
        return not self.dark and self.shift is not None and t < self.shift_until

    def _expire(self, t):
        """Ends SHIFT once it ran out. A shifted push or tilt still held keeps its session, the 3 s start at its
        release: extended first, so a loop pass that stalled for 3 s or more doesn't end it under the hand."""
        if self._held_session() is not None:
            self.shift_until = t + SHIFT_MS
        if not self.shift_active(t):
            self.shift = self.under = None

    def _kept(self):
        """The knob whose session SHIFT is: the armed "any" keeps the one a held control was in."""
        return self.under if self.shift == "any" else self.shift

    def _held_session(self):
        """The knob whose session a shifted push or tilt still held keeps, or None. Keys never end that
        session, SHIFT taps and the key a tap armed included; another knob does (_knob_shift). A release still
        waiting out BOUNCE_MS counts as held: it may be a bounce (docs/architecture/firmware.md)."""
        knob = self._kept()
        return knob if _has_value(self.sessions, knob) else None

    def _knob_shift(self, knob, t):
        """SHIFT for a knob action: armed SHIFT or this knob's own shifted session. Starts/extends it."""
        if self.shift == "any" and self.under != knob:     # not the session a held push of this knob keeps:
            self.digit = 1                                 # a new one, the squawk entry starts at digit 1
        if self.shift == "any" or self.shift == knob:
            self.shift, self.under = knob, None
            self.shift_until = t + SHIFT_MS
            return True
        self.shift = self.under = None   # another knob ends this session, also one a held push or tilt keeps
        return False
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
