saschagrunert/avionics-panel/(commit log)

2026-11-09 Avionics Panel rev 1
    Desk avionics panel for GA flight sims: autopilot, audio, radio and FMS keys, three dual concentric
    knobs and a tilting RANGE knob on a 4-layer RP2040 board that shows up as two USB joysticks.
    Contains the spec (docs/), the routed and checked board generator, the CNC aluminium front plate,
    printed body, knobs, light pipes and key caps, the CircuitPython firmware with host tests, the 3D
    viewer, renders, the files to order from the JLC group, build.sh, which regenerates and checks
    everything, and GitHub Actions that run it and publish the viewer to GitHub Pages.
    [avionics-panel-rev1-BOM.csv, avionics-panel-rev1-THT-LCSC.csv, avionics-panel-rev1-body.step, avionics-panel-rev1-body.stl, avionics-panel-rev1-caps.obj, avionics-panel-rev1-knob-inner-loose.step, avionics-panel-rev1-knob-inner-loose.stl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]
2026-11-10 Pulse the SHIFT light before SHIFT drops out
    - During the last second before an armed SHIFT or a knob's shifted session times out, the amber light
    pulses at 4 Hz between full and dim instead of switching off: dark means plain, lit means shifted.
    - shift_active(t) is the one check whether SHIFT applies, used by keys, knobs, tick() and the light, so a
    late input after a stalled loop is plain, as the dark light says, and cannot revive an expired session.
    - The warning starts dim exactly one second before the drop and ends bright; check_timing() raises if the
    constants break that or if the warning is not shorter than SHIFT.
    - panel.shift_level(t) returns one of three integer levels; code.p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
    [code.py, panel.py, test_code.py, test_panel.py]
2026-11-10 Add cockpit lighting dimmers behind SHIFT on the FMS knob
    - With SHIFT, the FMS outer ring steps the panel lights, the inner ring the glareshield flood and the push
    toggles the cabin light, one step per detent, on the first joystick in either unit.
    - The new buttons PANEL_LT_UP/DN, FLOOD_LT_UP/DN and CABIN_LT go at the end of device 1, and the retired
    S_FMS_* buttons keep their slots, so no existing button number moves.
    - The docs describe the lighting, what a stray SHIFT before the FMS knob does and how to undo it, and the
    3 s after dimming before the knob pages again; a new test covers both rings, the push, a fast turn and
    the unit independence. The plate legend is in the knob lege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
2026-11-10 Make the knob legends consistent and swap IDENT and VFR
    - Every knob legend now reads "what the rings do, outer ring first, then PUSH and what the push does",
    all in one type size: the frequency knob becomes FREQ · PUSH COM/NAV/ADF, and the FMS knob gets the
    amber lighting legend PANEL · FLOOD · PUSH CABIN for the dimmers from the previous change.
    - Key and knob legends and the legend tilt per knob live in stack.py, the one source for the caps, the
    plate, the board silkscreen and the 3D view; the FMS legends sit at 5 degrees so the lighting line keeps
    about 3 mm off the plate edge. tests/test_labels.py checks the firmware button map against it.
    - The IDENT key becomes VFR with IDE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
    [avionics-panel-rev1-plate.dxf]
2026-11-10 Fix firmware, tooling and docs findings from the project review
    - Firmware: buttonmap.py compiles on MicroPython again (no starred list
    items), button numbers are renumbered once and frozen (VFR 17, IDENT 34,
    PAN_DN, a snapshot test keeps them), reports wait for USB and are resent
    after a reconnect. After a keypad overflow, keys still held stay held and
    only keys whose release was lost are released, per keypad.
    - BUTTONS.md: written by make_buttons.py, which stays on the PC, with a
    how-to and a control column.
    - Tests: MicroPython compile test, knob push legends checked by pushing
    each knob, USB and overflow tests against a keypad stub that rescans.
    - Tooling: build.sh rejects un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
    [avionics-panel-rev1-plate.dxf]
2026-11-10 Rework the rev 1 mechanics before ordering
    - Plate: 4.0 +-0.1 mm 6061 at z 6..10, top unchanged; M2.5 threads milled in 3.2 +0/-0.1 mm flat-bottom
    holes, full thread from 0.1 to at least 2.6 mm, 0.7 mm left in front of the thinnest plate; pockets 2.8
    and 3.2 mm +0/-0.1; positions +-0.1 on the drawing.
    - Screws: M2.5 x 12 pan heads, shimmed to fit with DIN 125 M3 washers (one under every head, up to three
    more); at least 2.4 full turns engage in any stack, with the screw stopping at the thread end or the
    floor and the incomplete screw end counted. The counterbore keeps the washer over the body hole.
    - Alignment: the key caps centre the board in the 10.2 x 7.0 key holes; 4.2 mm PCB hol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
    [avionics-panel-rev1-body.step, avionics-panel-rev1-body.stl, avionics-panel-rev1-caps.obj, avionics-panel-rev1-knob-inner-loose.step, avionics-panel-rev1-knob-inner-loose.stl, avionics-panel-rev1-knob-inner-tight.step, avionics-panel-rev1-knob-inner-tight.stl, avionics-panel-rev1-knob-inner.step]
2026-11-10 Decouple 1V1 at the pins and keep vias out of pads
    - board.py: C_D2 stays next to RP2040 pins 42-44 with a direct trace from pin 42; beside it two 0402
    capacitors hang off VREG_VOUT (pin 45), C_1V0 (1 uF) and C_1V2 (100 nF), and C_1V1 sits right below DVDD
    (pin 50), all on parametric pre-routed copper, each capacitor with its own GND via. Pin 23 joins over the
    top layer through V23, V45 and V50. The flash moves down 1 mm, R_DP/R_DM turn horizontal below the corner
    and the USB-C lines land on vias just below them; GP13 leaves its fan-out on the top layer. The 1V1 test
    vias are tented on the bottom. part() records each footprint for the BOM through one chip() helper.
    - route.py keeps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
    [avionics-panel-rev1-BOM.csv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]
2026-11-10 Give the dual knobs Garmin proportions
    - Outer rings 17 mm on all three dual encoders (were 22, 22 and 24), inner knobs 12 mm (were 13), so 2.5 mm
    of ring shows each side; one knob-outer file with its fit variants replaces outer-22 and outer-24.
    - Outer neck 8.3 mm (1.15 mm wall round the 6 mm bore, 1.1 on the loose variant), inner recess 9.2 mm
    (0.45 mm round the neck, 0.1 with resin tolerances and bore play, 1.0 mm left at the inner knob's flute
    bottoms); knob heights and fits stay.
    - check_fit.py checks the neck to recess clearance, both resin walls, the counterbore wall and the ring
    width; flute parameters move to constants in make_knobs.py.
    - Knob legend tilts 20 (ALT/HDG, FMS)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
    [avionics-panel-rev1-knob-inner-loose.step, avionics-panel-rev1-knob-inner-loose.stl, avionics-panel-rev1-knob-inner-tight.step, avionics-panel-rev1-knob-inner-tight.stl, avionics-panel-rev1-knob-inner.step, avionics-panel-rev1-knob-inner.stl, avionics-panel-rev1-knob-outer-22-loose.step, avionics-panel-rev1-knob-outer-22-loose.stl]
2026-11-10 Fix the final pre-order findings across board, mechanics and firmware
    - Board: crystal Y1 on its real electrode pads (XIN and XO_R sat on its GND pins), CPL rotations in
    JLC's bottom-side convention with pin-1 dots for U2, U3 and Y1, RKJXT ground terminal and locating
    hole per the Alps drawing, encoder lugs on GND, SHIFT and UNIT LEDs 0.3 mm away from their key holes
    (0.85 mm plate webs), 3.0 mm mounting holes for the glued standoffs. Re-routed with seed 3 (GP15 86
    instead of 341 mm).
    - check.py: JLC footprints (stored offline in pcb/footprints) fitted on every bottom-side part at its
    CPL rotation, net detours, USB length and skew, copper keep-out round the mounting holes; one DXF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
    [avionics-panel-rev1-body.step, avionics-panel-rev1-body.stl, avionics-panel-rev1-caps.obj, avionics-panel-rev1-knob-inner-loose.step, avionics-panel-rev1-knob-inner-loose.stl, avionics-panel-rev1-knob-inner-tight.step, avionics-panel-rev1-knob-inner-tight.stl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]
2026-11-10 Fix the second pre-order findings across board, mechanics and firmware
    - Board: C_D2 is 1 uF at VREG_VIN (C_VIN becomes the 3V3 bulk capacitor C_BULK); the LED series resistors
    move beside the LEDs so no hand-soldered pad has another net within 1.0 mm; 10 k pull-ups on the seven
    matrix columns; RKJXT holes 1.1 mm (one thermal spoke left out next to a foreign hole); the LED
    resistors sit 0.55 mm from the anode pad (same net, so a bridge or remelt is harmless).
    - check.py: at least 1 uF at pins 44 and 45, hand-soldering clearance, JLC footprints for the
    through-hole parts.
    - Mechanics: USB-C opening 15.8 x 8.4 carried up as a notch through the back wall (MJF position tolerance
    counte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
    [avionics-panel-rev1-BOM.csv, avionics-panel-rev1-body.step, avionics-panel-rev1-body.stl, avionics-panel-rev1-knob-range-loose.step, avionics-panel-rev1-knob-range-loose.stl, avionics-panel-rev1-knob-range-tight.step, avionics-panel-rev1-knob-range-tight.stl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]
2026-11-11 Offer full JLCPCB assembly and fold status.md into the docs
    - Add a full assembly variant (JLCPCB Standard, both sides, through-hole parts included): make_bom.py
    writes BOM-full.csv and CPL-full.csv, one BOM and one CPL with the side in the Layer column
    - board.py records the top-side CPL of each through-hole part in JLC's top convention (white LED at
    180, encoder origin 1 mm north of the shaft); check.py fits JLC's footprint at that position and
    rotation onto our holes pin by pin, so a wrong rotation or origin fails the build
    - ordering.md sets both variants side by side: JLC part numbers and stock, what to do if the encoders
    run short, the order remark for seating the parts and sol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
    [avionics-panel-rev1-BOM-full.csv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]
2026-11-11 Fix the third pre-order findings across board, mechanics and firmware
    - Board: C_IN moves west of U3 (no body overlap, VBUS clear of J1's
    hand-soldered shell tabs) and C_FL sits clear of the flash; a bottom
    keep-out over the whole USB-C shell moves GP18/20/21 off it (new routing
    seed 11); precheck.py checks part bodies, check.py checks the J1 shell,
    the shell tabs' hand-soldering clearance and legend clearance; U3 pads
    lengthened, legends 1 mm tall and 0.3 mm inside the edge, "K" marks at
    the LED cathodes; manufacturing asserts are real errors; LCSC LEDs
    ordered at their minimum of 20.
    - Mechanics: encoder pocket 15.6 wide with a lug row and a floor corner
    limit; part seating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
    [avionics-panel-rev1-THT-LCSC.csv, avionics-panel-rev1-body.step, avionics-panel-rev1-body.stl, avionics-panel-rev1-knob-inner-loose.step, avionics-panel-rev1-knob-inner-loose.stl, avionics-panel-rev1-knob-inner-tight.step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]
2026-11-11 Pin nixpkgs and run the build in parallel
    - Lock nixpkgs in flake.lock (the revision that built main), read
    without flakes by nix/nixpkgs.nix for build.sh and the lint jobs;
    nix/shells.nix defines the build's environments from it.
    - Let Dependabot propose nixpkgs-unstable updates; their pull requests
    run the strict output check, which replaces the weekly run.
    - Key the CI Nix store cache on flake.lock and the Nix files, so pull
    requests restore MicroPython instead of building it.
    - Fail the check on any changed output, now that nixpkgs is locked.
    - Rename the build job to "check".
    - Run the independent build.sh sections in parallel, each in a process
    group of its own (Ctrl-C, Ctrl-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
    [avionics-panel-rev1-body.step, avionics-panel-rev1-knob-inner-loose.step, avionics-panel-rev1-knob-inner-tight.step, avionics-panel-rev1-knob-inner.step, avionics-panel-rev1-knob-outer-fms-loose.step, avionics-panel-rev1-knob-outer-fms-tight.step, avionics-panel-rev1-knob-outer-fms.step, avionics-panel-rev1-knob-outer-loose.step]
2026-11-11 Order the board black and close the USB-C notch
    - Board: black solder mask with the white legend. Black needs 0.13 mm
    mask dams at JLCPCB instead of 0.10, so every opening is now its pad
    plus 0.035 mm per side instead of 0.05; check.py enforces the black
    dam minimum and that every pad is open on exactly its layers (the
    fan-out and USB routing points stay covered), clear of the copper by
    0.025 to 0.05 mm. The order confirms the production file and asks
    JLCPCB to keep the 64 dams at exactly 0.13 mm, green as the fallback.
    - USB-C: a new MJF filler (usb-filler.step/.stl) closes the notch above
    the plug opening. The notch is 2.5 mm wider than the opening on each
    side above two le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
    [avionics-panel-rev1-body.step, avionics-panel-rev1-body.stl, avionics-panel-rev1-usb-filler.step, avionics-panel-rev1-usb-filler.stl]
2026-11-11 Add USB protection and per-pin IOVDD decoupling
    - U4, an SRV05-4 ESD array (C7420376, preferred extended), right
    behind J1: D+ and D- run through it in line
    - R_IN (1 ohm, basic) and F1, a 0.5 A Bourns PTC fuse (C75464), in
    VBUS ahead of every load, U4's VCC clamp included; C_IN on the
    fused side, now 10 uF; R_IN damps the hot-plug ringing on C_IN so
    the modelled input stays at the 5.25 V step
    - A 100 nF 0402 of its own at IOVDD pins 1, 10, 22 and 49 (with
    USB_VDD); pin 33 stays an exception, C_1V1 and R_CC2 move to 0402,
    C_D0 goes
    - check.py: ESD array in line and within 5 mm of J1, R_IN and the fuse
    in line ahead of every load, one surface-copper capacitor per IOVDD
    pin, an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
    [avionics-panel-rev1-BOM-full.csv, avionics-panel-rev1-BOM.csv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]
2026-11-11 Fasten the plate with tapped bosses and drop glue and washers
    - Plate: milled from 12 mm 6061 with four Ø5.5 bosses, 6.05 +-0.05
    high, tapped M3-6H (6.0 full thread, drilled 7.5). Drawing and
    JLCCNC remark carry stock, threads after anodising, flatness and
    sharp light-hole back edges; the drawing's text block is laid out
    from its own height and the build fails on text off the page, on
    a label, labels overlapping or a plan view under 0.45 of the page.
    - Screws: M3 x 8 ISO 7380-2 flanged button heads (JLCMC EDDH), no
    washers. Body hole 4.2, PCB holes 3.8, counterbore as a co-stop.
    - Body walls 0.65 under the plate (was 0.95).
    - Lights: reverse-mount LiteOn LEDs (C125108 amber, C57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
    [avionics-panel-rev1-BOM-full.csv, avionics-panel-rev1-BOM.csv, avionics-panel-rev1-THT-LCSC.csv, avionics-panel-rev1-body.step, avionics-panel-rev1-body.stl, avionics-panel-rev1-lightpipes.step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]
2026-11-11 Make full assembly the default and drop checks the margins cover
    - Ordering: full JLCPCB assembly is the default, hand-soldering an
    option. One short JLCPCB remark per variant (rail, seating, J1 tabs,
    mask dams, R0.5 LED cutout corners), board options at JLC's defaults
    bar layers, ENIG, black mask and Tented vias, a JLCCNC remark that
    points to the drawing and asks for the boss height +-0.05, threads
    masked or cut after anodising and flatness 0.1, review watch items cut
    to the ones that need an answer, tools without calipers, side cutters
    and the iron (economic option or rework only).
    - Mechanics and firmware bring-up follow the full default; arrival
    checks without the width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
    [check_fit.py, make_plate_step.py, stack.py]
2026-11-11 Restructure the docs into using, building and architecture
    - README: a short intro, then a build guide (what to order from which
    shop with which files, what arrives, arrival checks, bring-up,
    assembly, mapping) with links into the three doc groups
    - docs/using: controls, compatibility and a new mapping.md with the
    user-facing parts of the firmware doc
    - docs/building: building.md (ordering, slimmed, with a shopping
    list), assembly.md (arrival checks, hand-soldering, assembly,
    disassembly) and bring-up.md (install, bring-up, Pico bench)
    - docs/architecture: electronics, firmware internals and mechanics
    design; the schematic PDF moves there, build.sh copies it there
    - Drop issue li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
    [board.py, boot.py, check.py, check_fit.py, code.py, make.py, make_bom.py, make_mech.py]
2026-11-12 Fix held repeats, lone releases and squawk entry in the firmware
    - A held UP, DN or RANGE tilt queues its next repeat only once the last
    step of its button is through, so nothing runs on after the release;
    drop the REPEAT_MS / PAN_MS timing rule
    - The frequency mode is sticky: only the FREQ push changes it
    - A release of a key the panel never saw pressed (held while the keypad
    started) is ignored, so the RANGE centre sends no PTR for it
    - Squawk entry: the shifted FREQ outer ring selects the digit (1 to 4,
    digit 1 in a new session), the inner ring steps it once per detent;
    the eight SQK buttons keep their numbers
    - Tests for the RANGE left and down tilts, a centre press, and UNIT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
    [buttonmap.py, code.py, make_buttons.py, panel.py, test_code.py, test_panel.py]
2026-11-12 Remove dead code, dead outputs and duplicate checks
    - build.sh: plain background jobs with a log each instead of the
    hand-written job runner. The sections' outputs are printed in the
    order they are listed (firmware first), an interrupt ends the
    sections and exits 1, and the per-section times are gone.
    - CI: one lint job with one Nix shell and cache, one step per tool.
    - pcb: drop dbg.py, design.json, silk.pkl, the raster dumps, the pin
    order and position-only through-hole checks, the NEAR MOUNT rule and
    unused router and Gerber writer branches; share the pair loop, the
    union-find and the path helper.
    - mech: stop writing the knob, light pipe and plate STLs, the drawing
    PNG and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
    [avionics-panel-rev1-knob-inner-loose.stl, avionics-panel-rev1-knob-inner-tight.stl, avionics-panel-rev1-knob-inner.stl, avionics-panel-rev1-knob-outer-fms-loose.stl, avionics-panel-rev1-knob-outer-fms-tight.stl, avionics-panel-rev1-knob-outer-fms.stl, avionics-panel-rev1-knob-outer-loose.stl, avionics-panel-rev1-knob-outer-tight.stl]
2026-11-12 Fix the viewer's framing, rendering and usability problems
    - Fit every view to the window's aspect ratio, so a portrait phone
    shows the whole panel; the stills keep their framing.
    - Upload the canvas textures without alpha: no transparent hairline on
    the plate.
    - Let the depth range follow the camera, sized from the model: no
    z-fighting in the plan still, no polygon offsets; end the outer
    encoder shaft under the knob's top.
    - Limit the zoom, keep the pan target on a part, land exactly on a view
    after a pan, follow hash changes without a reload.
    - Draw frames on demand, also after a restored WebGL context; ignore a
    window without a size.
    - With reduced motion the view buttons did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
2026-11-12 Measure the firmware's test coverage and send it to Codecov
    - build.sh runs the firmware tests with pytest-cov (added to the
    firmware Nix shell), prints the coverage table with the uncovered
    lines and writes coverage.xml; .coveragerc limits it to the files
    that go on the board
    - CI uploads coverage.xml with the Codecov action; a failed or
    stalled upload does not fail the build, and an upload tool whose
    signature does not verify is not run
    - codecov.yml gives Codecov's checks slack: the project may drop by
    2 %, changed lines need 80 %
    - README.md shows the coverage badge
2026-11-12 Restructure the docs into ordering, bring-up and assembly
    - Move the build overview to docs/building/README.md and the script
    and seed lists to docs/architecture/generators.md; the main README
    keeps the pitch, a short "Build one" and the docs index.
    - README: link the avionics and MobiFlight; the picture opens the 3D
    view, with the renders and the resources (plate artwork and
    drawing, fit check, schematic) in centred lines under it; say that
    the JLC group is a suggestion; drop the licence section (LICENSE
    has it).
    - Rename building.md to ordering.md and move the arrival checks and
    the cap set choice into bring-up.md; assembly.md ends with the
    hand-soldering section.
    - Make JL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
2026-11-12 Simplify the docs and unify their terms
    Split the longest steps and paragraphs into lists and short tables
    (bring-up steps 1 and 5 to 7, the knob timing check, the Pico bench
    parts, the workflows and legend notes, the USB protection, decoupling
    and matrix sections, the review and tax notes), cut repeated facts down
    to a link and drop derivations a reader does not redo. Correct the
    bring-up probe point at R_DP and say where the part is. Use one
    spelling for the FREQ knob, device 2 and the body, the degree sign and
    the micro sign, part values as the BOM names them, and put what is
    typed or read literally in code font.
2026-11-12 Add a fifth screw, a plate tongue and headroom in the hardware pass
    - Board: a fifth mounting hole in the middle of the key field, the
    UNIT LED 1.2 mm further east and mirrored, 47 ohm for the white LED,
    routing seed 8. run_route.py drops the two shuffles of the first
    pass's net order (the shuffle of the east-side nets for seeds from
    2 stays) and dead code, and writes routed.json only for a routed
    board. The checks cover the mount keep-outs before routing, the
    copper Gerbers against the pad model, the drill, outline and silk
    files against the model, the drill sizes against JLC's footprints
    and the polarity from stored pin names.
    - Plate: 0.5 mm higher on five bosses with one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
    [avionics-panel-rev1-BOM-full.csv, avionics-panel-rev1-BOM.csv, avionics-panel-rev1-body.step, avionics-panel-rev1-body.stl, avionics-panel-rev1-knob-inner-loose.step, avionics-panel-rev1-knob-inner-tight.step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]
2026-11-12 Check the spelling with typos in the lint job
    The lint job runs typos from the locked nixpkgs as one more step, on
    the tree and on .github, which typos skips as a hidden directory.
    .typos.toml leaves out the vendored three.js and the generated files
    in production/ and lists the terms of the trade and the names in the
    code that typos reads as misspellings (THT, HSI, VOR, iy, metalness
    and a few more). check.py's planed becomes on_plane, so it needs no
    entry. The tree has no finding with it.
    [check.py]
2026-11-12 Bring the docs in line with the hardware pass
    - Building pages: five screws, the plate's tongue in place of the
    USB-C filler, the body centred by eye, no seating checks and no
    steel plate. One table of JLC3DP files and quantities, the remarks
    to JLCPCB, JLCCNC and JLC3DP rewritten, the review questions as a
    table, the edge rail facts once.
    - Mechanics: rewritten round a stack table, a short section per
    topic, a table of the main fits with their margins and the
    assumptions the fit rows rest on. The tolerance arithmetic stays in
    stack.py and check_fit.py.
    - Electronics: 47 ohm for the white LED with its currents, the
    mirrored UNIT LED, tables for the check limits, the drills, t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
2026-11-12 Test the firmware's last uncovered lines
    Cover the four lines the coverage report still listed as missing:
    memorymap refusing the pad registers (code.py says so for each pad
    and runs on, the lights still follow SHIFT and UNIT), two keys tapped
    together, which are released and forgotten in the same tick, and a
    turn of no detents, which sends nothing and leaves SHIFT armed. The
    files that go on the board are now fully covered.
    [test_code.py, test_panel.py]
2026-11-12 Order the hand-soldering variant as Standard assembly
    JLCPCB offers no Economic assembly for a black board with ENIG, so the
    hand-soldering variant becomes a Standard order of the bottom side with
    the same edge rail as full assembly. The part classes and the fee text,
    which only applied to Economic assembly, go with it, and JLC3DP always
    ships on its own to stay under the €150 line.
2026-11-12 Give the viewer one source for its numbers and a Bottom view
    - stack.py holds the key frame, the group titles, the knob and cap
    legends' layout, the plate's letter spacing, the direct-to arrow,
    the RANGE skirt's cone and the USB-C opening's depth; the generators
    and geometry.js read them
    - geometry.js carries the board's pads and part bodies, written with a
    list of plain values on one line; every key is read by the page, and
    a missing one stops the page with its name in the console
    - the page draws the caps' corner radius, the RKJXT's octagon, the
    plate's edge break, the RANGE skirt's rim and dish, the screw's
    flange rim, and open counterbores and the BOOT hole in the body
    - a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
    [check_fit.py, make_caps.py, make_knobs.py, make_mech.py, make_plate_art.py, make_viewer_data.py, stack.py]
2026-11-12 Shorten the USB protection section
    Put the parts and the limits into tables, state the hot-plug model's
    results together with its assumptions, and keep each fact in one place
    between the doc and the comment at C_IN in board.py. The bring-up step
    that measures the fuse names its two nets, VBUS_R and VBUS_F.
    [board.py]
2026-11-12 Trim the electronics page
    Shorten the sections a reader uses to understand, debug or change the
    board: tables for the decoupling pins and rules and the LED data, one
    line per placement and legend rule, and a pointer to the code comment
    that holds each derivation.
2026-11-12 Run the firmware in a simulator and test the documented workflows
    - sim/: stand-ins for the hardware modules boot.py and code.py use,
    imported in those files only, on virtual time (20 ms key scans,
    3 ms loop passes, 8 ms host polls), and a Sim that runs the
    unchanged firmware from a pilot's actions by the firmware's input
    names and reads what MobiFlight sees and the lights
    - firmware/test_code.py, test_boot.py and tests/test_pins.py use these
    stand-ins instead of their own
    - tests/test_workflows.py: the workflows, keys and knobs of
    controls.md, each checking that nothing stays pressed;
    tests/test_sim.py: the simulator's own checks
    - code.py: correct the comments on keypad reset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
    [code.py, hardware.py, test_boot.py, test_code.py, test_pins.py, test_sim.py, test_workflows.py]
2026-11-12 Check the uploaded files and the solids as built
    - check.py reads the BOM and CPL make_bom.py wrote (now run before
    it): JLCPCB's headers, every part of board.py on its side with its
    Comment, LCSC and Quantity, the hand-soldering files the bottom side
    of the full ones; both footprint fits take place, side and rotation
    from the CPL and fail unless they fit every part of their side
    - One board-to-plate transform in stack.py for the plate STEP and the
    DXF; check_fit measures every CUT hole of the DXF on the plate,
    matches their count with the plate's through holes, and the tongue's
    outer face against the DXF outline
    - check_fit measures the key, encoder and RANGE holes, the caps'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
    [board.py, check.py, check_fit.py, make_caps.py, make_knobs.py, make_mech.py, make_plate_art.py, make_plate_step.py]
2026-11-12 Fix and tighten the building docs
    - Ordering: diode rule by bottom-side landmarks, the encoder fallback
    (one BOM line, 26 lines, three per board), short parts, unlisted
    review questions; drop LCSC home items, rework shipping
    - Bring-up: faults on both boards, continuity criterion, 3V3 range,
    board orientation, cap set reprint, Linux sync and hid-recorder
    - Assembly: which cap on which key, front and back edges, FIT reprint
    for knobs, what a RANGE bridge shows
    - Mapping: point the Linux button check at hid-recorder
    - Architecture: drop design history; build.sh needs Nix, WSL 2
    - Gloss abbreviations once per page; board, not PCB, in links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
2026-11-12 Run the simulator live and feed a uhid joystick
    - sim/live.py: code.py on the same Board in a thread of its own,
    paced to the wall clock; actions queued by input names, reports to
    an output, the lights readable, a firmware error that reloads as on
    the board, and anything else that ends the run raised to callers
    - sim/uhid.py: one uhid device with boot.py's descriptor, name and
    IDs, fed with every report and answering report requests;
    python3 -m sim.uhid reads actions from stdin
    - hardware.py: hand() and take() seams, bounded records for live runs
    - Tests for the live runner, boot.py's descriptor parsed with
    hid-tools against the simulator's reports, and uhid smoke tests
    where /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
    [hardware.py, live.py, test_descriptor.py, test_live.py, test_sim.py, test_uhid.py, uhid.py]
2026-11-12 Put the circuit first on the electronics page
    Order the sections as circuit (GPIO map, USB protection, crystal,
    decoupling, lights), then layout (placement and legend, routing), then
    manufacturing (solder mask, through-hole parts, assembly data), and
    spell out ECN in the USB protection section.
2026-11-12 Send knob steps in order and mix in coarse steps when fine ones lag
    - Send every press, steps and keys alike, through one queue in the
    order it came, at most one new press every 56 ms
    - Keep at most 8 detents waiting across all rings, so a key waits
    under about 0.9 s; keys and the first step of a hold are kept
    - On reversal drop only the ring's steps at the end of the queue
    - Take the coarse step while a fine step waits and the ring turns
    faster than its steps go out
    - Derive the plain key buttons from PLAIN_KEYS and drop range_com
    - Document the queue, acceleration, GTN tuning, unit 2 mapping, the
    frequency mode and SHIFT during a squawk entry
    - Name squawk digits, tilt directions a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
    [buttonmap.py, make_buttons.py, panel.py, test_panel.py, test_workflows.py]
2026-11-12 Simplify the build, the shells and small duplicates
    - Drop the MicroPython compile check; CircuitPython's mpy-cross moves
    to nix/ and into the firmware shell, which requires it where pinned
    and warns elsewhere; hid-tools only on Linux, so it evaluates on macOS
    - Merge the gen and occ shells into one Python environment
    - Export the cap legend em and every cap's tactile-bar edge (stack.py)
    to the viewer instead of sizing and listing them twice; the plan view
    differs in 4 pixels by one or two levels; renders 1 to 4 are not
    redone
    - Inline mech/dxf.py, reuse geom.rounded_rect, fold SHIFT_X into
    board.py's numbers, one __file__ path form in mech/
    - SILK_EDGE once in geom.py; one face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
2026-11-12 Check the cap bars and the plate's corner radii as built
    - Check each set's tactile bars on the generated caps: the edge, how
    proud, and the top face against CAP_BAR's width, depth and inset
    - Fit the corner radii of the key holes and the outline, in the DXF's
    CUT layer and to the plate mesh's vertices, against stack.py
    - Name the caps' print layout once (stack.CAP_LAYOUT) and read every
    cap of a set from its OBJ (set_caps)
2026-11-12 Generate a MobiFlight profile for the G1000
    - mobiflight/ writes a MobiFlight 11 project (.mfproj) for both
    joysticks from one table per avionics family, the joysticks read
    from a project saved in MobiFlight or given by their serials
    - The tables name HubHop presets; their codes come from HubHop's
    database, which the user downloads (HubHop's data is not stored)
    - The G1000 NXi in MSFS 2024 is the first family
    - Tests check the tables against buttonmap.py and BUTTONS.md, the
    project format, a failed download and documented workflows
    through the simulator
    - A workflow of its own checks the preset names against a fresh
    HubHop download, weekly and when the generator changes
    - The map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
    [test_mobiflight.py]
2026-11-12 Play the panel in the browser through the simulator
    - sim/page.py: python3 -m sim.page runs the live panel and serves the
    3D view, with press, release and turn actions and one event stream
    - viewer/sim.js: with ?sim a fixed top view plays: keys, knob wheel,
    push, touch turning and tapping, RANGE tilt, lights and joysticks
    - Only the server's own page drives the panel, and none may frame it;
    a page that closes, stops posting or loses a request releases what
    only it held; --uhid also feeds the uhid device
    - sim/live.py: a switch changes 50 ms after its last change at the
    soonest, and one action parser for sim.uhid and the page
    - key_name moves to sim/ for the page's name table and th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
    [live.py, page.py, test_labels.py, test_live.py, test_page.py, uhid.py]
2026-11-12 Feed vJoy from the simulator and build a Windows zip
    - sim/vjoy.py: ctypes wrapper for vJoyInterface.dll 2.2.2.0 with
    JOYSTICK_POSITION_V3 as its header defines it, one UpdateVJD per
    report, buttons released also when the console window closes;
    python -m sim.vjoy and sim.page --vjoy (--open opens the page)
    - sim/live.py: the stdin loop of sim.uhid and sim.vjoy, shared
    - windows/: make_zip.py packs Python's embeddable package (pinned
    by hash), the license, firmware/, sim/, viewer/, start.bat,
    vjoy-setup.bat and README.txt; the windows workflow builds it and
    attaches it to releases
    - Tests for the struct, every button of both devices, the DLL calls
    and the console handler against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
2026-11-12 Generate MobiFlight profiles for the GNS and GTN with the KAP 140
    - Add tables for MSFS 2024: the GNS 530/430 in the KAP 140 cockpit,
    which also fits KX 155/165 radios, and TDS's GTN 750Xi with a 650Xi
    - Share the sim's radios, ADF and transponder, tuned directly, and the
    KAP 140 cockpit between the tables; the G1000 profile is unchanged
    - Print the unmapped buttons grouped by reason; the download names
    each family HubHop broke and still fails
    - Run the table, command line and radio tests for every family; check
    knob rings, numbered buttons, releases of held keys and that units
    share only the ADF
    - Give each family a short section in the mapping docs; the FREQ
    advice and the GTN'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
    [test_mobiflight.py]
2026-11-12 Write the MobiFlight codes ourselves, publish them and add the G3X
    - HubHop's terms forbid redistributing its presets, so the family
    tables carry MobiFlight calculator code, written from the MSFS
    2024 SDK, Working Title's G1000 NXi, GNS and G3X Touch sources,
    the sim's KAP 140 and the variables of TDS's GTN bezels
    - Add the GFC 500 and G3X Touch table, with its section in the
    mapping docs
    - The projects send each code without a PresetId; without --from or
    --serials both joysticks are "Avionics Panel" with a serial per
    device, so MobiFlight asks once for the binding
    - G1000: MAP is unmapped, as the NXi takes no long CLR press from
    outside; the audio keys send the sim's key event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
2026-11-12 Add a keyboard mode for consoles and use without MobiFlight
    - HOME (UNIT) held at plug-in switches between the joysticks and one
    boot keyboard; the mode is kept in microcontroller.nvm
    - keys.py holds the descriptor, a frozen shortcut per function on F1
    to F12, navigation keys and arrows with left and right Ctrl and
    Shift, and the report with the modifiers around the key; code.py
    imports it in keyboard mode only
    - One shortcut at a time through the same queue; the lights take
    turns at each start in keyboard mode
    - KEYS.md lists the shortcuts and the shorter ones each contains,
    generated next to BUTTONS.md
    - The simulator runs the mode: a uhid keyboard on Linux, SendInput
    on Wind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
    [boot.py, code.py, hardware.py, keys.py, live.py, make_keys.py, page.py, panel.py]
2026-11-13 Fix the findings of the hardware analysis
    - Board: the router no longer ends a path just touching its seed,
    which left the FMS push open on GP0; check.py reads the copper as
    exact geometry, erodes it and fails on contacts under 0.08 mm
    - Board: R_GP25 (1 k) limits the status LED's drive into the FREQ
    encoder; the UNIT light runs from VBUS_F through a 2N7002, so its
    brightness hardly depends on the LED's voltage bin
    - Board: 0.5 mm GND vias beside USB D-, one via for two, mask strips
    of at least 0.13 mm, no plane slivers, wider legend strokes, Gerber
    polarity attributes, J1's shell ring; re-routed with seed 1
    - Mechanics: the USB opening and tongue take spec-maximum Type-C
    plugs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
    [avionics-panel-rev1-BOM-full.csv, avionics-panel-rev1-BOM.csv, avionics-panel-rev1-body.step, avionics-panel-rev1-body.stl, avionics-panel-rev1-knob-outer-fms-loose.step, avionics-panel-rev1-knob-outer-fms-tight.step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]
2026-11-13 Fix the findings in the simulator, the viewer, the build and CI
    - CI: the zip, the profiles and the release jobs join the build
    workflow and publish only after the build and the new Windows
    tests; the kernel HID tests run, lint uses a lint shell, zizmor
    asks GitHub too, nixpkgs updates come monthly
    - Page server: a browser always gets the files this program serves,
    a stalled request ends after 10 s, a taken port is named, and
    hello carries the numbers the page had copies of
    - Page and viewer: no AbortSignal.timeout or newer operators, the
    banner takes no taps, a hand over what can be operated, view
    changes by the clock, links to the repository and the zip, frosted
    light pipes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
    [live.py, page.py, sendinput.py, test_descriptor.py, test_page.py]
2026-11-13 Fix lost knob steps, SHIFT with USB down and other firmware faults
    - Knobs and keys: a step back after SHIFT, UNIT or a FREQ push keeps
    the steps before it, code.py waits for a ring that starts between
    two detents, and SHIFT is scanned first
    - USB: SHIFT ends with the lights while USB is down; reports that
    met a suspend, a re-enumeration or a slow host go out again and
    last their time; input and releases around a suspend ask the host
    to resume; a reload releases every button
    - Keyboard mode: each report follows from the one the host has, and
    the mode follows boot.py's devices
    - The loop's clock is a small integer and its buffers are made once;
    the stand-ins follow CircuitPython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
    [boot.py, code.py, hardware.py, keys.py, make_keys.py, panel.py, test_code.py, test_keys.py]
2026-11-13 Send TDS's key events to the GTN and tidy the profiles and user docs
    - GTN: the bezel takes the GPS key events TDS's manual documents,
    with the unit's value and a key's down and up, not L: variables
    - G1000: the fast CRS step sets 10 degrees on what the CDI shows, as
    on the G3X; in every family the XPDR mode push switches between
    standby and ALT and STD names altimeter 1
    - --vfr sets the squawk of the VFR key in place of the tables' 1200
    - Tests: codes run on a small RPN evaluator, with one test for each
    that reads a variable; no two functions send the same code; what
    every function sets is listed with its events and values (the
    spell check takes NAV 2's events for that); a code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
2026-11-13 Tighten the checks, order five knob bores, rework the builder docs
    - Board: 2.2 x 2.6 mm LED cutouts, three fiducials, legends sized
    from their measured strokes; no track, via or pad moves and
    routed.json is unchanged
    - check.py: part values, the RP2040's pins, pin-1 marks and tighter
    footprint tolerances against JLC's data; JLCPCB's floors on the
    exact copper
    - Knobs: five bores per type, 0.1 mm apart, numbered by dimples; the
    relief bores follow them, and the drilling fallback goes
    - check_fit.py: more rows, and it writes the fits table of
    mechanics.md; a light pipe's base now has to cover 80 % of the LED
    die, not all of it (91 % at the worst stack)
    - Plate: plate.pdf shows t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
    [avionics-panel-rev1-body.stl, avionics-panel-rev1-knob-inner-1.step, avionics-panel-rev1-knob-inner-2.step, avionics-panel-rev1-knob-inner-3.step, avionics-panel-rev1-knob-inner-4.step, avionics-panel-rev1-knob-inner-5.step, avionics-panel-rev1-knob-outer-1.step, avionics-panel-rev1-knob-outer-2.step]
2026-11-13 Build the G1000 profile on the NXi's inputs and tidy the user docs
    - G1000: the autopilot keys and ALT/HDG knob send the sim's autopilot
    key events, shared with the G3X; CRS, BARO and RANGE send the H:
    events the NXi takes; CDI cycles GPS, NAV 1 and NAV 2 and the fast
    CRS step follows the NXi's CDI source; OBS is mapped
    - KAP 140 cockpit: CRS CTR centres NAV 1
    - Mapping: install and binding steps with a heading bug check, what
    does nothing per family, a pilot's view of each family, the GTN's
    radios hedged, MobiFlight 11.2; compatibility names the profile
    that fits each reference aircraft
    - Tests: the docs' lists and the binding check read from the docs,
    near rounding half up as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
    [test_mobiflight.py]
2026-11-13 Wake a suspended host for every change it would miss
    - Ask a suspended host to resume when input waits or it has something
    other than what the panel shows; a send that waited out its 2 s is
    the request, every request stalls the panel and keeps the queued
    knob steps, a host that is back gets the joysticks' reports again
    and the keyboard goes on from the report it kept; after a refusal
    only input asks again, and a held key does not repeat while USB
    is down
    - Move the repeats and the end of SHIFT with a stall, pass both
    keypads' events on in scan order and read them with get_into;
    each keypad's queue holds 320 events
    - sim/hardware.py: keypad.Event and EventQueue.get_into as in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
    [boot.py, code.py, hardware.py, panel.py, test_boot.py, test_code.py, test_panel.py, test_sim.py]
2026-11-13 Measure the seats, check more of the board, order screws locally
    - Board checks: the legend against the LED cutouts as exact geometry,
    each file's layer and polarity, the zip against the files, the
    paste sizes and the exposed pad's share, THT-LCSC.csv, the bottom
    legend's mirroring on the title, routed nets on board.py's nets,
    own legend limits with the V-cut groove counted; the BOOT legend's
    second line moves clear of that groove
    - Fit check: the knobs' seats, crests and heights, the body's cavity,
    floor, plug opening, post, screw and BOOT holes, and the plate's
    pocket corners, tap drills and countersinks measured on the solids;
    a support mark under the knobs' bottom faces,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
2026-11-13 Fix the simulator, the page and the build's weak spots
    - Simulator: a second Ctrl-C still stops the panel and then lets go of
    the output, a page reloads when it reconnects to another build, no
    traceback for an answer the page gave up on, the vJoy message says
    how to try the page alone
    - Page: one detent per wheel notch of any size, the panel fits under
    the header and above or beside the lines, a chorded click lets go, no
    dimmed button after a reconnect, caps 1.95 mm proud
    - Tests: the firmware error test waits for code.py's loop, the
    keystroke flags and vjoy-setup.bat's button counts are checked
    - build.sh: signals stop the routing too, also with stty tostop, the
    OpenCascade fi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
    [page.py, test_page.py, test_sendinput.py, test_vjoy.py, vjoy.py]
2026-11-13 Map the G1000's softkeys, add a KFC 150 profile, squawk 7000
    - G1000: unit 2 works the PFD's FMS keys and knob, SHIFT with RANGE its
    inset map; STD toggles through the PFD's STD Baro softkey at 29.92;
    HOME toggles the MFD's engine menu; MAP, TERR and VNAV press the MFD
    map page's Charts, Checklist and Detail softkeys, MSG, NRST and ARM
    the PFD's Alerts, Nearest and Tmr/Ref
    - GNS: SHIFT with RANGE is the GNS 430's RNG; GTN: SHIFT with RANGE is
    the GTN 750Xi's volume knob and its push
    - KFC 150: a profile for Black Square's KFC 150 and KAS 297B, their
    dimmers and GTX 327, with the GNS, TDS and pms50 navigators as Black
    Square names their inputs, RANGE on the GNS 530 and SHIFT wit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
